MrMicek/AETS/diagramy diplomka svg flashka/photos/test setup.JPG

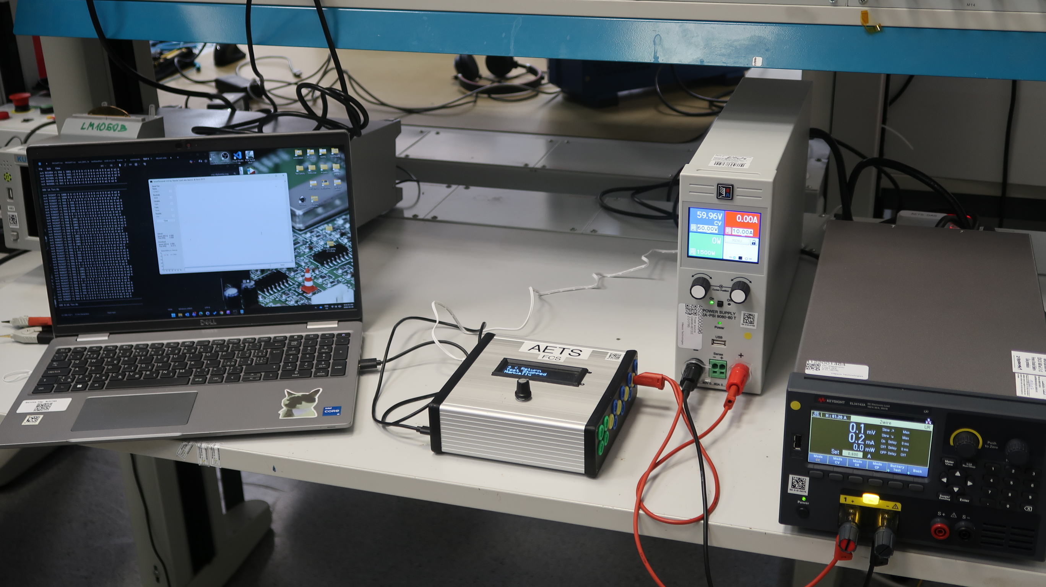
diagramy diplomka svg flashka/photos/test setup.JPG
