MrMicek/AETS/diagramy diplomka svg flashka/photos/final box test.JPG

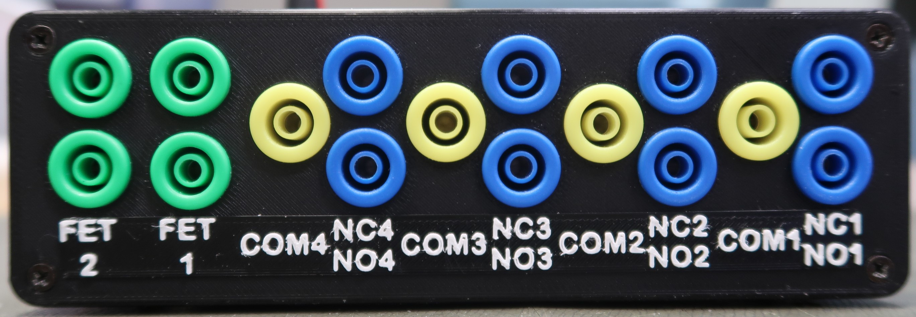
diagramy diplomka svg flashka/photos/final box test.JPG
