MrMicek/AETS/diagramy diplomka svg flashka/AETS_School_presentation.pptx

Převodník komunikace pro EMC komoru

## Automatizovaný systém pro elektrické testování komponent v automobilovém průmyslu

Autor:
Bc. Vojtěch Míček
Vedoucí práce:
doc. Ing. Hercík Radim, Ph.D.

## Body zadání

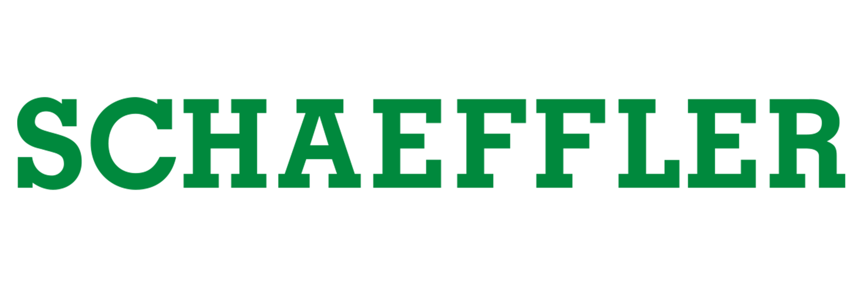
[picture p3: figure]
logo

- Návrh, výroba a otestování automatizovaného systému, který bude sloužit pro provádění elektrických testů automobilových komponent.
- Součástí řešení bude:
  - monitorování průběhu testu
  - Záznam o opotřebení el.mechanických součástek
  - Řízení pomocí PC

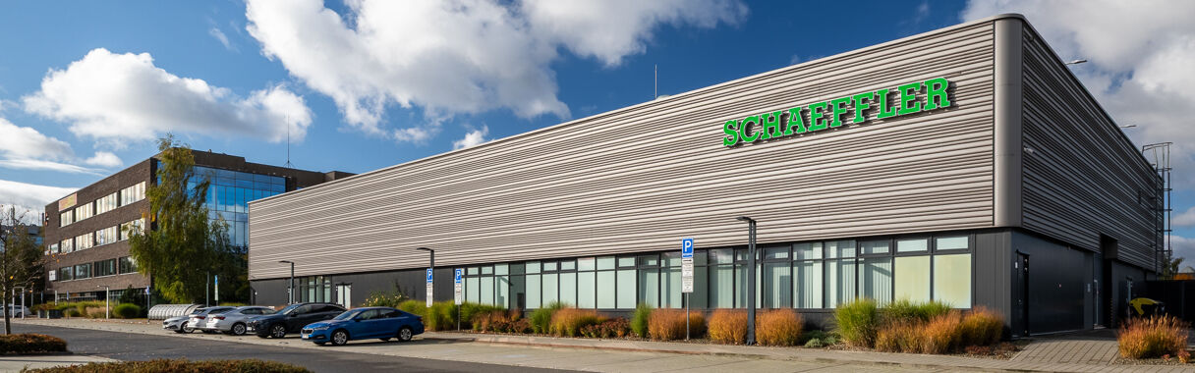
[picture p4: figure]
Schaeffler Motion Technologies CZ s.r.o. – Ostrava Hrabová image

## Účel zařízení

- Účel zařízení je poskytnou univerzální spínací platformu pro oddělení testování elektroniky, která zrychlí a zefektivní testovací procesy.
- Mezi hlavní testovací procesy pro které toto zařízení bylo vyvíjeno jsou ON/OFF testy a testování náběhových proudů.
- Možnost manuálního a vzdáleného řízení zařízení vytváří možnost rychlé přípravy testu a jejich automatizaci s kombinací softwarových aplikací např. LabVIEW.

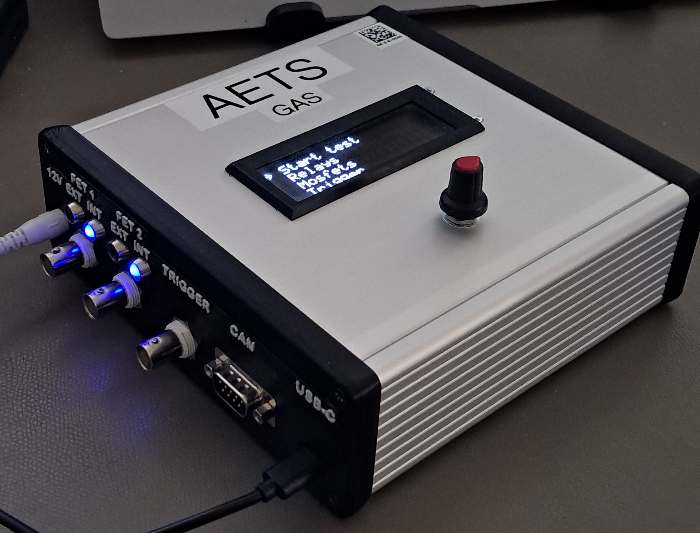
[picture p5: figure]

## Analýza výchozího stavu

- Zařízení má nahradit současné obvody v laboratoři (viz. foto) a poskytnout univerzální platformu, která zkombinuje relé a MOSFETové spínací prvky.

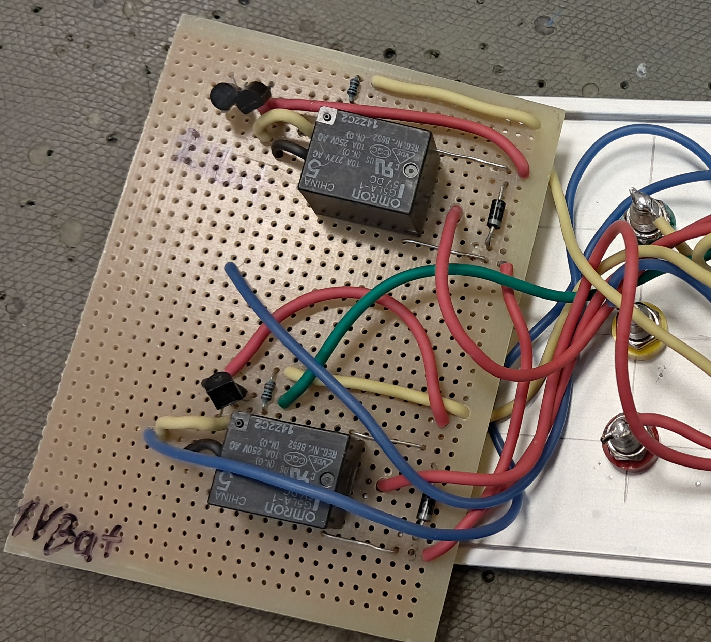
[picture p6: figure]
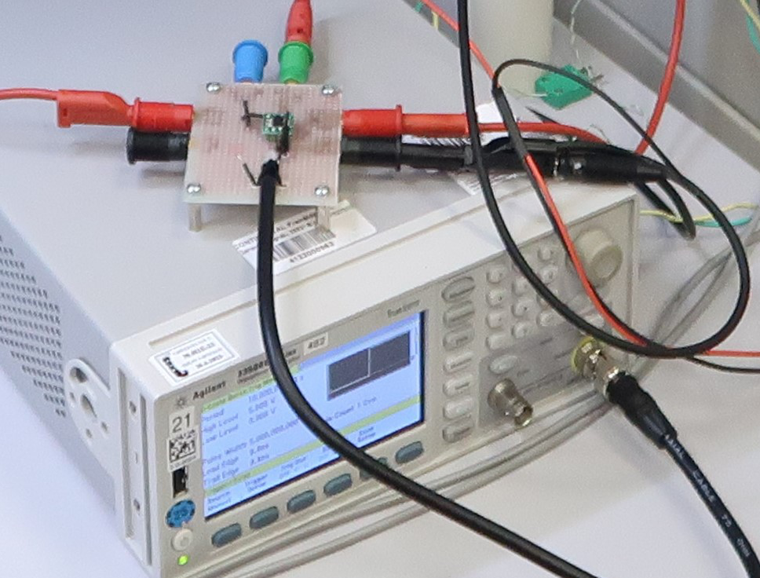
[picture p7: figure]
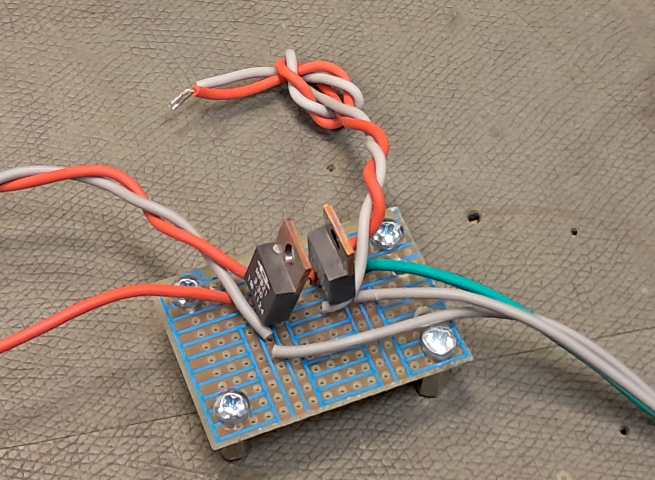
[picture p8: figure]

## Návrh funkce zařízení

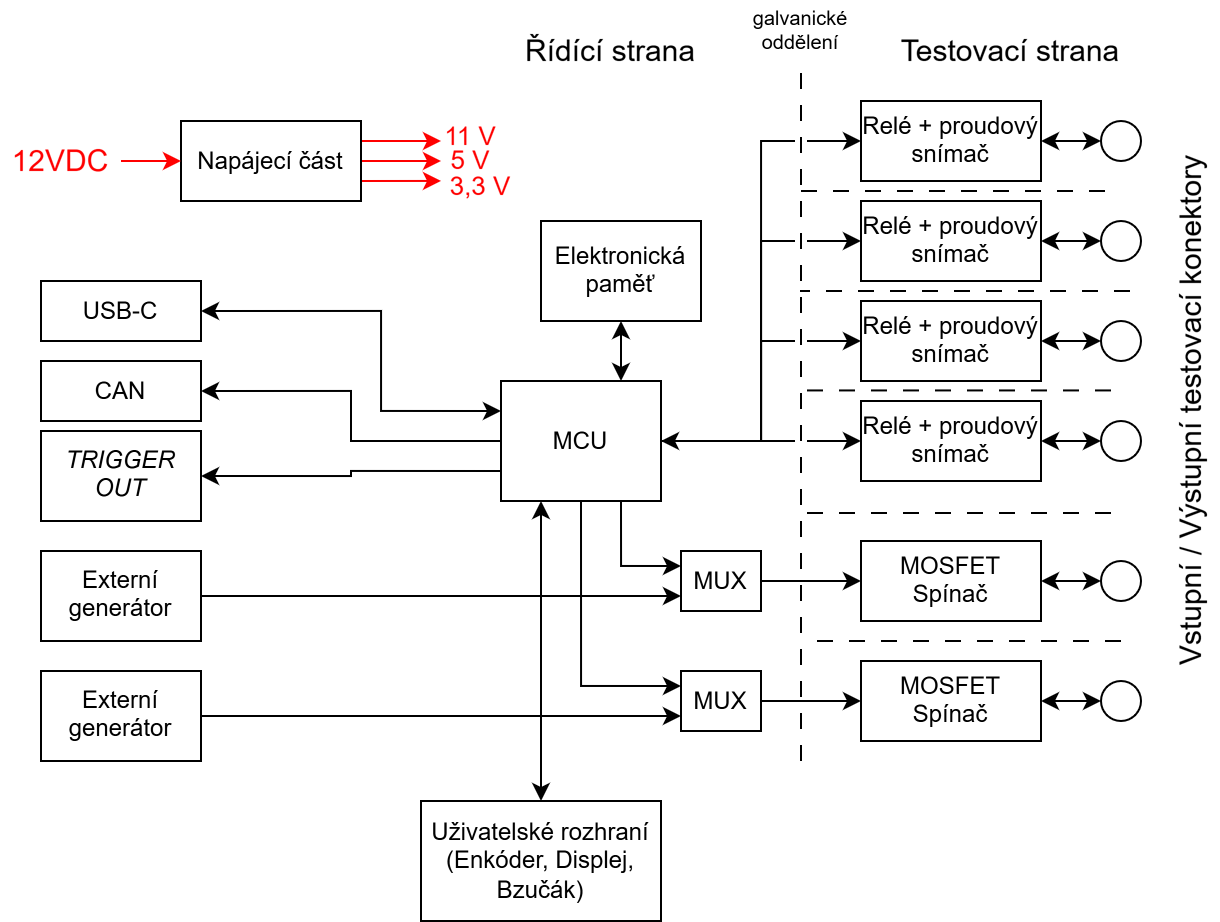
[picture p9: figure]

- Testovací inženýr nastaví pomocí uživatelského rozhraní nebo příkazy parametry řízení testovacích periferií.
- Galvanické oddělení mezi řídící a testovací stranou
- K dispozici přídavné funkce:
  - Výstupní trigger signal pro synchronizaci
  - Řízení MOSFETů pomocí externích generátorů
  - Ukládání dat do elektronické paměti (profily s nastavením, zbývající počet cyklů relé)

## Průběh návrhu zařízení

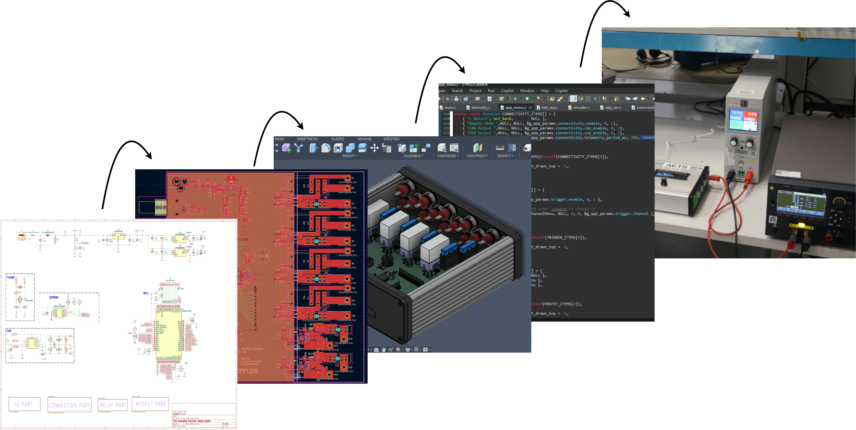
[picture p10: figure]

Testování

Relizace HW

Kód (C)

3D model

Návrh PCB

Schéma

## Schema + deska - realizace

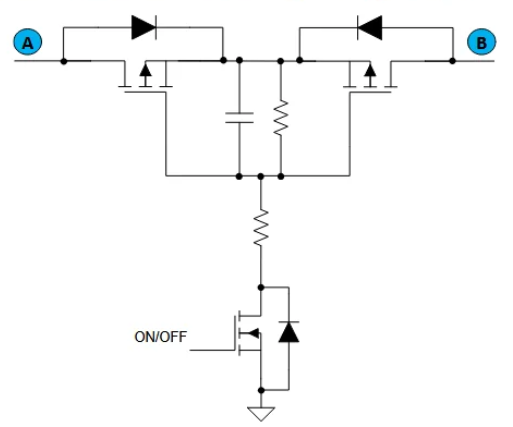
[picture p11: figure]

Popsat periferie? Zmínit vyměnitelnost HW? Jednoduchost používání pro Testaře? Nějaké schéma?

## Body zadání

Záznam o opotřebení el.mechanických součástek

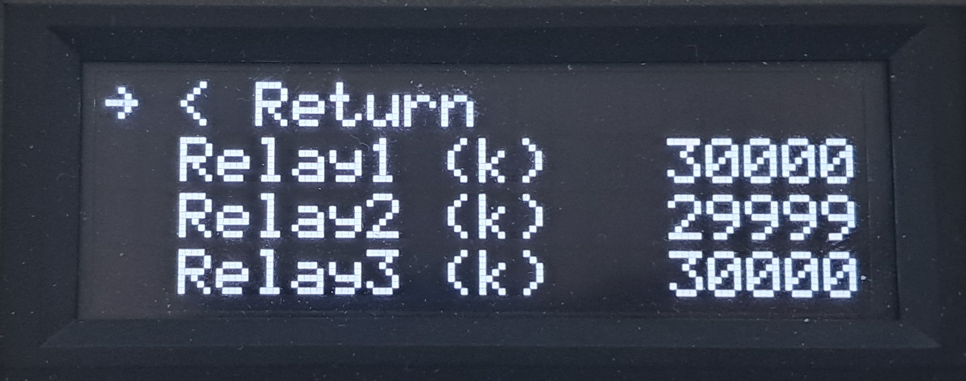
[picture p12: figure]

Interní sledovač proudu

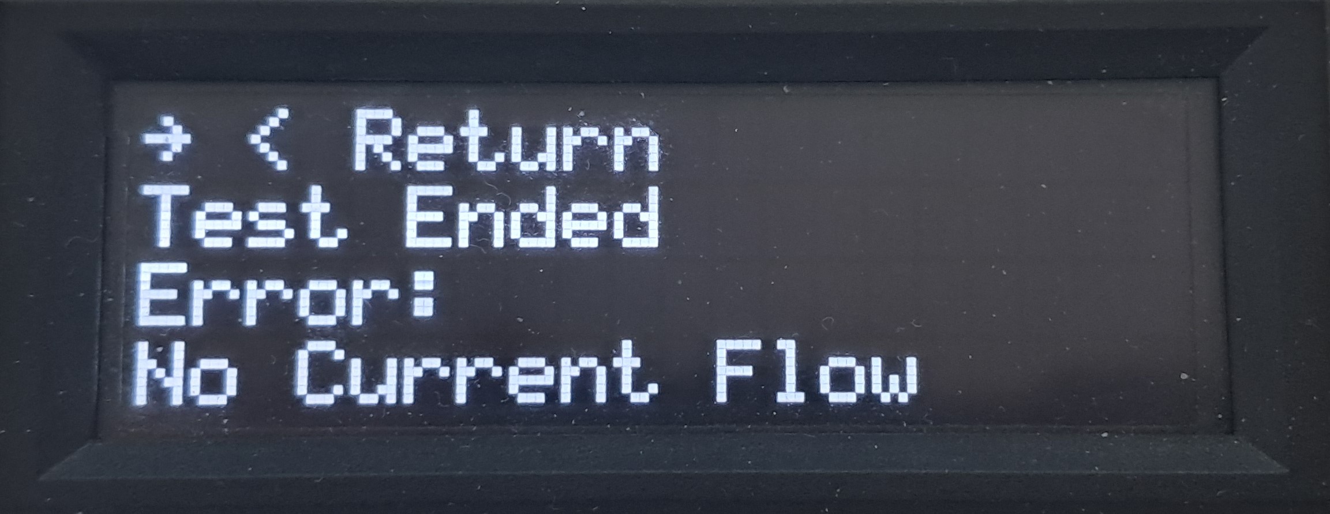
[picture p13: figure]

Řízení pomocí PC

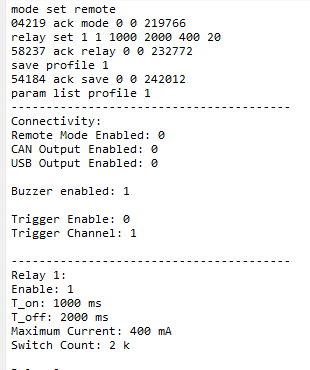
[picture p14: figure]
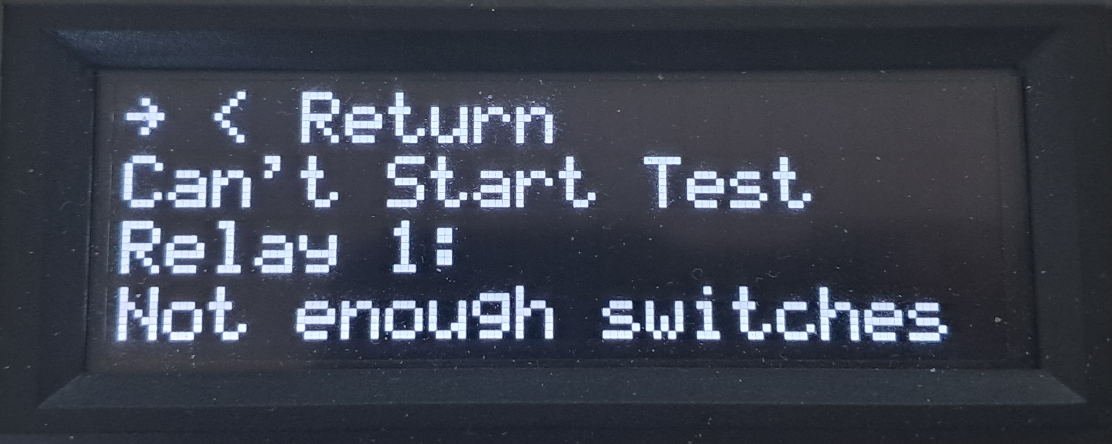
[picture p15: figure]
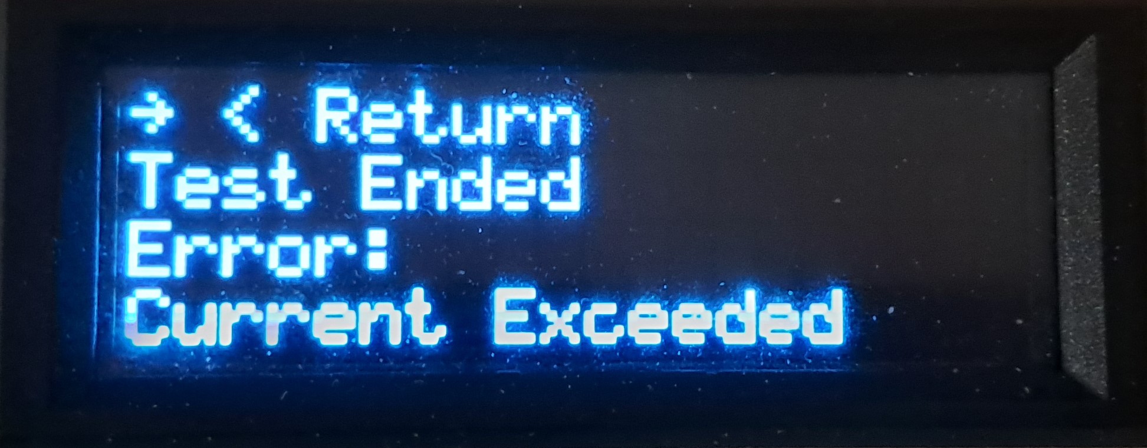
[picture p16: figure]

## Deska plošných spojů

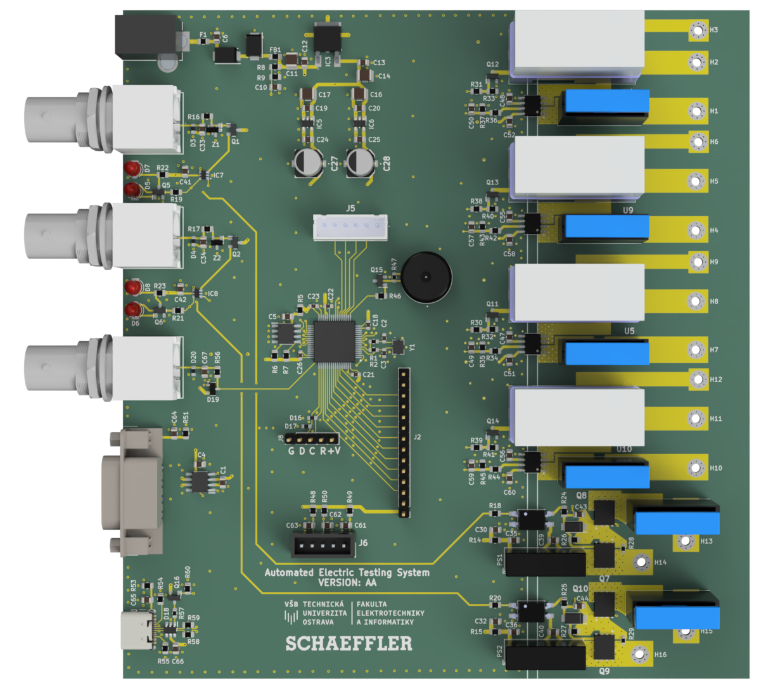
[picture p17: figure]
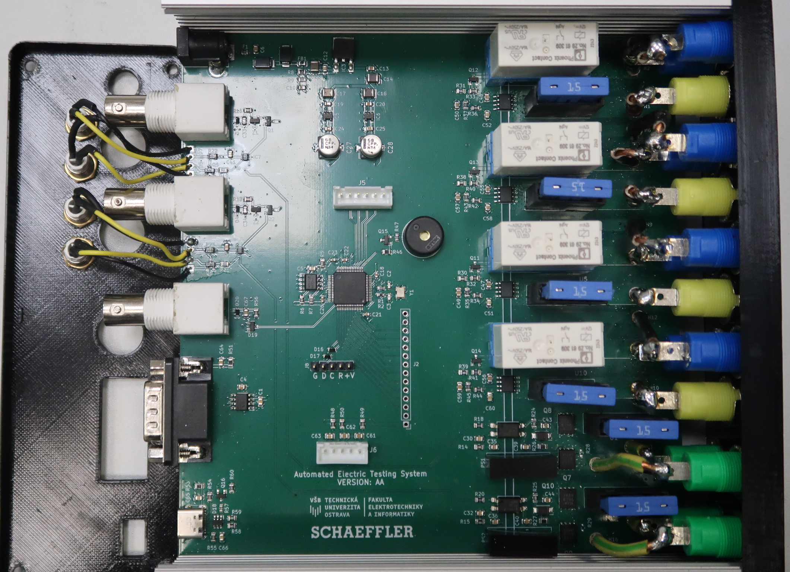
[picture p18: figure]

## Popis použití a parametrů periferií

Nastavení způsobu ovládání
Nastavení parametrů jednotlivých kanálů
Zapnutí testu
Sledování průběhu testování
Vyhodnotit výsledky testu

Relé
- Aktivace kanálu
- doba zapnutí
- doba vypnutí
- počet cyklů
- vnitřní mezní hodnoty proudu

MOSFETy
- Aktivace kanálu
- doba zapnutí
- doba vypnutí
- volba interního nebo externího řízení
- počet cyklů

Systémová konfigurace
- Nastavení výstupního trigger
- Nastavení komunikace
- Ukládání nastavení parametrů v profilech
- Aktivace interního sledování proudu

## Maximální testovací parametry

Relé

4 kanály
Trvalý proud na větev:
Min. proud: 10 mA*
Max. proud: 2.5 A
Max. spínané napětí: 60 VDC

MOSFETy

2 páry obousměrných MOSFETů
Trvalý proud na pár:
Max. proud: 5 A
Max. náběžný proud(<300 µs): 40 A
Max. spínané napětí : 80 VDC

Dynamika spínání

Typická doba odezvy relé: 7 ms
Typická doba vypnutí relé: 3 ms
Doba odskoku relé: ~2 ms
MOSFET čas náběžné hrany:
min: 700 ns max: 1000 µs
MOSFET čas sestupné hrany:
min: 2 µs max: 4 µs

## Testování Firmware

## Testování zařízení – spínání relé

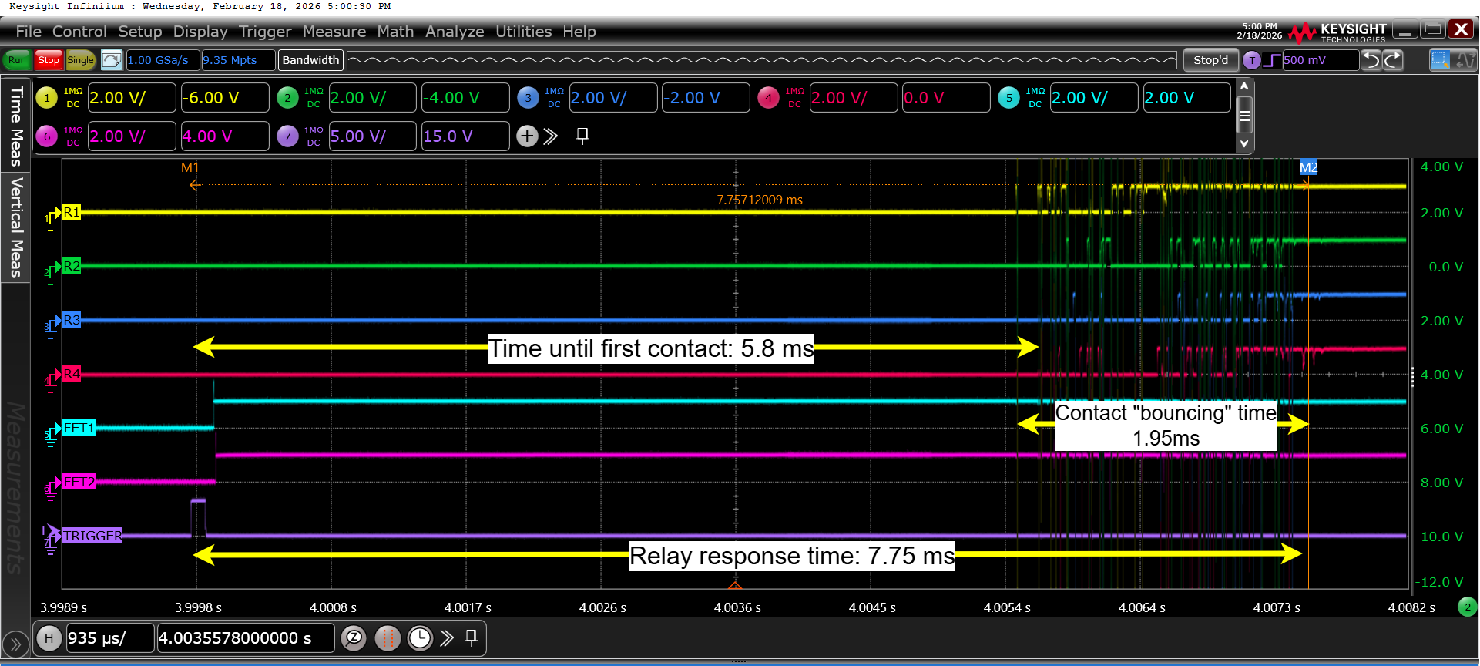
[picture p19: figure]
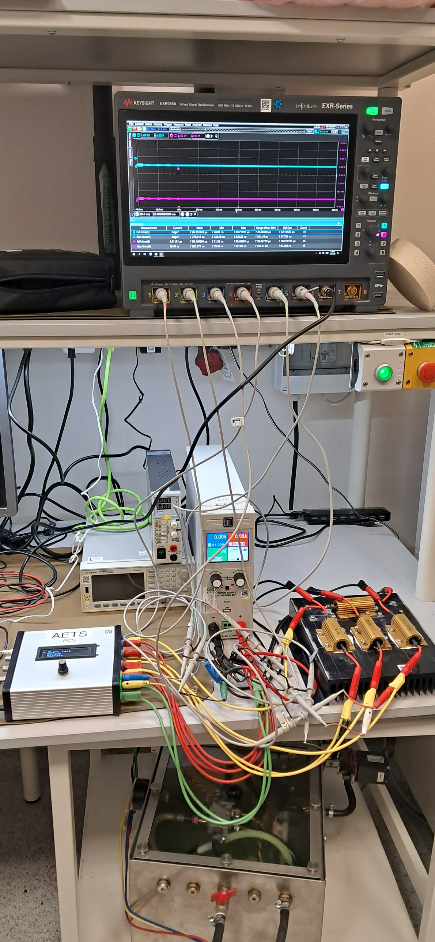
[picture p20: figure]

## Testování zařízení – rychlost MOSFETů

Rise time

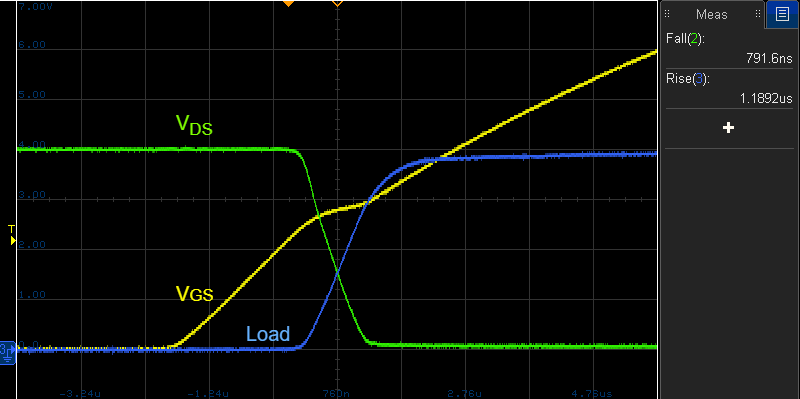
[picture p21: figure]

Fall time

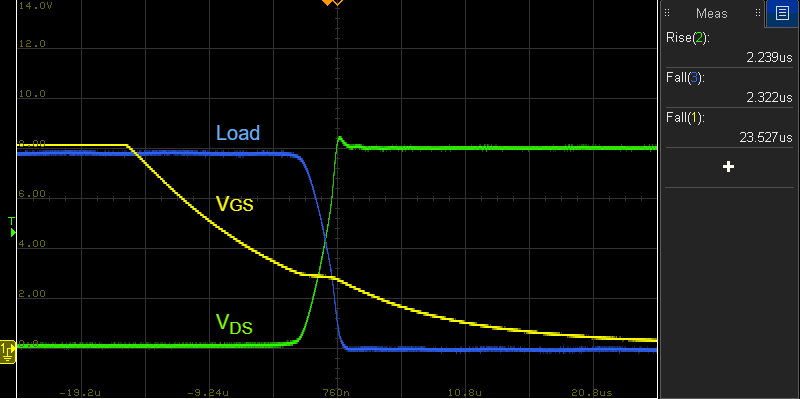
[picture p22: figure]

## Testování zařízení – náběhový proud

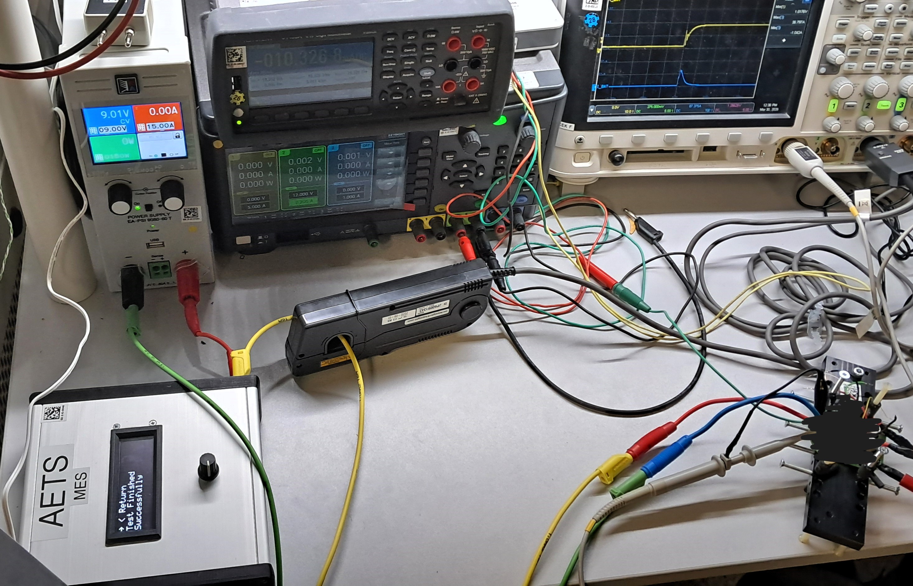
[picture p23: figure]
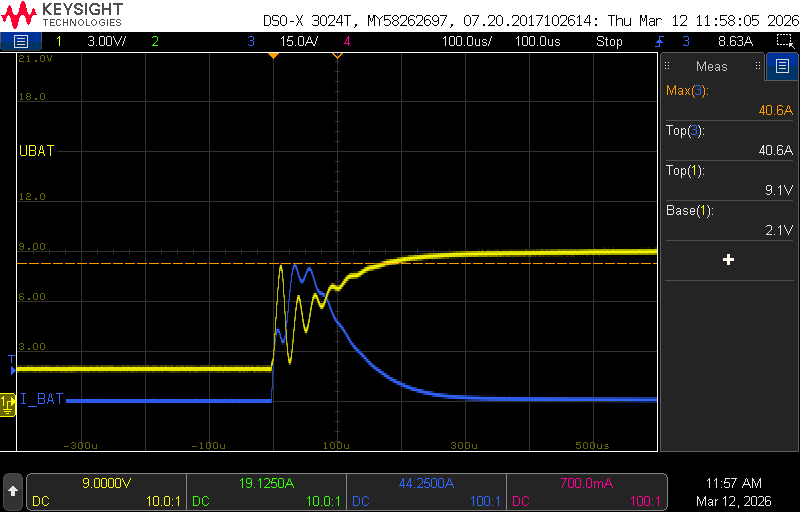
[picture p24: figure]

## shrnutí

## Slide 18

Děkuji za pozornost
