MrMicek/AETS/diagramy diplomka svg flashka/AETS_Presentation.pptx

## Introduction to E-BOX AETS

Vojtěch Míček
16.4.2026

Diploma thesis: E-BOX AETS

## Basic description of the system

- Diploma thesis: E-box aets

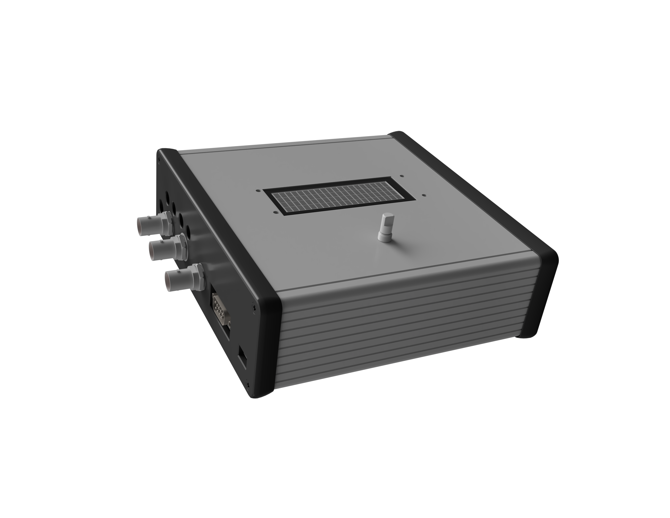
[picture p25: figure]

AETS
Automated Electrical Testing System

Laboratory equipment for electrical testing of automotive components
Combines relay and MOSFET branches, local UI and PC control
Designed for faster, repeatable, safer and easier testing

## Why was the device developed?

- Diploma thesis: E-box aets

Need in practice

Acceleration of repetitive electrical tests
Universal platform across EE Teams
Reproducibility of test sequences.

What it does

Switching of tested branches
Basic internal supervision of test progress
Communication with host PC with option to remotely control the device

Typical usage

ON/OFF tests
Switching sequences
Fast switching for INRUSH current testing
Long-term cyclic tests

## Brief description of how the system works

- Diploma thesis: E-box aets

PC/LabView
Manual setup
MCU logic & sequence control
Relays
MOSFETs
DUT
Measurement
devices

Relays
Low contact resistance (~15mΩ), suitable for normal ON/OFF sequences and long-term cycles

MOSFETs
Bidirectional structure, short pulses, and monitoring of transient signals.

Additional functions
Advanced UI, Trigger, Relay cycle counter & current monitoring, External MOSFET control

## Brief description of how the system works

- Diploma thesis: E-box aets

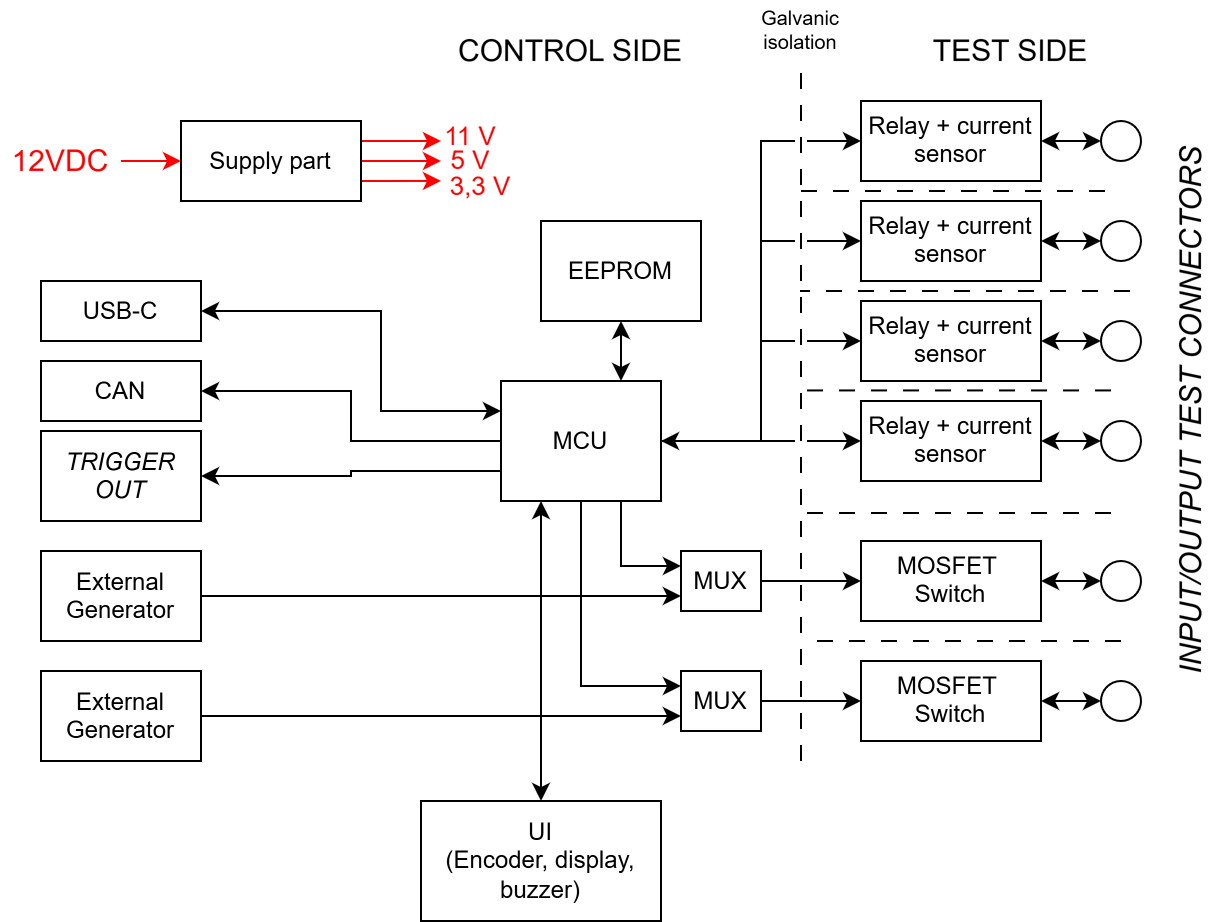
[picture p26: figure]

## Connectors and interfaces

- Diploma thesis: E-box aets

Control Connectors

- 12 V DC power supply jack
- 2x BNC input for external control of MOSFETs
- BNC TRIGGER output for synchronization
- DSUB-9 CAN OUTPUT for extended communication
- USB for connection to a PC and remote control

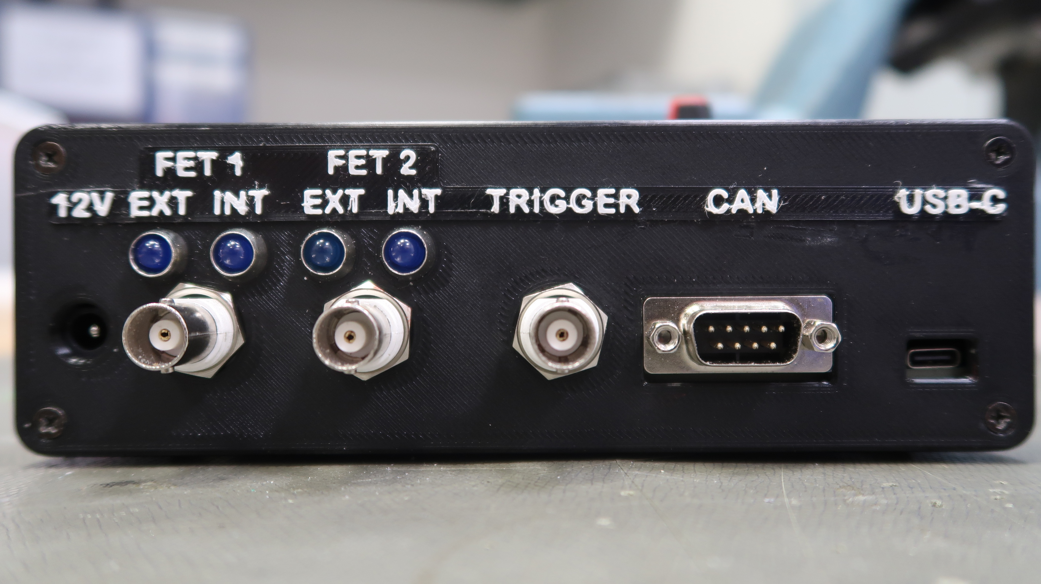
[picture p27: figure]
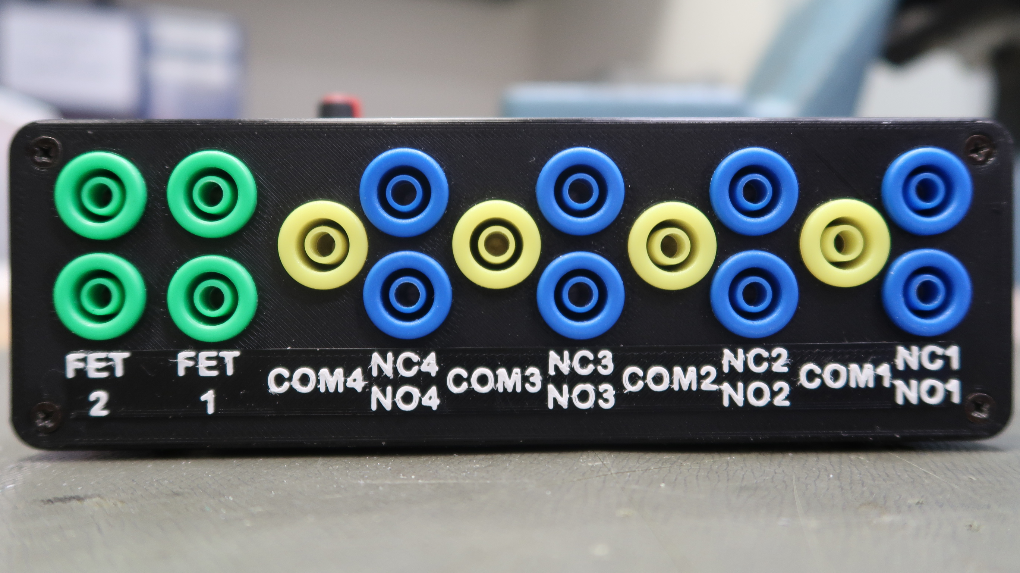
[picture p28: figure]

Test Connectors

  - 4 Relay Branches
  - 2 MOSFET switch pairs

## Complete Assembly

- Diploma thesis: E-box aets


## System configuration

- Diploma thesis: E-box aets

Relays
Channel enable, turn-on time, turn-off time, number of cycles, and internal current control limits.

MOSFETs
Channel enable, turn-on time, turn-off time, internal or external control selection, and number of cycles.

System options
Trigger, communication and data storage in profiles.

Select control mode
Configure channels and timing
Run test
Monitor test progress
Evaluate test results

## System configuration

- Diploma thesis: E-box aets

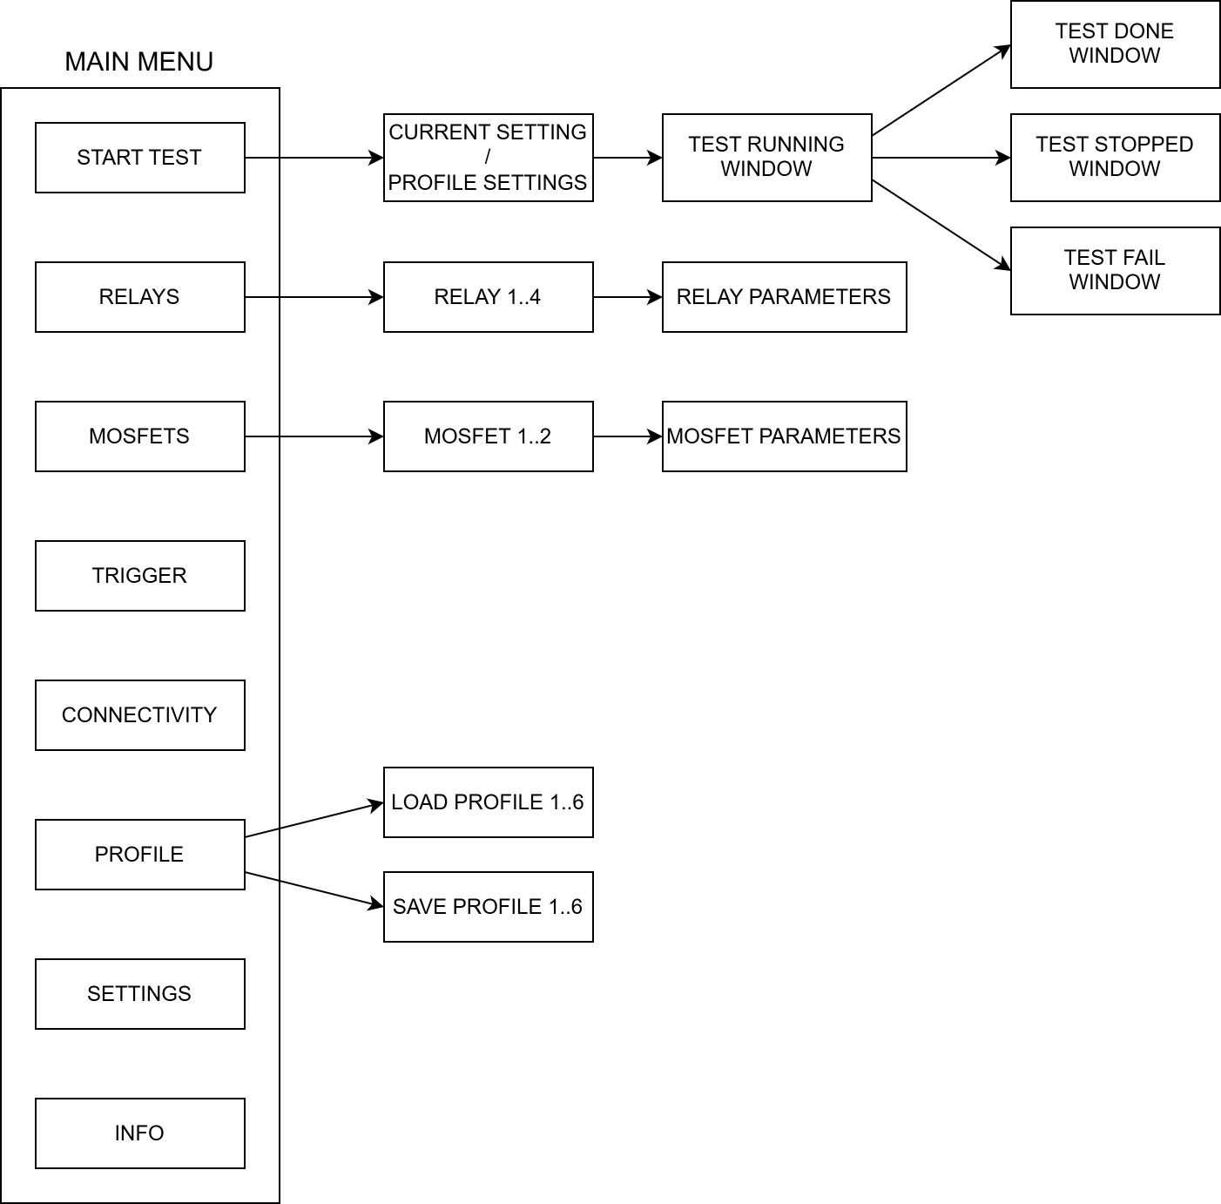
[picture p29: figure]
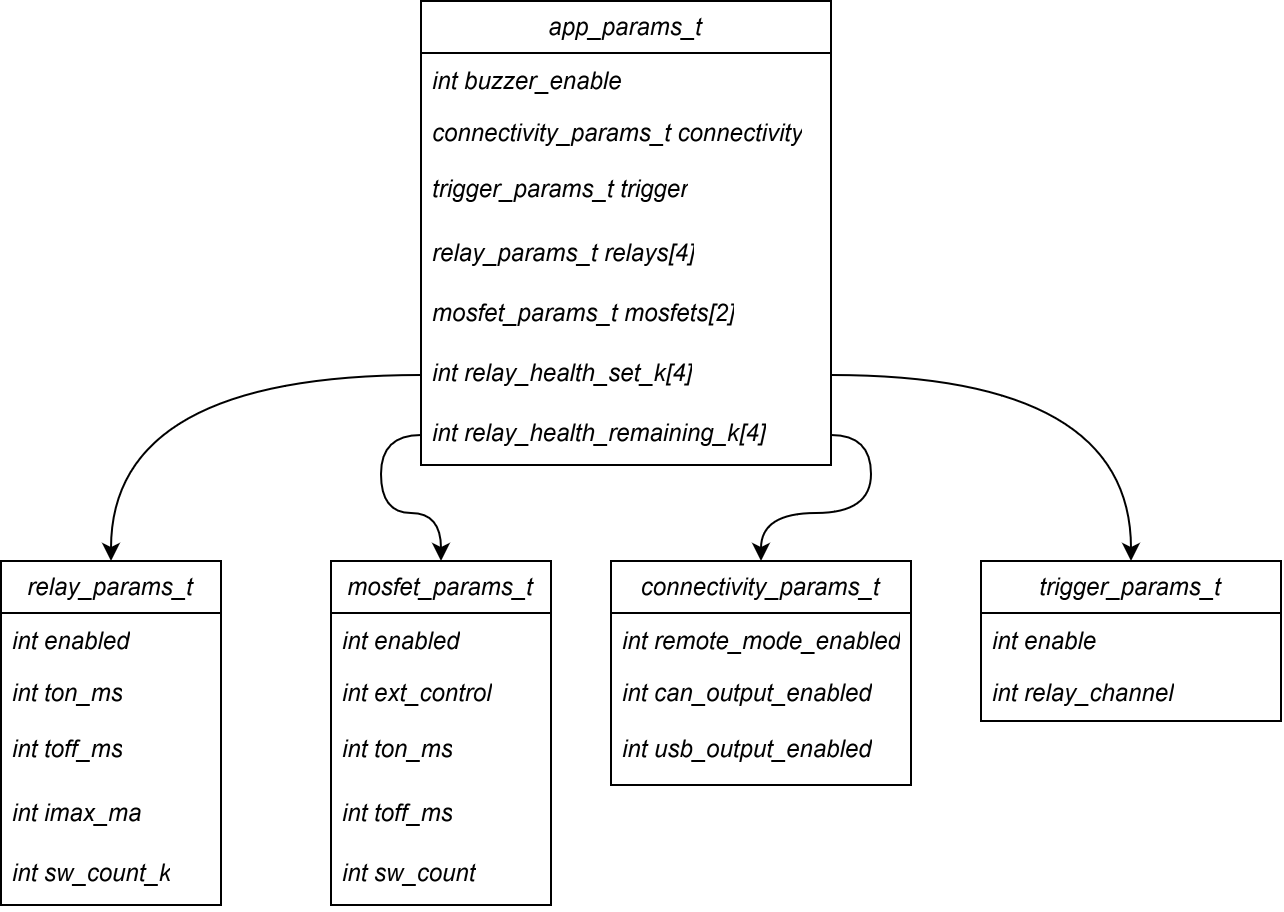
[picture p30: figure]

## Basic navigation and modes

- Diploma thesis: E-box aets

MANUAL
Local operation via display and encoder. Suitable for quick function checks, servicing, and simple sequences.

REMOTE
Control from a PC via USB. Suitable for automation and integration into laboratory workflow.

TEST
Run sequence with supervision. In case of failure, the system will switch to a safe state and report the error.

The display shows the basic status of the device, function selection, and test progress.
The encoder is used to navigate the menu, change parameters, and confirm selections.
The system can be controlled remotely using commands and telemetry/status information can be obtained.
Important operating data is stored in EEPROM and is retained in the event of a brownout.

## Basic navigation and modes

- Diploma thesis: E-box aets

MANUAL

REMOTE

TEST

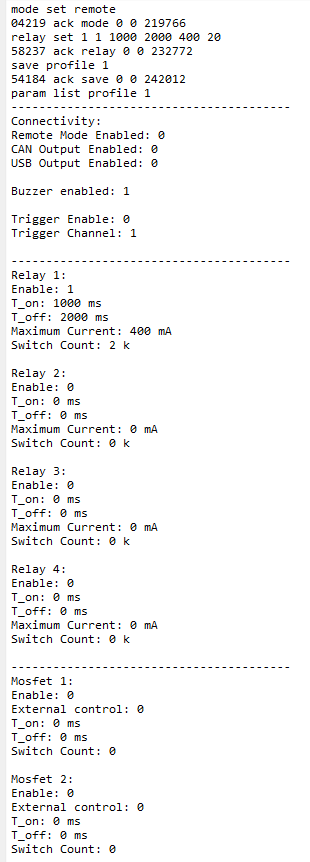
[picture p31: figure]
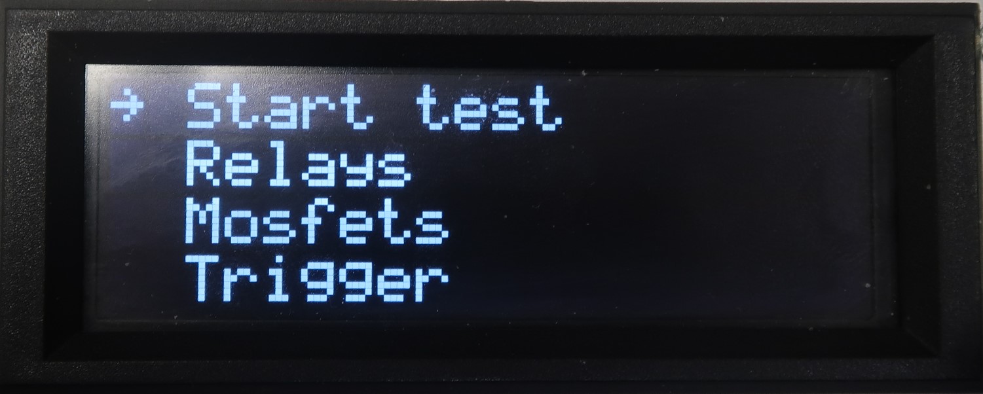
[picture p32: figure]
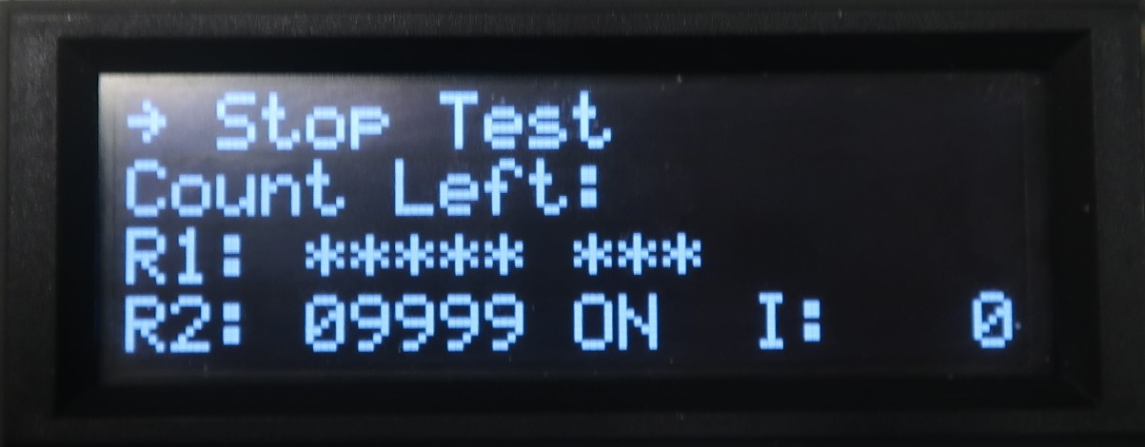
[picture p33: figure]
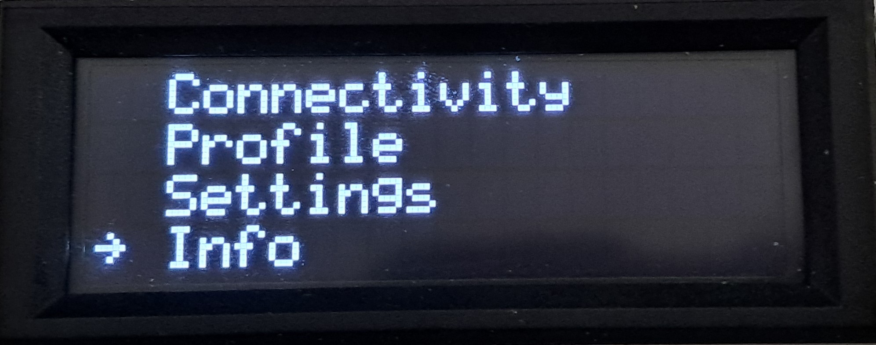
[picture p34: figure]
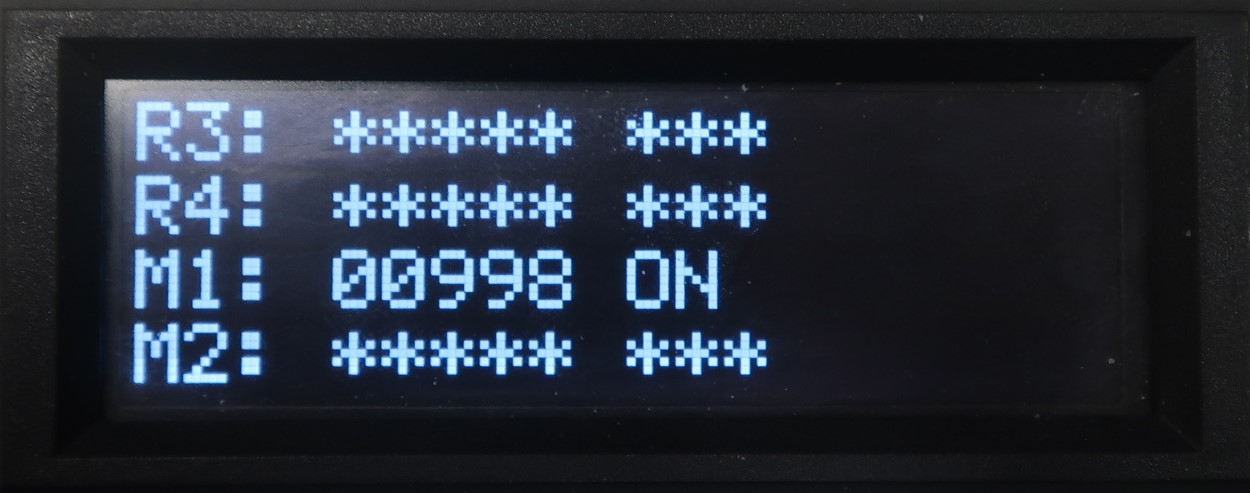
[picture p35: figure]

## Post-test screens

- Diploma thesis: E-box aets

DONE

STOPPED

FAULT

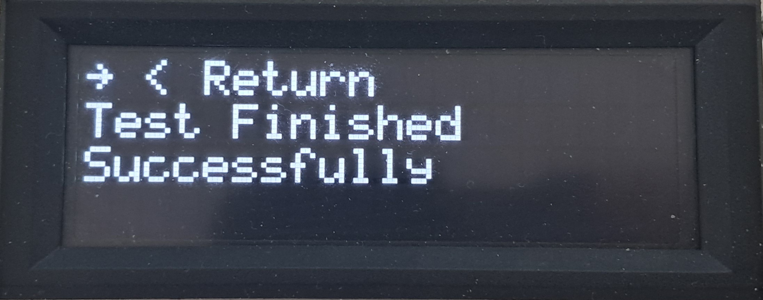
[picture p36: figure]
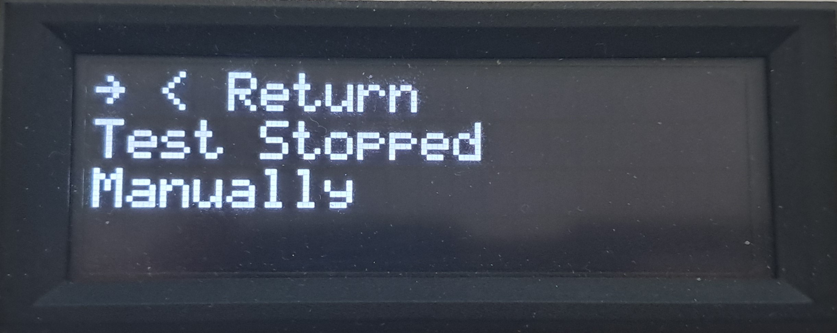
[picture p37: figure]

## Relay cycle counter managment

- Diploma thesis: E-box aets

Switch count value
The value of the number of switches was determined from datasheet and verified in test to be 3 million cycles.

Brownout event
If supply voltage of the device drops below a certain threshold, the device will stop all the current operations and save all important data to EEPROM. This includes relay cycles.


Prevention of excess relay use

If you set switch count higher, than the relay has remaining, this screen will appear to notify you.
You can’t start a test in this condition.

## Reading/editing relay cycles

- Diploma thesis: E-box aets

Remain Count
read only information


Relay menu screen

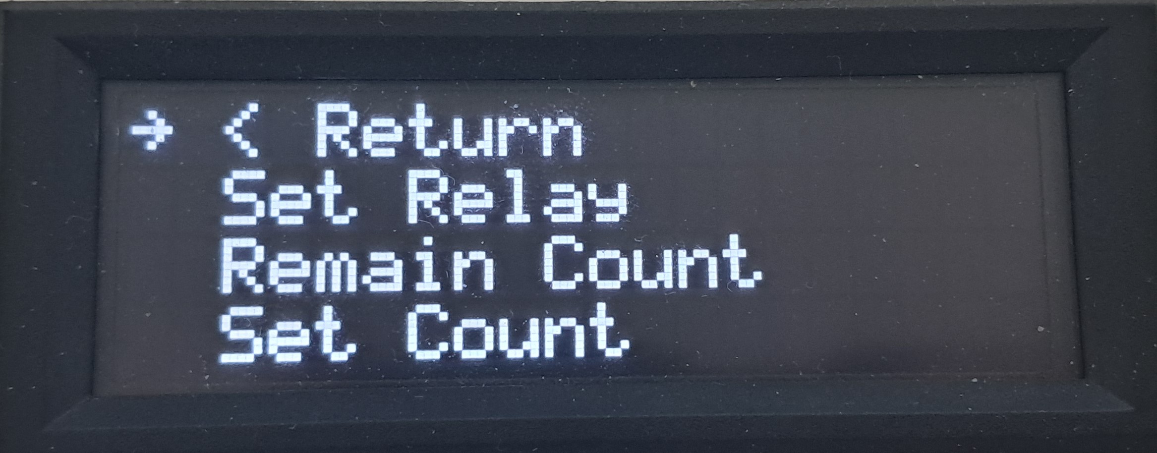
[picture p38: figure]

Set Count
read/write information

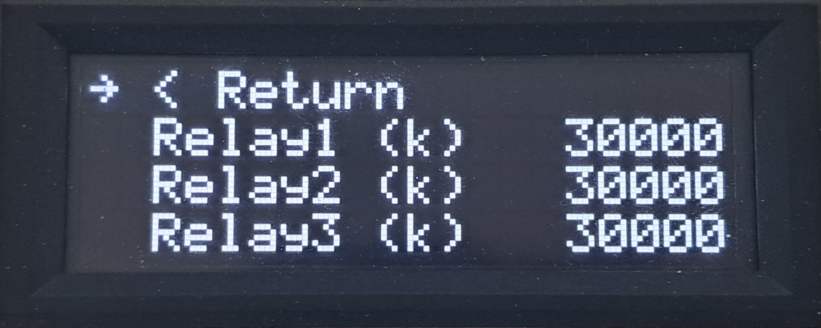
[picture p39: figure]

## Maximum values and performance

- Diploma thesis: E-box aets

RELAYS

4 channels
Continuous current per branch:
Min. current: 10 mA
Max. current: 2.5 A
Max. switching voltage: 60 VDC

MOSFETS

2 pairs of back-to-back MOSFETs
Continuous current per pair:
Max. current: 2.5 A
Max. inrush current (<300 µs): 40 A
Max. switching voltage: 80 VDC

Switching dynamics

Relay typical response time: 7 ms
Relay typical release time: 3 ms
Relay bounce time: ~2 ms
MOSFET rise time:
min: 700 ns max: 1000 µs
MOSFET fall time:
min: 2 µs max: 4 µs

## Relay response time test

- Diploma thesis: E-box aets

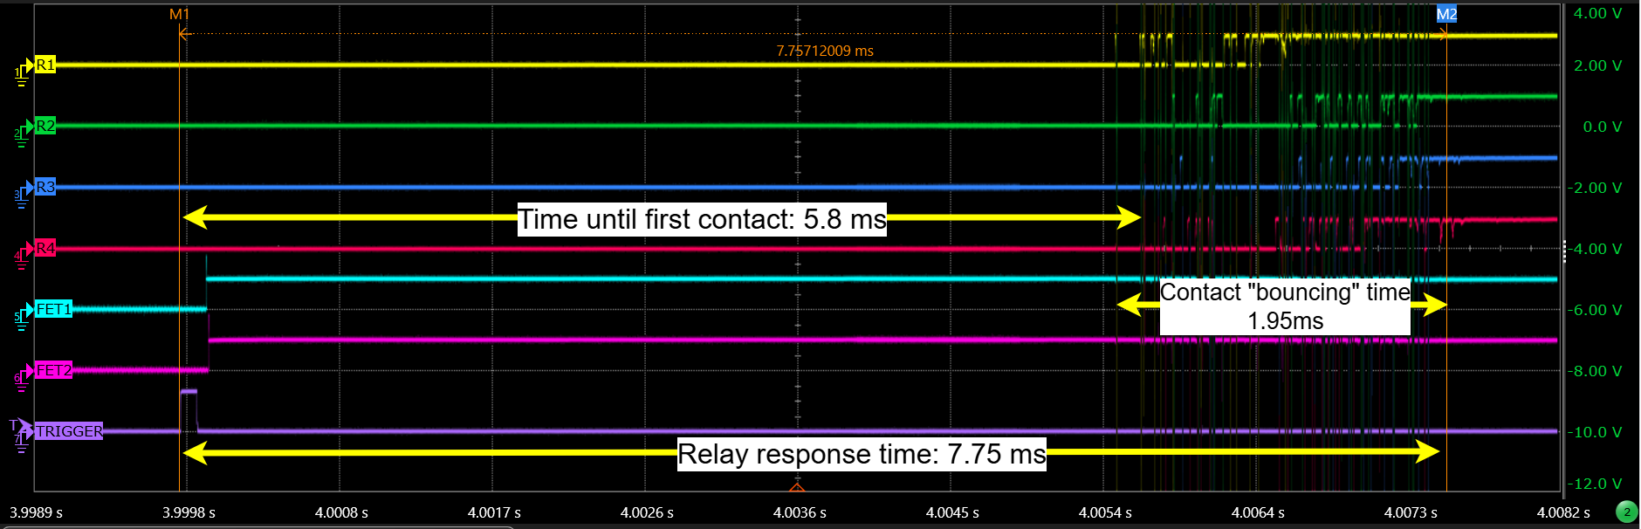
[picture p40: figure]

## MOSFET inrush current test – peak current test

- Diploma thesis: E-box aets


## MOSFET inrush current test – rise & fall time

- Diploma thesis: E-box aets

Rise time


Fall time


## How can the system make work easier for test engineers?

- Diploma thesis: E-box aets

Faster repetition of test sequences without manual switching
Integration of multiple switching options into a single device
Ability to control the test locally or remotely from a PC depending on the type of task
Easier synchronization with an oscilloscope or generator via trigger/BNC inputs
Storage of operating data and basic diagnostics of error states
Suitable basis for further expansion of test scenario automation in the laboratory

Conclusion

AETS is a practical laboratory platform that combines:
robust switching
fast MOSFET actions
local and remote control
simple measurement synchronization
Goal: to simplify and speed up electrical component testing.

## Slide 20

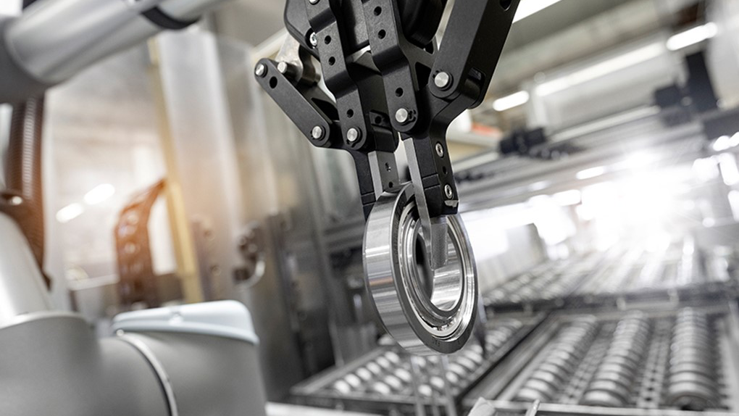
[picture p41: figure]

THANK YOU

## Slide 21
