MrMicek/AETS/diagramy diplomka svg flashka/diagramy diplomka svg/PLOTS/AETS-CZ-NB-3L0Y7S3_3D_BOT.png

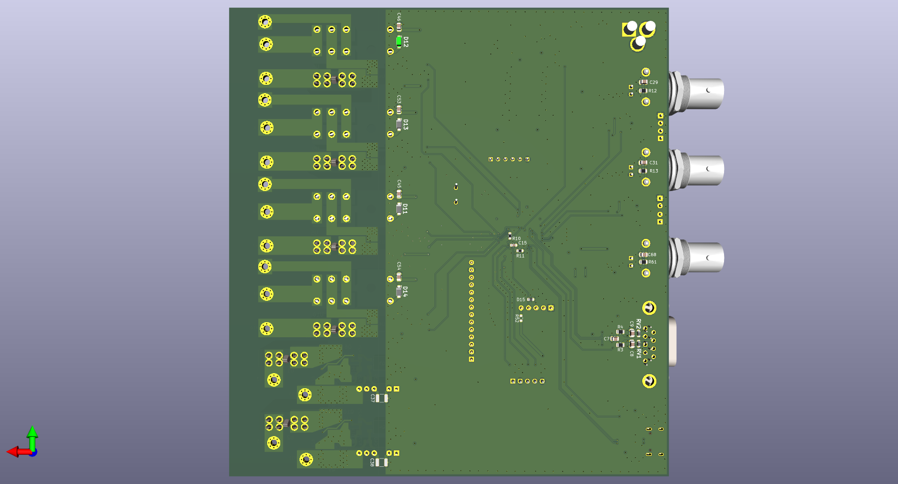
diagramy diplomka svg flashka/diagramy diplomka svg/PLOTS/AETS-CZ-NB-3L0Y7S3_3D_BOT.png
