MrMicek/AETS/diagramy diplomka svg flashka/diagramy diplomka svg/PLOTS/PCB/PCB BOX.png

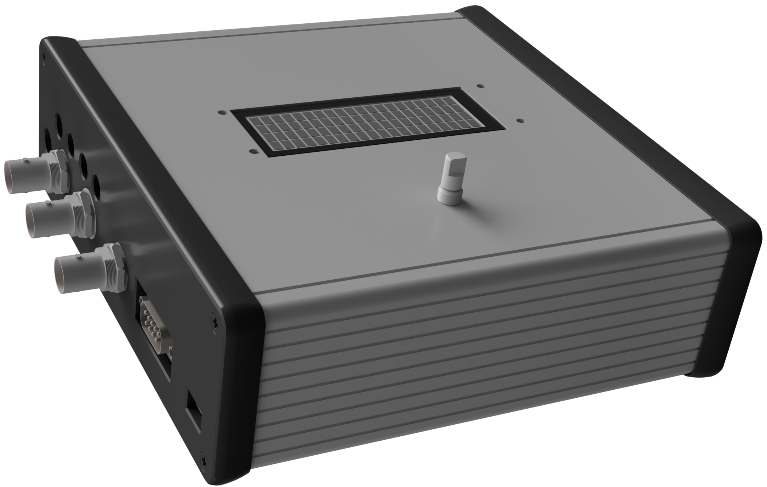
diagramy diplomka svg flashka/diagramy diplomka svg/PLOTS/PCB/PCB BOX.png
