MrMicek/AETS/diagramy diplomka svg flashka/diagramy diplomka svg/PLOTS/PCB/PCB.png

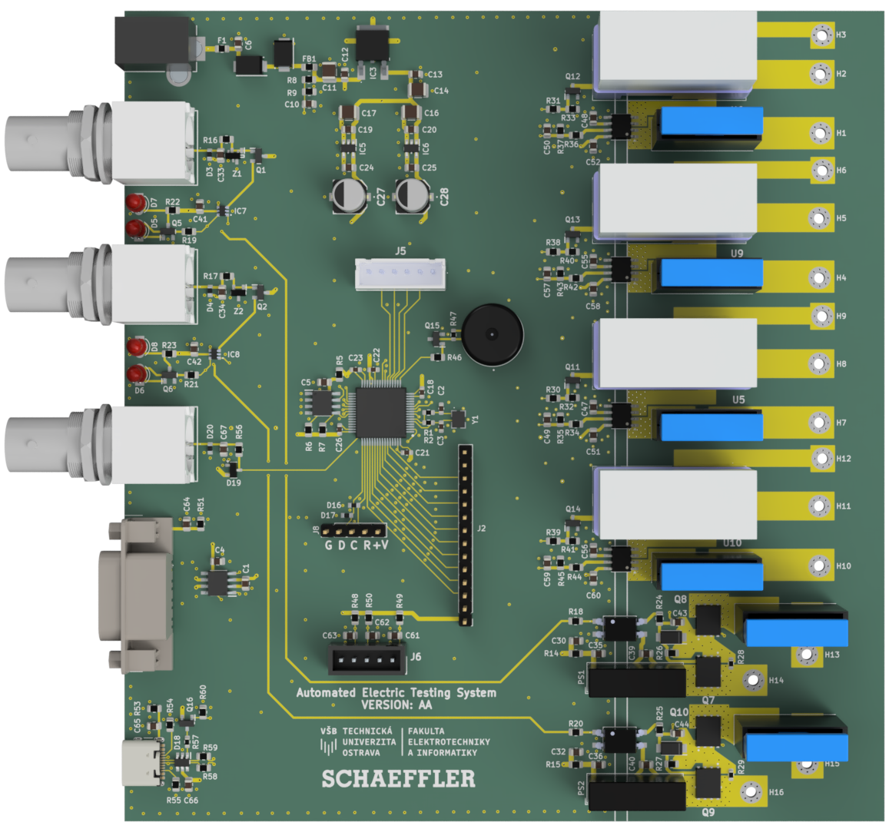
diagramy diplomka svg flashka/diagramy diplomka svg/PLOTS/PCB/PCB.png
