MrMicek/AETS/diagramy diplomka svg flashka/photos/20250919_095414.jpg

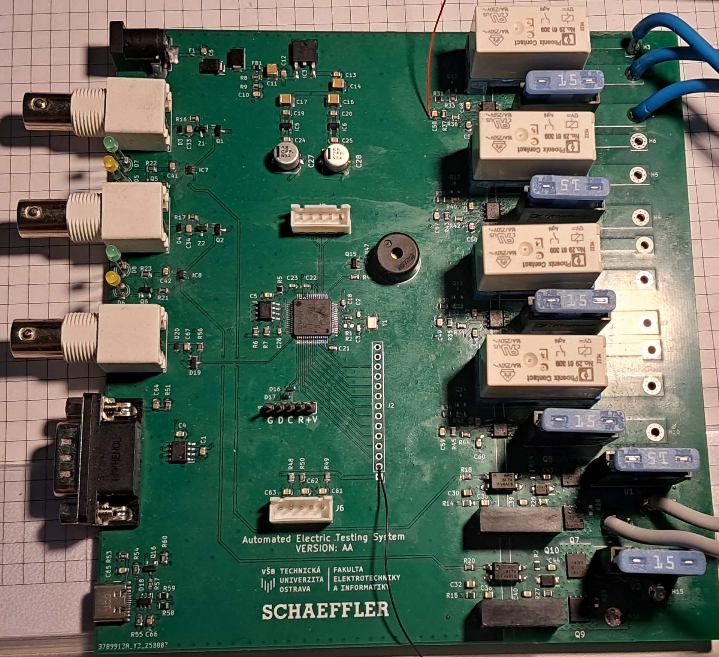
diagramy diplomka svg flashka/photos/20250919_095414.jpg
