MrMicek/AETS/diagramy diplomka svg flashka/photos/20260312_124507.jpg

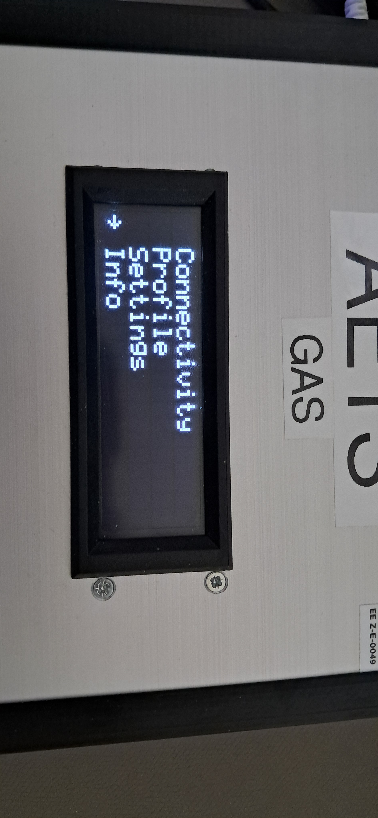
diagramy diplomka svg flashka/photos/20260312_124507.jpg
