MrMicek/AETS/diagramy diplomka svg flashka/photos/20260316_082853.jpg

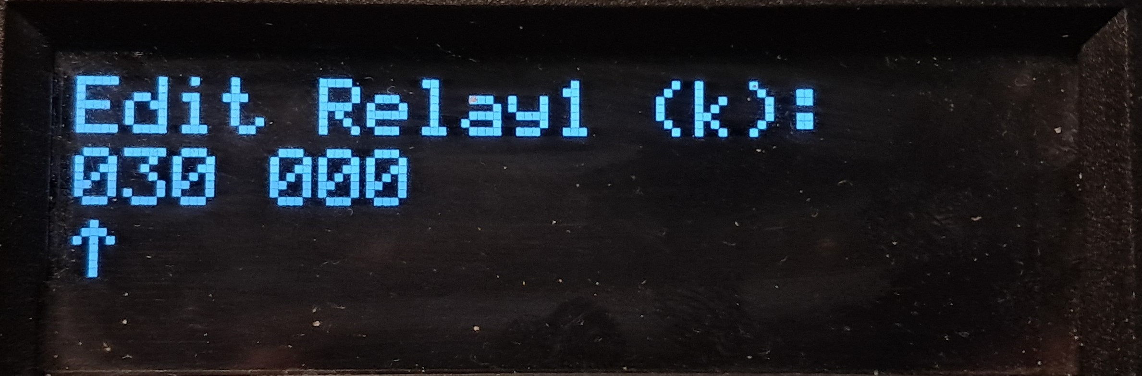
diagramy diplomka svg flashka/photos/20260316_082853.jpg
