MrMicek/AETS/diagramy diplomka svg flashka/photos/20260330_122323.jpg

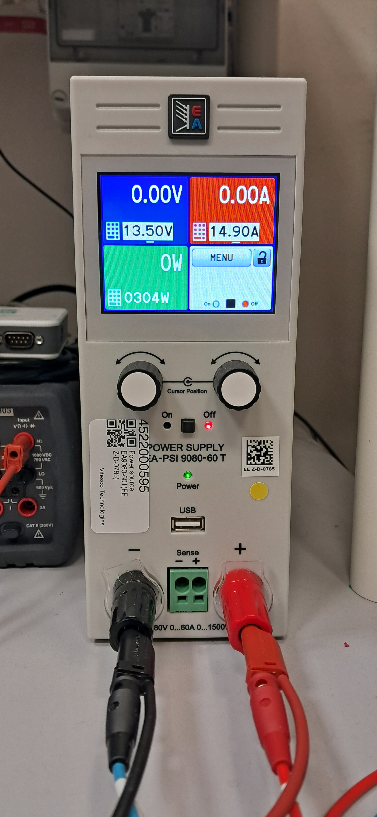
diagramy diplomka svg flashka/photos/20260330_122323.jpg
