MrMicek/AETS/diagramy diplomka svg flashka/photos/20260330_122909.jpg

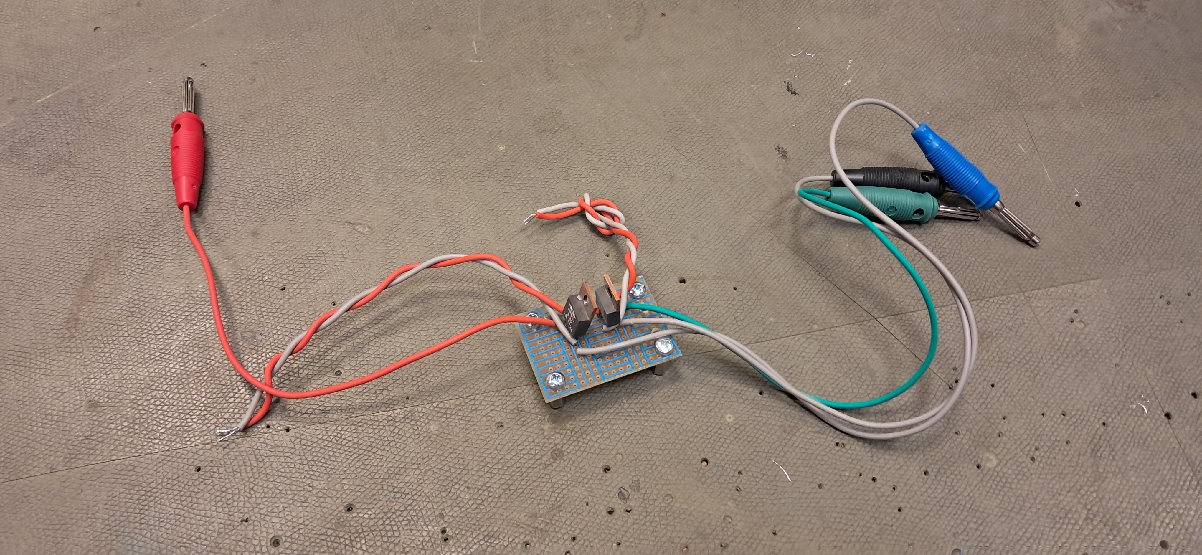
diagramy diplomka svg flashka/photos/20260330_122909.jpg
