MrMicek/AETS/diagramy diplomka svg flashka/photos/disasembly/disasembly1.png

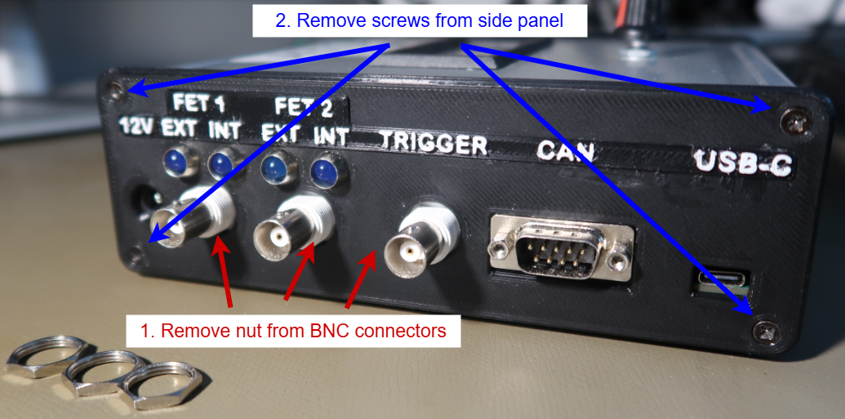
diagramy diplomka svg flashka/photos/disasembly/disasembly1.png
