MrMicek/AETS/diagramy diplomka svg flashka/photos/disasembly/disasembly2.png

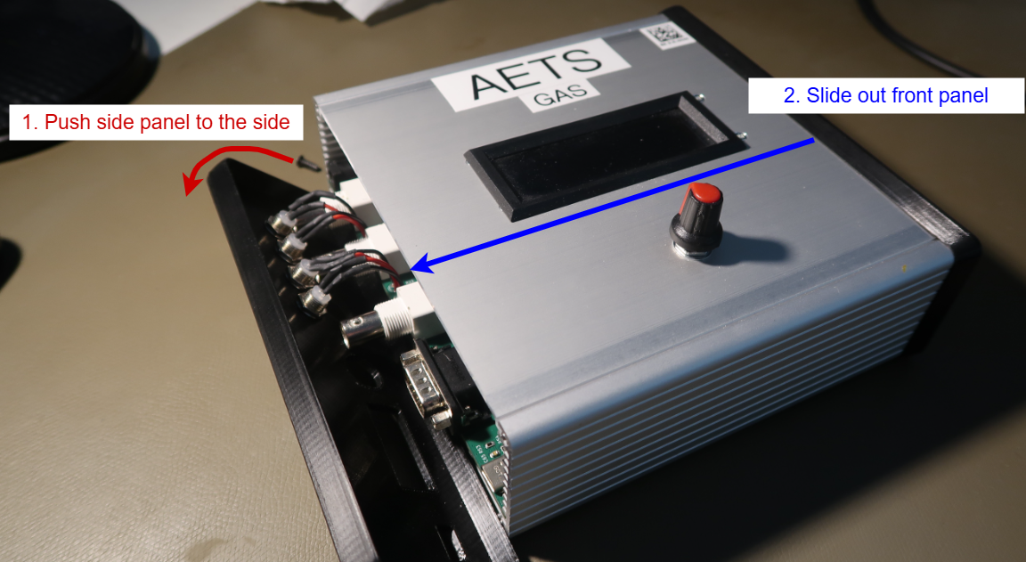
diagramy diplomka svg flashka/photos/disasembly/disasembly2.png
