MrMicek/AETS/diagramy diplomka svg flashka/photos/disasembly/disasembly3.png

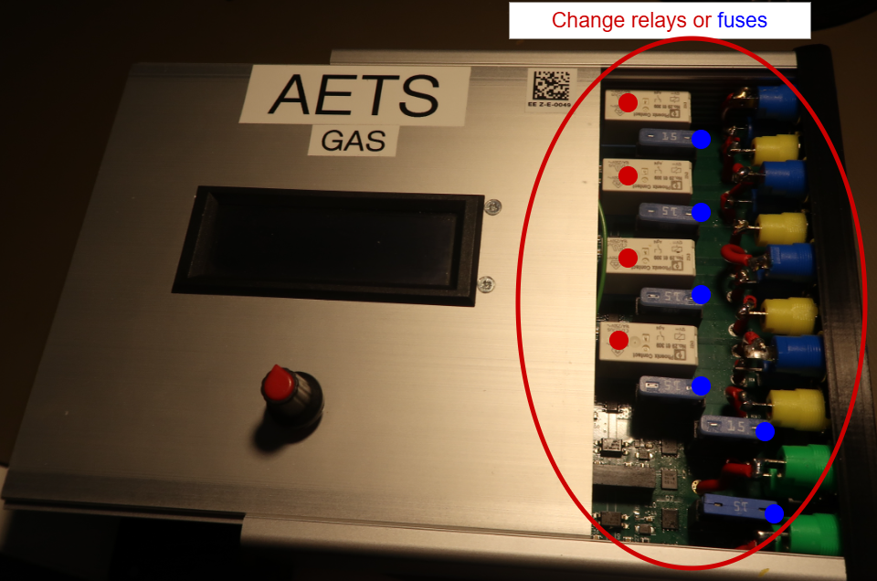
diagramy diplomka svg flashka/photos/disasembly/disasembly3.png
