MrMicek/AETS/diagramy diplomka svg flashka/photos/disasembly/IMG_1864.JPG

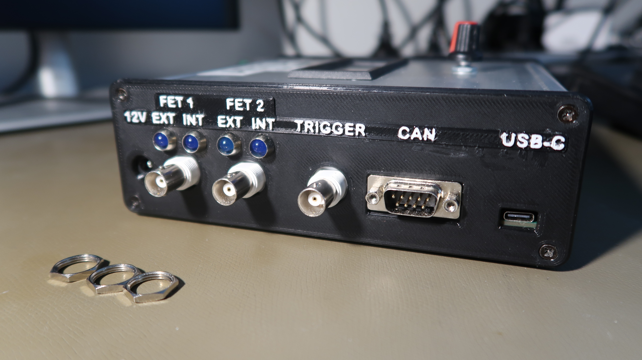
diagramy diplomka svg flashka/photos/disasembly/IMG_1864.JPG
