MrMicek/AETS/diagramy diplomka svg flashka/photos/disasembly/IMG_1865.JPG

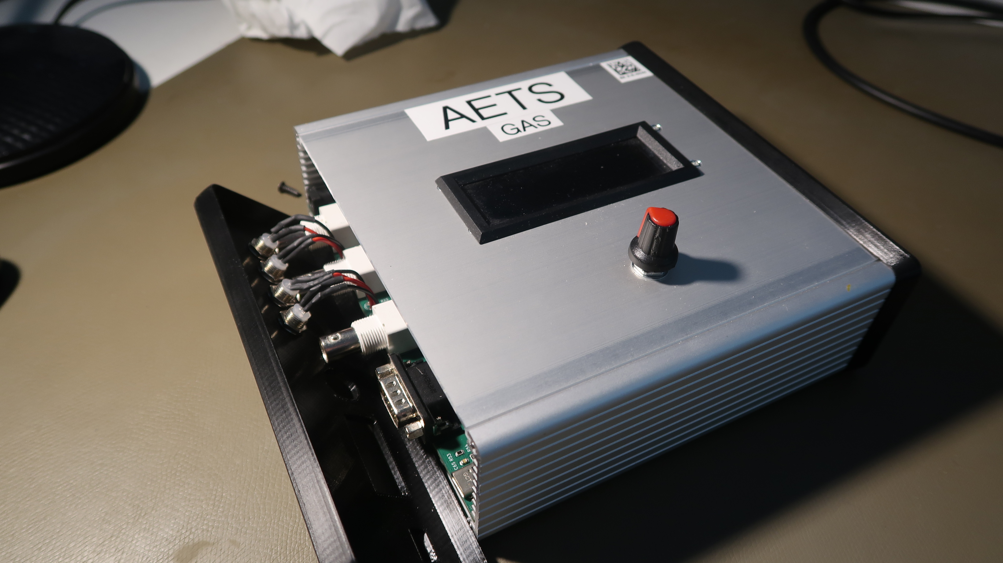
diagramy diplomka svg flashka/photos/disasembly/IMG_1865.JPG
