MrMicek/AETS/diagramy diplomka svg flashka/photos/disasembly/IMG_1867.JPG

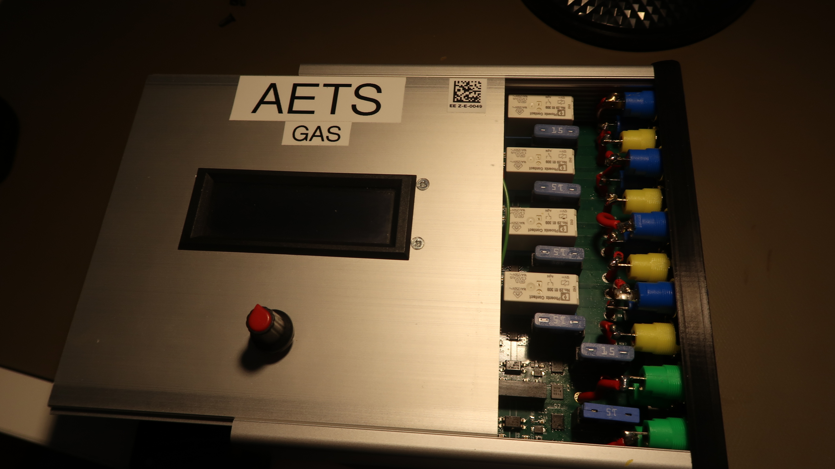
diagramy diplomka svg flashka/photos/disasembly/IMG_1867.JPG
