MrMicek/AETS/diagramy diplomka svg flashka/photos/final box kryt.JPG

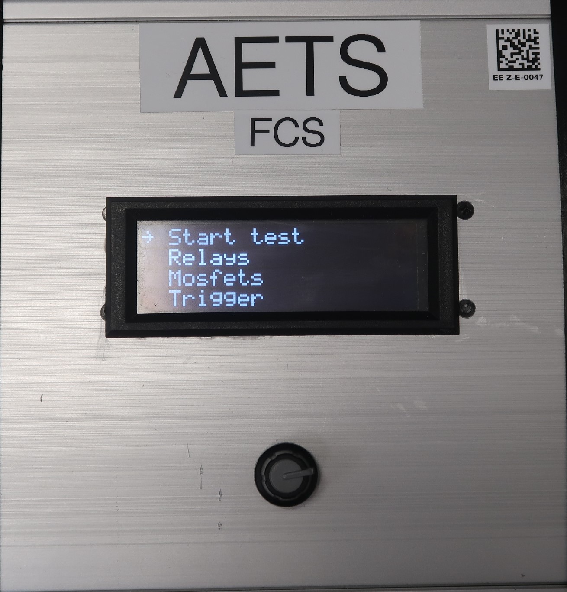
diagramy diplomka svg flashka/photos/final box kryt.JPG
