MrMicek/AETS/diagramy diplomka svg flashka/photos/IMG_1760.JPG

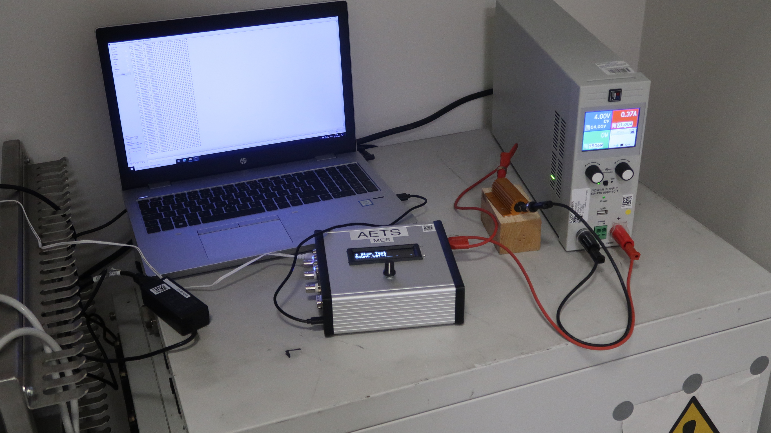
diagramy diplomka svg flashka/photos/IMG_1760.JPG
