MrMicek/AETS/diagramy diplomka svg flashka/photos/IMG_1762.JPG

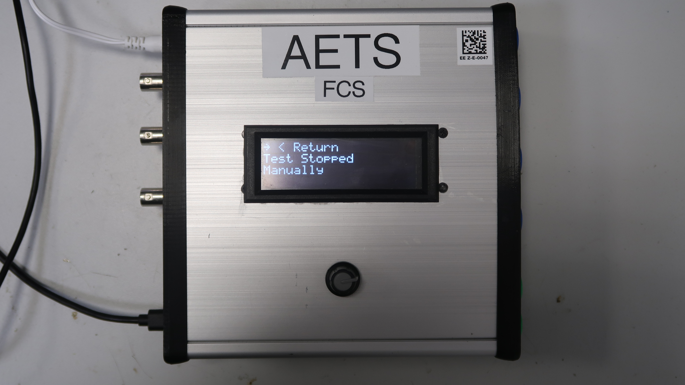
diagramy diplomka svg flashka/photos/IMG_1762.JPG
