MrMicek/AETS/diagramy diplomka svg flashka/photos/IMG_1763.JPG

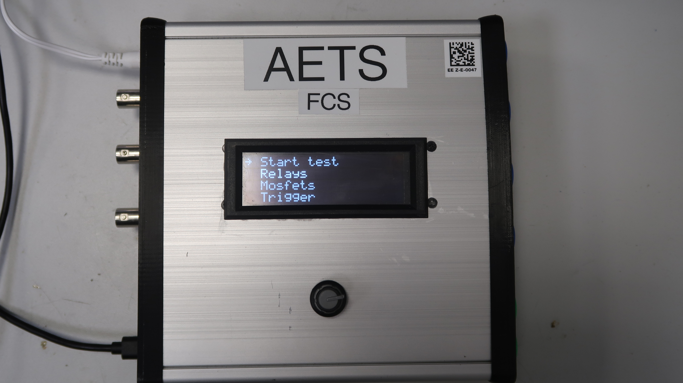
diagramy diplomka svg flashka/photos/IMG_1763.JPG
