MrMicek/AETS/diagramy diplomka svg flashka/photos/IMG_1764.JPG

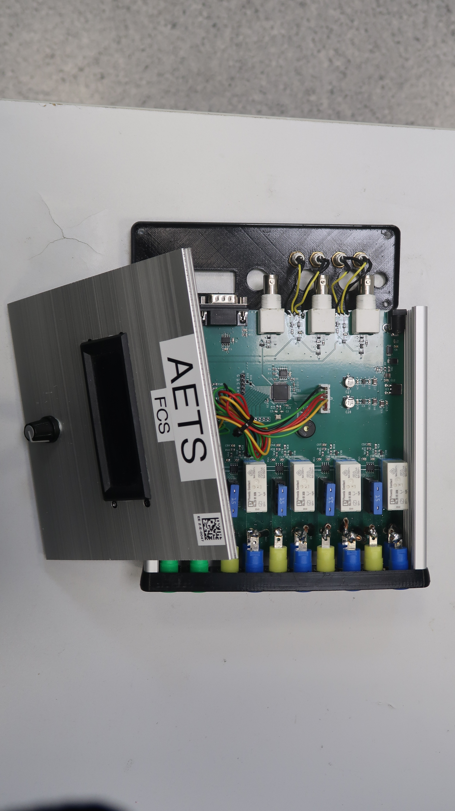
diagramy diplomka svg flashka/photos/IMG_1764.JPG
