MrMicek/AETS/diagramy diplomka svg flashka/photos/IMG_1815.JPG

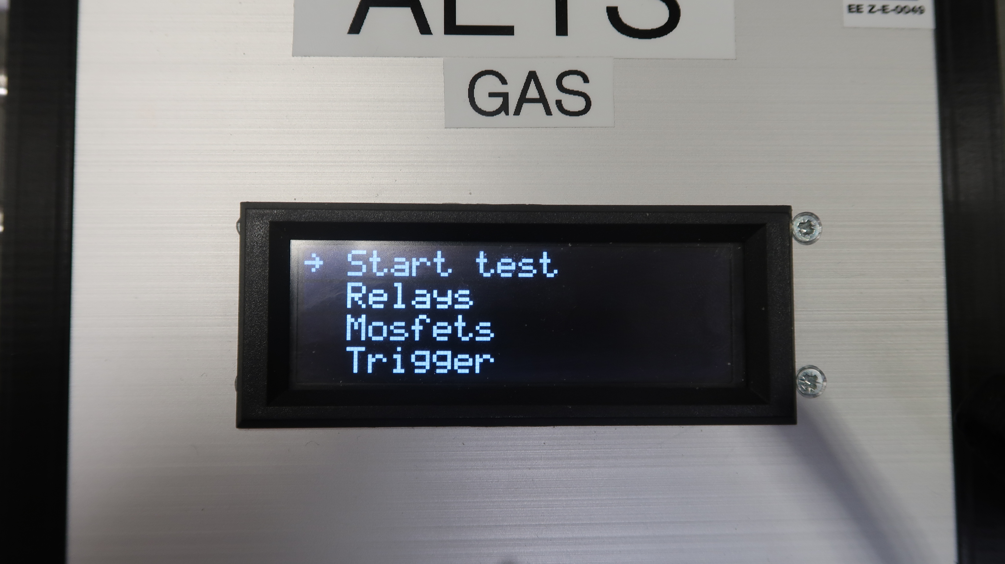
diagramy diplomka svg flashka/photos/IMG_1815.JPG
