MrMicek/AETS/diagramy diplomka svg flashka/photos/IMG_1817.JPG

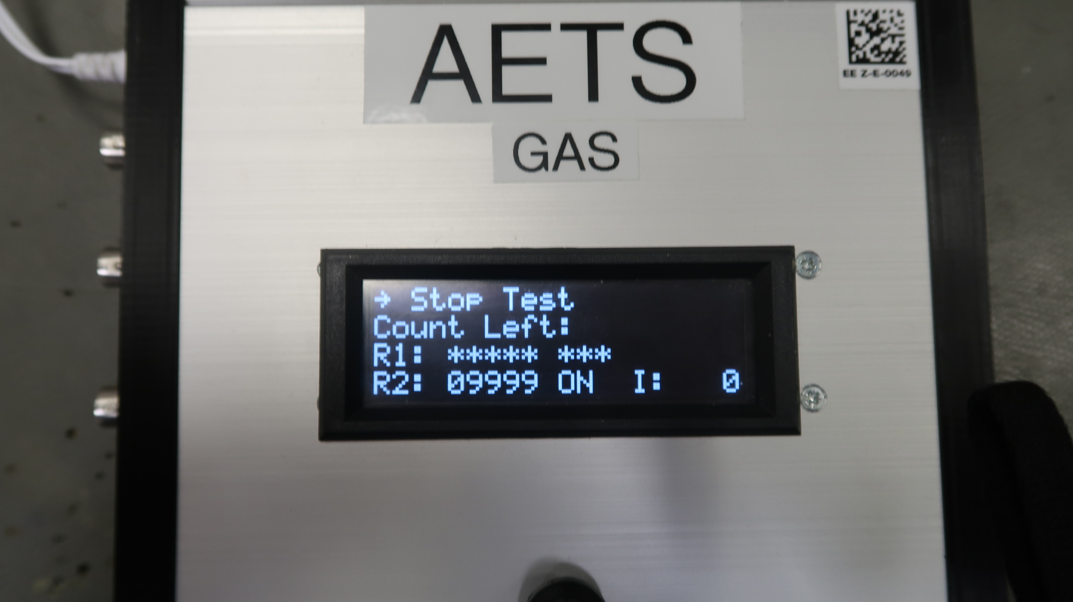
diagramy diplomka svg flashka/photos/IMG_1817.JPG
