MrMicek/AETS/diagramy diplomka svg flashka/photos/IMG_1818.JPG

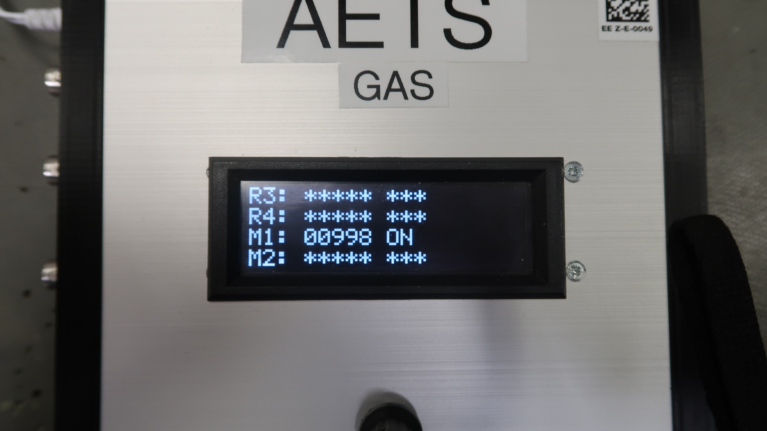
diagramy diplomka svg flashka/photos/IMG_1818.JPG
