MrMicek/AETS/HW/KiCad/AETS/AETS_front.png

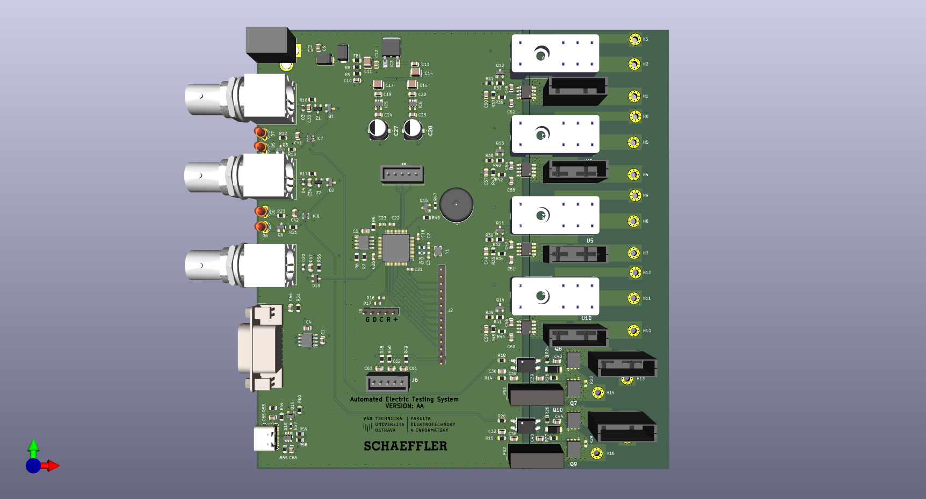
HW/KiCad/AETS/AETS_front.png
