MrMicek/AETS/HW/KiCad/AETS/PLOTS/PCB/krabickka_na_tisk_2026-Feb-23_04-26-16PM-000_CustomizedView14149093594_png_alpha.png

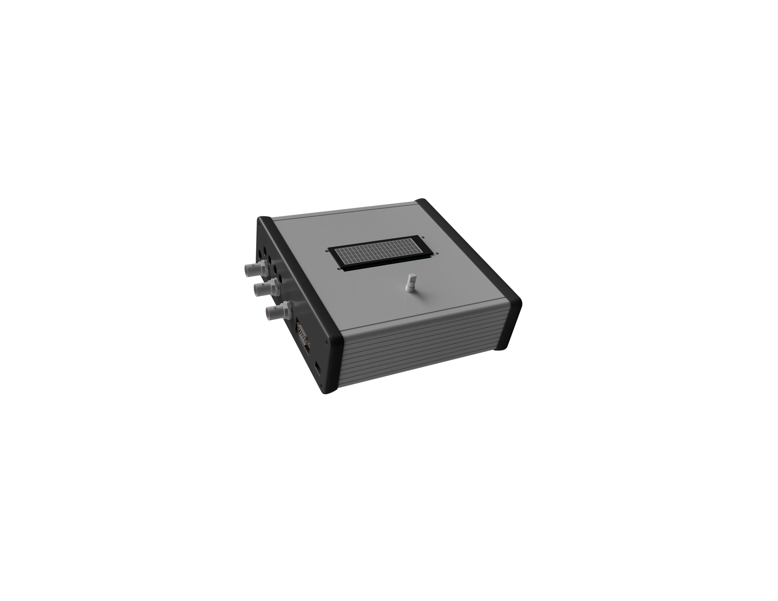
HW/KiCad/AETS/PLOTS/PCB/krabickka_na_tisk_2026-Feb-23_04-26-16PM-000_CustomizedView14149093594_png_alpha.png
