MrMicek/AETS/HW/simulations/falstad/PChannelDriver.png

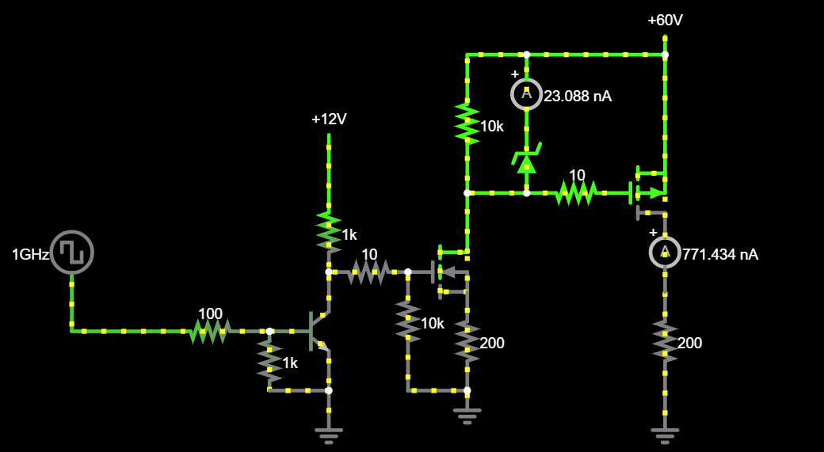
HW/simulations/falstad/PChannelDriver.png
