MrMicek/AETS/resources/calculating capacitance for data saving.xlsx

U(0) | 3.3 |  | capacitance |  | droptime 3.3->1.7V | U(t) | time to store | bits_sent | number of messages
 |  |  | uF |  | ms | V | ms | bits | msg
voltage eeprom min | 1.7 |  | 47 |  | 8 | 1.7 | 7 | 2800 | 44.44444444
voltage min | 0 |  | 11 |  | 7.84 | 1.7 | 6.84 | 2736 | 43.42857143
Rc | 56800 | R | 0 |  | 1.6 | 1.7 | 0.6 | 240 | 3.80952381
bits written with int32 data | 63
i2c speed | 400000 | bits/s
 | 2.5e-06 | s
 | 2.5 | us | needed capacitance | 4.326463633e-08 | F
 |  |  |  | 0.04326463633 | uF
 |  |  |  | 43.26463633 | nF
aprox time for MCU | 1 | ms
number of messages needed | 4
number of bits needed | 252
time to store | 0.00163 | s
