MrMicek/AETS/HW/KiCad/AETS/AETS-CZ-NB-3L0Y7S3_vyplnena.xlsx

Id | Designator | Footprint | Quantity | Quantity for 4 PCBs | Designation | price per pcs | total price | links
29 | C14,C16,C17,C11 | C_1210_3225Metric | 4 | 12 | 4,7uF | 5.13 | 61.56 | https://cz.mouser.com/ProductDetail/KYOCERA-AVX/08055C472JAT2A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
19 | C2,C3 | C_0603_1608Metric | 2 | 6 | 10pF | 5.13 | 30.78 | https://cz.mouser.com/ProductDetail/KEMET/C0603C100J5RACTU?qs=y%252BHbsf6ovcfaLkEt1SR70Q%3D%3D
10 | C23,C18,C21,C22,C26,C15 | C_0603_1608Metric | 6 | 18 | 100nF | 2.23 | 40.14 | https://cz.mouser.com/ProductDetail/KYOCERA-AVX/KGM15BR71H104JT
8 | C27,C28 | EEEHP1H4R7P | 2 | 6 | 68uF | 13.17 | 79.02 | https://cz.mouser.com/ProductDetail/Panasonic/EEE-FP1C680AL?qs=vmHwEFxEFR%252B62ky9jeZXug%3D%3D
5 | C30,C36,C35,C32 | C_0805_2012Metric | 4 | 12 | 470nF | 5.36 | 64.32 | https://cz.mouser.com/ProductDetail/KYOCERA-AVX/08055C474KAZ4A
56 | C38,C37 | C_1210_3225Metric | 2 | 6 | 470pF/2kV | 22.77 | 136.62 | https://cz.mouser.com/ProductDetail/KYOCERA-AVX/KGM32HR73D471KU
25 | C44,C43,C7 | C_0805_2012Metric | 3 | 9 | 4,7nF | 5.13 | 46.17 | https://cz.mouser.com/ProductDetail/KYOCERA-AVX/08055C472JAT2A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
1 | C49,C47,C33,C61,C59,C34,C57,C48,C10,C56,C50,C55,C67,C62 | C_0805_2012Metric | 14 | 42 | 10nF | 3.57 | 149.94 | https://cz.mouser.com/ProductDetail/KYOCERA-AVX/08055C103JAT4A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
3 | C63,C39,C64,C25,C20,C60,C13,C19,C58,C41,C52,C6,C5,C65,C51,C40,C42,C24,C12,C1,C4,C66,C29,C53,C68,C45,C31,C46,C54 | C_0805_2012Metric | 29 | 87 | 100nF | 3.12 | 271.44 | https://cz.mouser.com/ProductDetail/KYOCERA-AVX/KAF21BR71H104JM
59 | C9,C8 | C_0805_2012Metric | 2 | 6 | 47p | 5.36 | 32.16 | https://cz.mouser.com/ProductDetail/KEMET/C0805C470J5RACTU?qs=gt1LBUVyoHlbpLRjfP%252BJ1A%3D%3D
27 | D1 | DIOM5436X244N | 1 | 3 | VS-10BQ015HM3_5BT | 8.93 | 26.79 | https://cz.mouser.com/ProductDetail/Vishay-Semiconductors/VS-10BQ015HM3-5BT?qs=p1ya7m3AA0AlGZ3N6%2FCsfw%3D%3D
55 | D11,D12,D14,D13 | SODFL3616X98N | 4 | 12 | D_Schottky | 8.26 | 99.12 | https://cz.mouser.com/ProductDetail/onsemi/MBR230LSFT1G?qs=Jh7l0IbPjid1ZBeNXVj%2FnA%3D%3D
49 | D18 | SOT95P280X145-6N | 1 | 3 | TPD2S017DBVR | 12.5 | 37.5 | https://cz.mouser.com/ProductDetail/Texas-Instruments/TPD2S017DBVR?qs=OaSNdy%2FNfznGQ7ML7Wt%252BOg%3D%3D
51 | D19 | SOT-23 | 1 | 3 | BAT54S | 2.9 | 8.7 | https://cz.mouser.com/ProductDetail/Diotec-Semiconductor/BAT54S?qs=OlC7AqGiEDl5%2FwzZD7rGmQ%3D%3D
21 | D2 | DIOM5436X244N | 1 | 3 | 1.5B18CA-M3/H | 25.79 | 77.37 | https://cz.mouser.com/ProductDetail/Vishay/1.5B18CA-M3-H?qs=7%2F6SraaimPSHmMmVYKcERQ%3D%3D
14 | D4,D20,D3,D17,D16,D15 | DIONC1608X70N | 6 | 18 | TESDU5V0 RGG | 7.14 | 128.52 | https://cz.mouser.com/ProductDetail/Taiwan-Semiconductor/TESDU5V0-RGG?qs=QEzMiVqgwc1ZDipmgySSHQ%3D%3D
50 | D6,D5 | LED_D3.0mm | 2 | 6 | LED_MCU | 0 | 0 | -
36 | D8,D7 | LED_D3.0mm | 2 | 6 | LED_BNC | 0 | 0 | -
48 | D9,D10 | SODFL5026X125N | 2 | 6 | 10V | 10.27 | 61.62 | https://cz.mouser.com/ProductDetail/Micro-Commercial-Components-MCC/SMAF4740A-TP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
42 | F1 | R_0402_1005Metric | 1 | 3 | MFU0805FF00630P100 | 11.51 | 34.53 | https://cz.mouser.com/ProductDetail/Vishay-Beyschlag/MFU0805FF00630P100?qs=oI046glRurs5iQZrYsClog%3D%3D
37 | FB1 | Fuse_0805_2012Metric | 1 | 3 | BLM21SP601SH1D | 7.14 | 21.42 | https://cz.mouser.com/ProductDetail/Murata-Electronics/BLM21SP601SH1D?qs=17u8i%2FzlE89O6NnGGVLYAA%3D%3D
53 | IC1 | SOIC127P600X175-8N | 1 | 3 | MCP2542WFD-E_SN | 22.99 | 68.97 | https://cz.mouser.com/ProductDetail/Microchip-Technology/MCP2542WFD-E-SN?qs=qdgZG5p0FZ7OaaJ5dRIIPw%3D%3D
40 | IC2 | SOIC127P600X175-8N | 1 | 3 | M24512-DRMN8TP_K | 17.63 | 52.89 | https://cz.mouser.com/ProductDetail/STMicroelectronics/M24512-DRMN8TP-K?qs=bzW4KIwE9U2JH6dTS5bAyA%3D%3D
45 | IC3 | L4931CDT50TR | 1 | 3 | LD29080DT50R | 47.12 | 141.36 | https://cz.mouser.com/ProductDetail/STMicroelectronics/LD29080DT50R?qs=22WmWNTp1rrXQIBxhkME0A%3D%3D
52 | IC4 | QFP50P1200X1200X160-64N | 1 | 3 | STM32G474RET6 | 188.23 | 564.69 | https://cz.mouser.com/ProductDetail/STMicroelectronics/STM32G474RET6?qs=PzGy0jfpSMvUBs7PMTDqlg%3D%3D
9 | IC6,IC5 | SOT95P280X145-5N | 2 | 6 | TPS7B6933DBVR | 17.86 | 107.16 | https://cz.mouser.com/ProductDetail/Texas-Instruments/TPS7B6933DBVR?qs=zEmsApcVOkXMdnHMfXdU7Q%3D%3D
31 | IC8,IC7 | 74LVC1G3157GW125 | 2 | 6 | 74LVC1G3157GW,125 | 2.68 | 16.08 | https://cz.mouser.com/ProductDetail/Nexperia/74LVC1G3157GW125?qs=me8TqzrmIYXTNjH5%2FiBeXQ%3D%3D
15 | J1 | DC10AFC68148 | 1 | 3 | DC-10A FC68148 | 35.13 | 105.39 | https://www.tme.eu/cz/details/fc68148/konektory-dc/cliff/dc-10a-fc68148/?brutto=1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
41 | J2 | PinHeader_1x14_P2.54mm_Vertical | 1 | 3 | Conn_01x14_Pin | 0 | 0 | -
16 | J4,J10,J3 | VBI211 | 3 | 9 | Conn_Coaxial | 225.68 | 2031.12 | https://cz.mouser.com/ProductDetail/Vitelec-Cinch-Connectivity-Solutions/VBI211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
26 | J5 | B6B-XH-AJST | 1 | 3 | B6B-XH-AJST | 4.474 | 13.422 | https://www.tme.eu/cz/details/b6b-xh-a/signalove-konektory-raster-2-50mm/jst/
 | J6 | SHDR5W64P0X250_1X5_1490X575X700P | 1 | 3 | B5B-XH-A__LF__SN_ | 3.426 | 10.278 | https://www.tme.eu/cz/details/b5b-xh-a/signalove-konektory-raster-2-50mm/jst/b5b-xh-a-lf-sn/
35 | J7 | G17C0910132EU | 1 | 3 | DE9_Plug_MountingHoles | 36.21 | 108.63 | https://cz.mouser.com/ProductDetail/Amphenol-Commercial-Products/G17C0910132EU?qs=1VVaZAL47g1wqtt9KNnEiQ%3D%3D
20 | J8 | PinHeader_1x05_P2.54mm_Vertical | 1 | 3 | Conn_01x05_Pin | 0 | 0 | -
43 | J9 | USB_C_Receptacle_GCT_USB4105-xx-A_16P_TopMnt_Horizontal | 1 | 3 | USB_C_Receptacle_USB2.0 | 17.41 | 52.23 | https://cz.mouser.com/ProductDetail/GCT/USB4105-GF-A?qs=KUoIvG%2F9IlY%2FMLlBMpStpA%3D%3D
34 | K2,K4,K3,K1 | 95152SMA | 4 | 12 | 95.15.2SMA | 40.4 | 484.8 | https://www.tme.eu/cz/details/95.15.2sma/elektromagneticka-rele-prislusenstvi/finder/
39 | LS1 | PS1240P02BT | 1 | 3 | PS1240P02BT | 12.05 | 36.15 | https://cz.mouser.com/ProductDetail/TDK/PS1240P02BT?qs=d7g9p1yFhWaZXSY9MjKMkw%3D%3D
23 | PS2,PS1 | Converter_DCDC_XP_POWER-IAxxxxS_THT | 2 | 6 | IA1205S | 144.09 | 864.54 | https://cz.mouser.com/ProductDetail/XP-Power/IA1205S?qs=w%2Fv1CP2dgqo47WPNN%2FUazA%3D%3D
17 | Q1,Q2,Q15,Q5,Q6 | SOT95P240X120-3N | 5 | 15 | MMBT3904 | 2.23 | 33.45 | https://cz.mouser.com/ProductDetail/Diotec-Semiconductor/MMBT3904?qs=OlC7AqGiEDkK1MwiyUU6mg%3D%3D
12 | Q12,Q14,Q11,Q13 | SOT96P240X110-3N | 4 | 12 | DMN61D8LQ-7 | 8.04 | 96.48 | https://cz.mouser.com/ProductDetail/Diodes-Incorporated/DMN61D8LQ-7?qs=DBvH5xl4Uyka0o7WXOAQ%2FA%3D%3D
32 | Q16 | SOT96P240X110-3N | 1 | 3 | DMP3098LQ-7 | 11.38 | 34.14 | https://cz.mouser.com/ProductDetail/Diodes-Incorporated/DMP3098LQ-7?qs=HXFqYaX1Q2ynasjBVyITSA%3D%3D
13 | Q4,Q3 | APC817A1SL | 2 | 6 | APC-817A1-SL | 8.26 | 49.56 | https://cz.mouser.com/ProductDetail/American-Bright-LED/APC-817A1-SL?qs=Y0Uzf4wQF3mmDsgauL3zUw%3D%3D
46 | Q8,Q10,Q9,Q7 | SI7141DPT1GE3 | 4 | 12 | SI7489DP-T1-GE3 | 67.46 | 809.52 | https://cz.mouser.com/ProductDetail/Vishay-Semiconductors/SI7489DP-T1-GE3?qs=IRuQNBqMOclOgVkisGeeHg%3D%3D
57 | R10,R11 | R_0603_1608Metric | 2 | 6 | 10k | 2.23 | 13.38 | https://cz.mouser.com/ProductDetail/SEI-Stackpole/RNCP0603FTD10K0
22 | R19,R56,R23,R22,R21,R18,R20 | R_0805_2012Metric | 7 | 21 | 100R | 2.23 | 46.83 | https://cz.mouser.com/ProductDetail/YAGEO/RT0805FRE13100RL?qs=sGAEpiMZZMtlubZbdhIBIMaxnMKvEBNdDiJqTcimWwo%3D
11 | R2 | R_0603_1608Metric | 1 | 3 | 1M | 2.23 | 6.69 | https://cz.mouser.com/ProductDetail/Vishay-Dale/RCC06031M00FKEA?qs=GedFDFLaBXHlMNeJInwoZg%3D%3D
2 | R24,R39,R14,R38,R5,R59,R58,R25,R30,R31,R15 | R_0805_2012Metric | 11 | 33 | 10R | 2.23 | 73.59 | https://cz.mouser.com/ProductDetail/YAGEO/AC0805FR-1310RL
4 | R26,R16,R27,R17,R46 | R_0805_2012Metric | 5 | 15 | 500R | 2.23 | 33.45 | https://cz.mouser.com/ProductDetail/Vishay/CRCW0805499RFKEA
24 | R29,R1,R28,R52 | R_0603_1608Metric | 4 | 12 | 0R | 2.13 | 25.56 | https://cz.mouser.com/ProductDetail/YAGEO/AC0603FR-070RL?qs=UoPT7wUmgYIHE8YhvUntLg%3D%3D
58 | R3,R4 | R_0805_2012Metric | 2 | 6 | 60,4R | 2.23 | 13.38 | https://cz.mouser.com/ProductDetail/Bourns/CR0805-FX-60R4ELF
7 | R40,R35,R42,R49,R41,R32,R45,R48,R37,R60,R34,R44,R36,R33,R9,R50,R43 | R_0805_2012Metric | 17 | 51 | 10k | 1.54 | 78.54 | https://www.tme.eu/cz/details/rt0805brd0710k/rezistory-smd/yageo/rt0805brd0710kl/
6 | R47,R57 | R_0603_1608Metric | 2 | 6 | 1k5 | 2.23 | 13.38 | https://cz.mouser.com/ProductDetail/SEI-Stackpole/RNCP0603FTD1K50
30 | R51,R8,R53,R12,R61,R13 | R_0805_2012Metric | 6 | 18 | 100k | 2.23 | 40.14 | https://cz.mouser.com/ProductDetail/Vishay/CRCW0805100KFKEA?qs=sGAEpiMZZMtlubZbdhIBIKpw3Cj3Rl3MgRjH3xt31Ys%3D
44 | R54,R55 | R_0805_2012Metric | 2 | 6 | 5k1 | 2.23 | 13.38 | https://cz.mouser.com/ProductDetail/Vishay/CRCW08055K10FKEAC?qs=sGAEpiMZZMtlubZbdhIBIIZe04wfiaJW8ZW3sZJ2u8w%3D
33 | R6,R7 | R_0805_2012Metric | 2 | 6 | 2k2 | 2.233 | 13.398 | https://cz.mouser.com/ProductDetail/TE-Connectivity-Holsworthy/CRG0805F2K2?qs=DfH2yQaBz6tTfarX6CbcPg%3D%3D
54 | RV1,RV2 | VARC1608X90N | 2 | 6 | AVR-M1608C270KTACB | 9.15 | 54.9 | https://cz.mouser.com/ProductDetail/TDK/AVR-M1608C270KTACB?qs=f0gCvUGw%252BIz%252B9wxpKEKvbg%3D%3D
38 | U1,U5,U6,U10,U2,U9 | 17861650002 | 6 | 18 | 178.6165.0002 | 104.9 | 1888.2 | https://cz.mouser.com/ProductDetail/Littelfuse/178.6165.0002?qs=gu7KAQ731UT%2FkKyRBF134A%3D%3D
18 | U4,U3,U8,U7 | SOIC-8_3.9x4.9mm_P1.27mm | 4 | 12 | ACS724xLCTR-2P5AB | 73.66 | 883.92 | https://cz.mouser.com/ProductDetail/Allegro-MicroSystems/ACS724LLCTR-2P5AB-T?qs=11PymoJGorKO3bW4uIzV2A%3D%3D
28 | Y1 | ECS4001833JGNTR3 | 1 | 3 | Crystal_GND24 | 8.93 | 26.79 | https://cz.mouser.com/ProductDetail/ECS/ECS-400-18-33-JGN-TR3?qs=e8oIoAS2J1SLxEG9aPzeug%3D%3D
47 | Z2,Z1 | SOT95P230X110-3N | 2 | 6 | AZ23C5V1-7-F | 8.11 | 48.66 | https://cz.mouser.com/ProductDetail/Diodes-Incorporated/AZ23C5V1-7-F?qs=sNt1cpZzkrpr1%2FMQUM16xA%3D%3D
 |  | 12V DC zdroj | 1 | 3 | CLW-1812-W2E-ER-WH | 203.41 | 610.23 | https://www.tme.eu/cz/details/clw-1812-w2e-er-wh/zasuvkove-napajeci-zdroje/cellevia-power/
 |  | konektor displaye | 1 | 3 | XHP-6 | 1.42 | 4.26 | https://www.tme.eu/cz/details/xhp-6/signalove-konektory-raster-2-50mm/jst/
 |  | konektor enkoderu | 1 | 3 | XHP-5 | 1.49 | 4.47 | https://www.tme.eu/cz/details/xhp-5/signalove-konektory-raster-2-50mm/jst/
 |  | krimpúovaci kontakty pro XHP konektory | 20 | 60 | SXH-001T-P0.6JST | 1.01 | 60.6 | https://www.tme.eu/cz/details/sxh-001t-p0.6/signalove-konektory-raster-2-50mm/jst/
 |  | rele | 4 | 12 | 2961309 | 166.16 | 1993.92 | https://cz.mouser.com/ProductDetail/Phoenix-Contact/2961309?qs=xrHRiZ6CCZBt32l4wiEMxw%3D%3D
 |  | spona pro rele matici | 4 | 12 | 95.51 | 7.28 | 87.36 | https://www.tme.eu/cz/details/095.51/elektromagneticka-rele-prislusenstvi/finder/
 |  | display | 1 | 3 | NHD-0420CW-AW3 | 839.12 | 2517.36 | https://www.tme.eu/cz/details/nhd-0420cw-aw3/alfanumericke-oled-displeje/newhaven-display-international/
 |  | enkóder | 1 | 3 | PEC11H-4215F-S0024 | 58.78 | 176.34 | https://cz.mouser.com/ProductDetail/Bourns/PEC11H-4215F-S0024?qs=7MVldsJ5UazXQyTbCLch8g%3D%3D
 |  | pojistky | 6 | 18 | APR58-UL-15A | 46.17 | 831.06 | https://www.digikey.com/en/products/detail/optifuse/APR58-UL-15A/11576552
 |  | krabicka | 1 | 2 | 1455T1602 | 680.81 | 1361.62 | https://www.tme.eu/cz/details/hm-1455t1602/krabicky-z-panelem/hammond/1455t1602/
 |  | banana socket blue | 8 | 24 | MP770569 | 22.64 | 543.36 | https://cz.farnell.com/multicomp-pro/mp770569/conn-banana-jack-32a-blu/dp/3581091
 |  | banana socket yellow | 4 | 12 | MP770567 | 21.61 | 259.32 | https://cz.farnell.com/multicomp-pro/mp770567/conn-banana-jack-32a-yel/dp/3581089
 |  | banana socket green | 4 | 12 | MP770568 | 22.64 | 271.68 | https://cz.farnell.com/multicomp-pro/mp770568/conn-banana-jack-32a-grn/dp/3581090
 |  |  |  |  |  | celkova cena za 4 desky | 19084.348
 | 68 |  |  |  |  | celkova cena za 1 desku | 6361.449333
