MrMicek/AETS/HW/KiCad/AETS/AETS-CZ-NB-3L0Y7S3.step

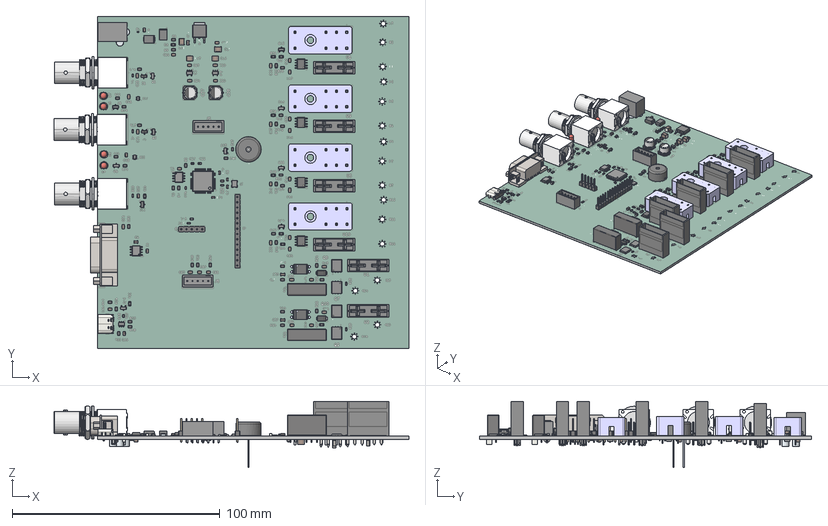
[picture p105: CAD file, 2025-12-02]
HW/KiCad/AETS/AETS-CZ-NB-3L0Y7S3.step
171.0 x 160.0 x 32.0 mm
C_0805_2012Metric x 52
R_0805_2012Metric x 53
R_0603_1608Metric x 9
WSIZE CODE D-001 x 2
WSIZE CODE D-002 x 2
WSIZE CODE D-003 x 4
BODY-SOT x 3
LEAD-SOT x 16
LEAD-DUMMY x 2
C_0603_1608Metric x 8
PinsArrayL x 10
FilletPinR x 10
DIP4 Gullwing x 2
term1 x 5
term2 x 5
Leads
VBI211 x 3
SOIC-8_3.9x4.9mm_P1.27mm x 4
PinHeader_1x05_P2.54mm_Vertical
FilletPin1 x 2
FilletPin2 x 2
Converter_DCDC_XP_POWER-IAxxxxS_THT x 2
LeadsArray x 2
Pins
C_1210_3225Metric x 6
74LVC1G3157GW,125 x 2
95.15.2SMA x 4
G17C0910132EU
LED_D3.0mm x 4
PS1240P02BT
PinsArrayLR x 3
PinHeader_1x14_P2.54mm_Vertical
R_0402_1005Metric
USB_C_Receptacle_GCT_USB4105-xx-A_16P_TopMnt_Horizontal
CPD
EP
LEAD
SI7489DP-T1-GE3 x 4
SOT23 lower body x 2
SOT23 Lead x 6
SOT23 Upper body x 2
Pin1 x 2
Pin2 x 2
SOT-23
PinsArrayTB
PinKIdent x 4
PinK x 4
PinA x 4
AETS-CZ-NB-3L0Y7S3_silkscreen
AETS-CZ-NB-3L0Y7S3_soldermask
AETS-CZ-NB-3L0Y7S3_PCB
