MrMicek/AETS/manuals/Menu hiearchy.xlsx

Sheet: Templates
INIT | A | u | t | o | m | a | t | e | d
 | E | l | e | c | t | r | i | c | a | l
 | T | e | s | t | i | n | g
 | S | y | s | t | e | m |  |  |  |  |  |  |  |  |  | v | 0 | . | 1
MENU TOP | > |  | S | t | a | r | t |  | T | e | s | t
 |  |  | R | e | l | a | y | s
 |  |  | M | o | s | f | e | t | s
 |  |  | T | r | i | g | g | e | r
MENU BOT | > |  | C | o | n | n | e | c | t | i | v | i | t | y
 |  |  | P | r | o | f | i | l | e | s
 |  |  | S | e | t | t | i | n | g | s
 |  |  | I | n | f | o
START TEST TOP | > |  | < |  | R | E | T | U | R | N |  |  |  |  |  |  |  |  |  | MOSFET | > | < |  | R | E | T | U | R | N
 |  |  | C | u | r | r | e | n | t |  | S | e | t | t | i | n | g | s |  |  |  | M | o | s | f | e | t |  | 1
 |  |  | P | r | o | f | i | l | e |  | 1 |  |  |  |  |  |  |  |  |  |  | M | o | s | f | e | t |  | 2
 |  |  | P | r | o | f | i | l | e |  | 2
START TEST BOT | > |  | P | r | o | f | i | l | e |  | 3 |  |  |  |  |  |  |  |  | MOSFET 1…. TOP | > | < |  | R | E | T | U | R | N
 |  |  | P | r | o | f | i | l | e |  | 4 |  |  |  |  |  |  |  |  |  |  | E | n | a | b | l | e |  |  |  |  |  |  |  | O | F | F
 |  |  | P | r | o | f | i | l | e |  | 5 |  |  |  |  |  |  |  |  |  |  | E | x | t | . | C | o | n | t | r | o | l |  |  | O | F | F
 |  |  | P | r | o | f | i | l | e |  | 6 |  |  |  |  |  |  |  |  |  |  | T | o | n |  | ( | m | s | ) |  |  |  |  |  | 5 | 0
 |  |  |  |  |  |  |  |  |  |  |  |  |  |  |  |  |  |  |  | MOSFET 1…. BOT | > | T | o | f | f | ( | m | s | ) |  |  |  |  |  | 4 | 0
 |  |  |  |  |  |  |  |  |  |  |  |  |  |  |  |  |  |  |  |  |  | S | W | . | C | n | t |  |  |  |  |  |  | 1 | 0 | 0 | 0
RELAYS | > |  | < |  | R | E | T | U | R | N
 |  |  | S | e | t |  | R | e | l | a | y |  |  |  |  |  |  |  |  | TRIGGER | > | < |  | R | E | T | U | R | N
 |  |  | R | e | m | a | i | n |  | C | o | u | n | t |  |  |  |  |  |  |  | E | n | a | b | l | e |  |  |  |  |  |  |  | O | F | F
 |  |  |  |  |  |  |  |  |  |  |  |  |  |  |  |  |  |  |  |  |  | R | e | l | a | y |  | C | h | . |  |  |  |  |  |  | 2
Set Relay TOP | > |  | < |  | R | E | T | U | R | N
 |  |  | R | e | l | a | y |  | 1
 |  |  | R | e | l | a | y |  | 2 |  |  |  |  |  |  |  |  |  |  | CONNECTIVITY | > | < |  | R | E | T | U | R | N
 |  |  | R | e | l | a | y |  | 3 |  |  |  |  |  |  |  |  |  |  |  |  | R | e | m | o | t | e |  | M | o | d | e |  |  | O | F | F
 |  |  |  |  |  |  |  |  |  |  |  |  |  |  |  |  |  |  |  |  |  | C | A | N |  | O | u | t | p | u | t |  |  |  | O | F | F
Set Relay BOT | > |  | R | e | l | a | y |  | 4 |  |  |  |  |  |  |  |  |  |  |  |  | U | S | B |  | O | u | t | p | u | t |  |  |  | O | F | F
Relay 1 …etc. TOP | > |  | < |  | R | E | T | U | R | N |  |  |  |  |  |  |  |  |  | PROFILE TOP | > | < |  | R | E | T | U | R | N
 |  |  | E | n | a | b | l | e |  |  |  |  |  |  |  | O | F | F |  |  |  | P | r | o | f | i | l | e |  | 1
 |  |  | T | o | n |  | ( | m | s | ) |  |  |  |  |  | 5 | 0 |  |  |  |  | P | r | o | f | i | l | e |  | 2
 |  |  | T | o | f | f | ( | m | s | ) |  |  |  |  |  | 4 | 0 |  |  |  |  | P | r | o | f | i | l | e |  | 3
Relay 1 …etc. BOT | > |  | < |  | R | E | T | U | R | N |  |  |  |  |  |  |  |  |  | PROFILE BOT | > | P | r | o | f | i | l | e |  | 4
 |  |  | I | _ | M | a | x |  | ( | m | A | ) |  |  | 4 | 0 | 0 | 0 |  |  |  | P | r | o | f | i | l | e |  | 5
 |  |  | S | W | . | C | n | t |  | ( | k | ) |  |  |  | 1 | 0 | 0 |  |  |  | P | r | o | f | i | l | e |  | 6
Remain Count TOP | > |  | < |  | R | E | T | U | R | N
 |  |  | R | e | l | a | y | 1 |  | ( | k | ) |  | 1 | 0 | 0 | 0 | 0 |  | PROFILE 1…. | > | < |  | R | E | T | U | R | N
 |  |  | R | e | l | a | y | 2 |  | ( | k | ) |  | 2 | 5 | 4 | 4 | 3 |  |  |  | S | a | v | e |  | T | o |  | P | r | o | f | i | l | e
 |  |  | R | e | l | a | y | 3 |  | ( | k | ) |  | 5 | 0 | 0 | 0 | 0 |  |  |  | L | o | a | d |  | f | r | o | m |  | P | r | o | f | i | l | e
Remain Count BOT | > |  | R | e | l | a | y | 4 |  | ( | k | ) |  | 1 | 0 | 0 | 0 | 0
 |  |  |  |  |  |  |  |  |  |  |  |  |  |  |  |  |  |  |  | SETTINGS | > | < |  | R | E | T | U | R | N
 |  |  |  |  |  |  |  |  |  |  |  |  |  |  |  |  |  |  |  |  |  | B | u | z | z | e | r |  |  |  |  |  |  |  | O | F | F
 |  |  |  |  |  |  |  |  |  |  |  |  |  |  |  |  |  |  |  | INFO TOP | > | < |  | R | E | T | U | R | N
TEST TOP | > |  | S | t | o | p |  | T | e | s | t |  |  |  |  |  |  |  |  |  |  | A | u | t | o | m | a | t | e | d |  | E | l | e | c | t | r | i | c
 |  |  | C | o | u | n | t |  | L | e | f | t | : |  |  |  |  |  |  |  |  | T | e | s | t | i | n | g |  |  |  | S | y | s | t | e | m
 |  |  | R | 1 | : |  | 1 | 0 | 0 | 0 | 0 |  |  |  |  | O | N |  |  |  |  | V | e | r | s | i | o | n | : |  |  | 0 | . | 1
 |  |  | R | 2 | : |  |  | 5 | 0 | 0 | 0 |  |  |  |  | O | F | F
TEST BOT | > |  | R | 3 | : |  | * | * | * | * | * |  |  |  |  | * | * | * |  | INFO BOT | > | A | u | t | h | o | r | : | V | . | M | i | c | e | k
 |  |  | R | 4 | : |  | 7 | 0 | 0 | 0 | 0 |  |  |  |  | O | N |  |  |  |  | S | C | H | A | E | F | F | L | E | R |  | C | Z |  | s | r | o
 |  |  | M | 1 | : |  | * | * | * | * | * |  |  |  |  | * | * | *
 |  |  | M | 2 | : |  |  | 6 | 0 | 0 | 0 |  |  |  |  | O | F | F
STOP TEST | > |  | < |  | R | E | T | U | R | N |  | T | O |  | M | E | N | U
 |  |  | T | E | S | T |  | S | T | O | P | P | E | D
TEST OK | > |  | < |  | R | E | T | U | R | N |  | T | O |  | M | E | N | U
 |  |  | T | E | S | T |  | F | I | N | N | I | S | H | E | D
 |  |  | S | U | C | C | E | S | S | F | U | L | Y
ERROR MAX CURRENT TEST | > |  | < |  | R | E | T | U | R | N |  | T | O |  | M | E | N | U
 |  |  | T | E | S | T |  | E | N | D | E | D
 |  |  | E | R | R | O | R | :
 |  |  | C | U | R | R | E | N | T |  | E | X | C | E | D | E | D
ERROR 0 CURRENT TEST | > |  | < |  | R | E | T | U | R | N |  | T | O |  | M | E | N | U
 |  |  | T | E | S | T |  | E | N | D | E | D
 |  |  | E | R | R | O | R | :
 |  |  | N | O |  | C | U | R | R | E | N | T |  | F | L | O | W
RELAY COUNT LOW | > |  | < |  | R | E | T | U | R | N
 | C | A | N | T |  | S | T | A | R | T |  | T | E | S | T
 | R | E | L | A | Y |  | x | :
 | N | O | T |  | E | N | O | U | G | H |  | S | W | I | T | C | H | E | S

Sheet: Hiearchy
 |  |  |  |  |  |  |  |  |  |  |  |  |  |  |  |  |  |  |  |  |  |  |  |  |  |  |  |  |  |  |  |  |  |  | START TEST TOP | > | <
 |  |  |  |  |  |  |  |  |  |  |  |  |  |  |  |  |  |  |  |  |  |  |  |  |  |  |  |  |  |  |  |  |  |  |  |  | C
 |  |  |  |  |  |  |  |  |  |  |  |  |  |  |  |  |  |  |  |  |  |  |  |  |  |  |  |  |  |  |  |  |  |  |  |  | P
 |  |  |  |  |  |  |  |  |  |  |  |  |  |  |  |  |  |  |  |  |  |  |  |  |  |  |  |  |  |  |  |  |  |  |  |  | P
 |  |  |  |  |  |  |  |  |  |  |  |  |  |  |  |  |  |  |  |  |  |  |  |  |  |  |  |  |  |  |  |  |  |  | START TEST BOT | > | P
 |  |  |  |  |  |  |  |  |  |  |  |  |  |  |  |  |  |  |  |  |  |  |  |  |  |  |  |  |  |  |  |  |  |  |  |  | P
 |  |  |  |  |  |  |  |  |  |  |  |  |  |  |  |  |  |  |  |  |  |  |  |  |  |  |  |  |  |  |  |  |  |  |  |  | P
 |  |  |  |  |  |  |  |  |  |  |  |  |  |  |  |  |  |  |  |  |  |  |  |  |  |  |  |  |  |  |  |  |  |  |  |  | P
 |  |  |  |  |  |  |  |  |  |  |  |  |  |  |  |  |  |  |  |  |  |  |  |  |  |  |  |  |  |  |  |  |  |  | RELAYS | > | <
INIT | A | u | t | o | m | a | t | e | d |  |  |  |  |  |  |  |  |  |  |  |  |  |  |  |  |  |  |  |  |  |  |  |  |  |  |  | S
 | E | l | e | c | t | r | i | c | a | l |  |  |  |  |  |  |  |  |  |  |  |  |  |  |  |  |  |  |  |  |  |  |  |  |  |  | R
 | T | e | s | t | i | n | g |  |  |  |  |  |  |  |  |  |  |  |  |  |  |  |  |  |  |  |  |  |  |  |  |  |  |  |  |  | S
 | S | y | s | t | e | m |  |  |  |  |  |  |  |  |  | v | 1 | . | 0
Calibration 1 |  |  | Z | E | R | O |  | C | U | R | R | E | N | T |  | C | A | L | . |  | MENU TOP | > | S | t | a | r | t |  | T | e | s | t
 |  |  | P | L | E | A | S | E |  | D | I | S | C | O | N | N | E | C | T |  |  |  | R | e | l | a | y | s
 | A | L | L |  | C | A | B | L | E | S |  | A | N | D |  | L | O | A | D | S |  |  | M | o | s | f | e | t | s
 |  | P | R | E | S | S |  | T | O |  | C | A | L | I | B | R | A | T | E |  |  |  | T | r | i | g | g | e | r
 |  |  |  |  |  |  |  |  |  |  |  |  |  |  |  |  |  |  |  |  |  |  |  |  |  |  |  |  |  |  |  |  |  |  | MOSFET | > | <
Calibration 2 |  |  |  |  |  |  |  |  |  |  |  |  |  |  |  |  |  |  |  |  | MENU BOT | > | C | o | n | n | e | c | t | i | v | i | t | y |  |  | M
 |  |  |  | C | A | L | I | B | R | A | T | I | N | G | . | . | . |  |  |  |  |  | P | r | o | f | i | l | e | s |  |  |  |  |  |  | M
 |  |  |  |  |  |  |  |  |  |  |  |  |  |  |  |  |  |  |  |  |  |  | S | e | t | t | i | n | g | s
 |  |  |  |  |  |  |  |  |  |  |  |  |  |  |  |  |  |  |  |  |  |  | I | n | f | o
 |  |  |  |  |  |  |  |  |  |  |  |  |  |  |  |  |  |  |  |  |  |  |  |  |  |  |  |  |  |  |  |  |  |  | TRIGGER | > | <
 |  |  |  |  |  |  |  |  |  |  |  |  |  |  |  |  |  |  |  |  |  |  |  |  |  |  |  |  |  |  |  |  |  |  |  |  | E
 |  |  |  |  |  |  |  |  |  |  |  |  |  |  |  |  |  |  |  |  |  |  |  |  |  |  |  |  |  |  |  |  |  |  |  |  | R
 |  |  |  |  |  |  |  |  |  |  |  |  |  |  |  |  |  |  |  |  |  |  |  |  |  |  |  |  |  |  |  |  |  |  | CONNECTIVITY TOP | > | <
 |  |  |  |  |  |  |  |  |  |  |  |  |  |  |  |  |  |  |  |  |  |  |  |  |  |  |  |  |  |  |  |  |  |  |  |  | R
 |  |  |  |  |  |  |  |  |  |  |  |  |  |  |  |  |  |  |  |  |  |  |  |  |  |  |  |  |  |  |  |  |  |  |  |  | C
 |  |  |  |  |  |  |  |  |  |  |  |  |  |  |  |  |  |  |  |  |  |  |  |  |  |  |  |  |  |  |  |  |  |  |  |  | U
 |  |  |  |  |  |  |  |  |  |  |  |  |  |  |  |  |  |  |  |  |  |  |  |  |  |  |  |  |  |  |  |  |  |  | CONNECTIVITY BOT | > | R
 |  |  |  |  |  |  |  |  |  |  |  |  |  |  |  |  |  |  |  |  |  |  |  |  |  |  |  |  |  |  |  |  |  |  |  |  | C
 |  |  |  |  |  |  |  |  |  |  |  |  |  |  |  |  |  |  |  |  |  |  |  |  |  |  |  |  |  |  |  |  |  |  |  |  | U
 |  |  |  |  |  |  |  |  |  |  |  |  |  |  |  |  |  |  |  |  |  |  |  |  |  |  |  |  |  |  |  |  |  |  |  |  | P
 |  |  |  |  |  |  |  |  |  |  |  |  |  |  |  |  |  |  |  |  |  |  |  |  |  |  |  |  |  |  |  |  |  |  | PROFILE TOP | > | <
 |  |  |  |  |  |  |  |  |  |  |  |  |  |  |  |  |  |  |  |  |  |  |  |  |  |  |  |  |  |  |  |  |  |  |  |  | P
 |  |  |  |  |  |  |  |  |  |  |  |  |  |  |  |  |  |  |  |  |  |  |  |  |  |  |  |  |  |  |  |  |  |  |  |  | P
 |  |  |  |  |  |  |  |  |  |  |  |  |  |  |  |  |  |  |  |  |  |  |  |  |  |  |  |  |  |  |  |  |  |  |  |  | P
 |  |  |  |  |  |  |  |  |  |  |  |  |  |  |  |  |  |  |  |  |  |  |  |  |  |  |  |  |  |  |  |  |  |  | PROFILE BOT | > | P
 |  |  |  |  |  |  |  |  |  |  |  |  |  |  |  |  |  |  |  |  |  |  |  |  |  |  |  |  |  |  |  |  |  |  |  |  | P
 |  |  |  |  |  |  |  |  |  |  |  |  |  |  |  |  |  |  |  |  |  |  |  |  |  |  |  |  |  |  |  |  |  |  |  |  | P
 |  |  |  |  |  |  |  |  |  |  |  |  |  |  |  |  |  |  |  |  |  |  |  |  |  |  |  |  |  |  |  |  |  |  | SETTINGS | > | <
 |  |  |  |  |  |  |  |  |  |  |  |  |  |  |  |  |  |  |  |  |  |  |  |  |  |  |  |  |  |  |  |  |  |  |  |  | B
 |  |  |  |  |  |  |  |  |  |  |  |  |  |  |  |  |  |  |  |  |  |  |  |  |  |  |  |  |  |  |  |  |  |  |  |  | C
 |  |  |  |  |  |  |  |  |  |  |  |  |  |  |  |  |  |  |  |  |  |  |  |  |  |  |  |  |  |  |  |  |  |  |  |  | R
 |  |  |  |  |  |  |  |  |  |  |  |  |  |  |  |  |  |  |  |  |  |  |  |  |  |  |  |  |  |  |  |  |  |  | INFO TOP | > | <
 |  |  |  |  |  |  |  |  |  |  |  |  |  |  |  |  |  |  |  |  |  |  |  |  |  |  |  |  |  |  |  |  |  |  |  |  | A
 |  |  |  |  |  |  |  |  |  |  |  |  |  |  |  |  |  |  |  |  |  |  |  |  |  |  |  |  |  |  |  |  |  |  |  |  | T
 |  |  |  |  |  |  |  |  |  |  |  |  |  |  |  |  |  |  |  |  |  |  |  |  |  |  |  |  |  |  |  |  |  |  |  |  | V
 |  |  |  |  |  |  |  |  |  |  |  |  |  |  |  |  |  |  |  |  |  |  |  |  |  |  |  |  |  |  |  |  |  |  | INFO BOT | > | A
 |  |  |  |  |  |  |  |  |  |  |  |  |  |  |  |  |  |  |  |  |  |  |  |  |  |  |  |  |  |  |  |  |  |  |  |  | S
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
