MrMicek/AETS/diagramy diplomka svg flashka/TESTS/mosfet 8A.pdf

PicoLog | mosfet 8A | Mar 5, 2026 2:08 PM

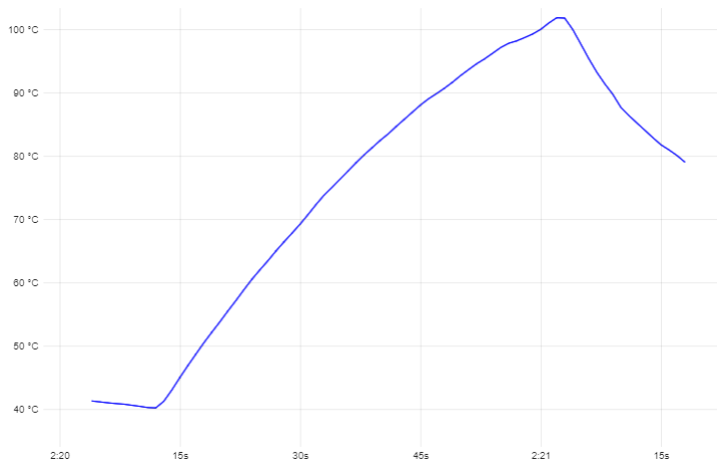
[picture p113: figure]
