MrMicek/AETS/diagramy diplomka svg flashka/TESTS/MOSFET+DIODE (64V8A).pdf

PicoLog | MOSFET+DIODE (64V8A) | Mar 5, 2026 3:34 PM

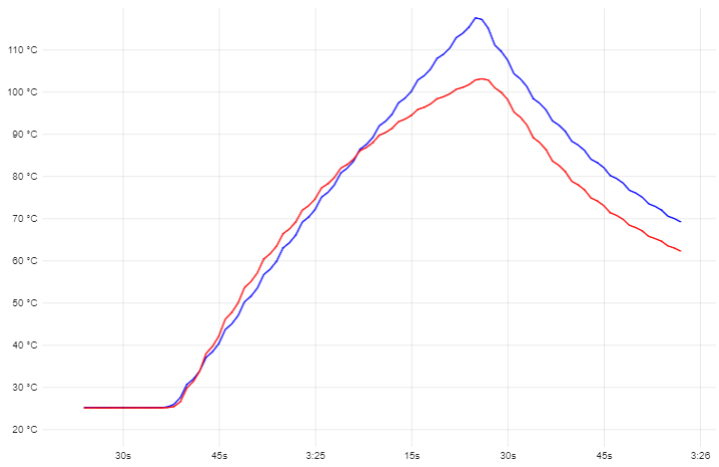
[picture p114: figure]

Channel configuration
- | DIODE | AO135/512 | 1 | Type K | 1s - Average
- | MOSFET | AO135/512 | 2 | Type K | 1s - Average
