MrMicek/AETS/resources/In_rush_current_test_report.xlsx

Sheet: TITTLE
Name of the project
EWP3-PCO
Name of the test
In_rush_current_test_report
Number/name of tested sample
v1 270uf, v2 330uF, v3 330uf 64kB
Test engineer/engineers
Tomáš Glomb
Test start date
2023-06-23
Test end date
2023-06-23
Success Test conditions(limits, …)
I_inrush_max shall be < 150 A
Status of test PASS/FAIL
FAIL
I_inrush_max is out of limit when Ubat = U_op_max and U_nom whit switching device

Sheet: Measured data
 | I_Inrush_max (A)
 | v1_270 uF |  | v2_330 uF |  | v3_330 uF_64kB
Vbat | wihtout switcher | with switcher | wihtout switcher | with switcher | wihtout switcher | with switcher
U_op_min | 89 | 88 | 79 | 84 | 76 | 88
U_nom | 148 | 163 | 148 | 156 | 147 | 160
U_op_max | 141 | 205 | 136 | 209 | 131 | 202

Sheet: Osciloscope_screen
V1_270uF
without switch | with switch
U_nom | U_nom
U_op_min | U_op_min
O_op_max | O_op_max
V2_330uF
U_nom | U_nom
U_op_min | U_op_min
U_op_max | U_op_max
V3_330uF_64kB
U_nom | U_nom
U_op_min | U_op_min
U_op_max | U_op_max

Sheet: USED MEASURING EQUIPMENT
 |  | PN
EA-PSI9080-60 T | Power supply | EE-Z-D0443
Keysight DSOX3024 | Osciloscope | EE-Z-D-0372
Keysight N2781B | 150A Current probe | EE-Z-D0307
NI-XNET USB-8506 | LIN interface | EE-Z-H-0089
TTI QL355TP | Power supply (for LIN interface) | Z-D-0110
WKS ufi75 | Signal Switch
Test setup (with switcher) |  |  | Block diagram
Test setup (without switcher)
