MrMicek/AETS/diagramy diplomka svg flashka/TESTS/commands + AI test.txt

https://gemini.google.com/share/d0dcac625b83
