MrMicek/AETS/diagramy diplomka svg flashka/TESTS/TEST RELAY.txt

12V, 5A, Ton:4s
----------------
out 247325 r1 1000 0 0 r2 0 0 0 r3 0 0 0 r4 0 0 0 m1 0 m2 0
out 248325 r1 1000 0 0 r2 0 0 0 r3 0 0 0 r4 0 0 0 m1 0 m2 0
out 249325 r1 999 1 0 r2 0 0 0 r3 0 0 0 r4 0 0 0 m1 0 m2 0
out 250325 r1 999 1 3083 r2 0 0 0 r3 0 0 0 r4 0 0 0 m1 0 m2 0
out 251325 r1 999 1 3083 r2 0 0 0 r3 0 0 0 r4 0 0 0 m1 0 m2 0
out 252325 r1 999 1 3083 r2 0 0 0 r3 0 0 0 r4 0 0 0 m1 0 m2 0
out 253325 r1 999 0 3083 r2 0 0 0 r3 0 0 0 r4 0 0 0 m1 0 m2 0
out 254325 r1 999 0 0 r2 0 0 0 r3 0 0 0 r4 0 0 0 m1 0 m2 0
out 255325 r1 998 1 0 r2 0 0 0 r3 0 0 0 r4 0 0 0 m1 0 m2 0
out 256325 r1 998 1 3083 r2 0 0 0 r3 0 0 0 r4 0 0 0 m1 0 m2 0
out 257325 r1 998 1 3083 r2 0 0 0 r3 0 0 0 r4 0 0 0 m1 0 m2 0
out 258325 r1 998 1 3083 r2 0 0 0 r3 0 0 0 r4 0 0 0 m1 0 m2 0
out 259325 r1 998 0 3083 r2 0 0 0 r3 0 0 0 r4 0 0 0 m1 0 m2 0
out 260325 r1 998 0 0 r2 0 0 0 r3 0 0 0 r4 0 0 0 m1 0 m2 0
out 261325 r1 997 1 0 r2 0 0 0 r3 0 0 0 r4 0 0 0 m1 0 m2 0
out 262325 r1 997 1 3083 r2 0 0 0 r3 0 0 0 r4 0 0 0 m1 0 m2 0
out 263325 r1 997 1 3083 r2 0 0 0 r3 0 0 0 r4 0 0 0 m1 0 m2 0
out 264325 r1 997 1 3083 r2 0 0 0 r3 0 0 0 r4 0 0 0 m1 0 m2 0
out 265325 r1 997 0 3083 r2 0 0 0 r3 0 0 0 r4 0 0 0 m1 0 m2 0
out 266325 r1 997 0 0 r2 0 0 0 r3 0 0 0 r4 0 0 0 m1 0 m2 0
out 267325 r1 996 1 0 r2 0 0 0 r3 0 0 0 r4 0 0 0 m1 0 m2 0
out 268325 r1 996 1 3083 r2 0 0 0 r3 0 0 0 r4 0 0 0 m1 0 m2 0
out 269325 r1 996 1 3083 r2 0 0 0 r3 0 0 0 r4 0 0 0 m1 0 m2 0
out 270325 r1 996 1 3083 r2 0 0 0 r3 0 0 0 r4 0 0 0 m1 0 m2 0
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
out 1248030 r1 994 1 602 r2 0 0 0 r3 0 0 0 r4 0 0 0 m1 0 m2 0
out 1249030 r1 994 1 602 r2 0 0 0 r3 0 0 0 r4 0 0 0 m1 0 m2 0
out 1250030 r1 994 0 602 r2 0 0 0 r3 0 0 0 r4 0 0 0 m1 0 m2 0
out 1251030 r1 994 0 0 r2 0 0 0 r3 0 0 0 r4 0 0 0 m1 0 m2 0
