MrMicek/AETS/diagramy diplomka svg flashka/TESTS/FallTimeSwitchDelayMosfet.png

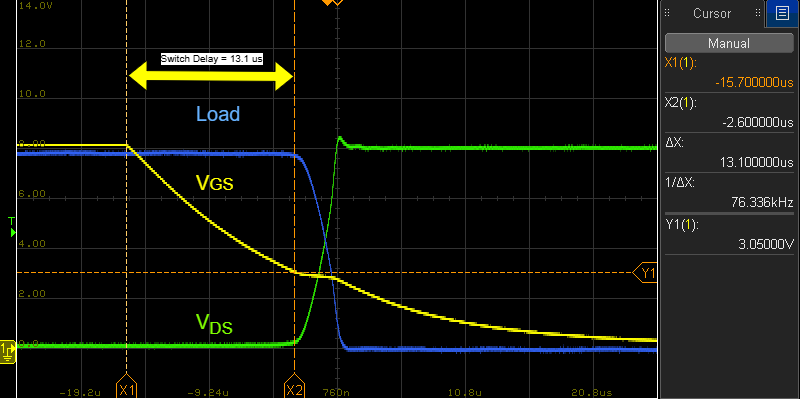
diagramy diplomka svg flashka/TESTS/FallTimeSwitchDelayMosfet.png
