MrMicek/AETS/diagramy diplomka svg flashka/TESTS/Inrush mosfet dut2.bmp

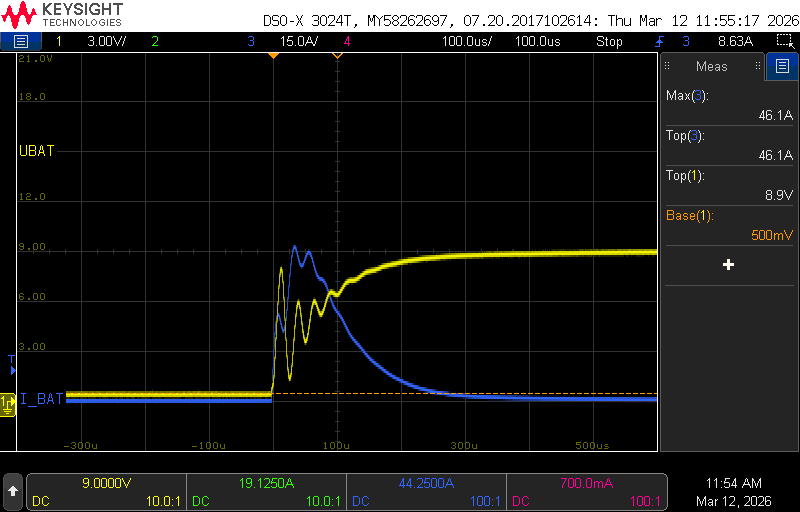
diagramy diplomka svg flashka/TESTS/Inrush mosfet dut2.bmp
