MrMicek/AETS/diagramy diplomka svg flashka/TESTS/relay response time after trigger.png

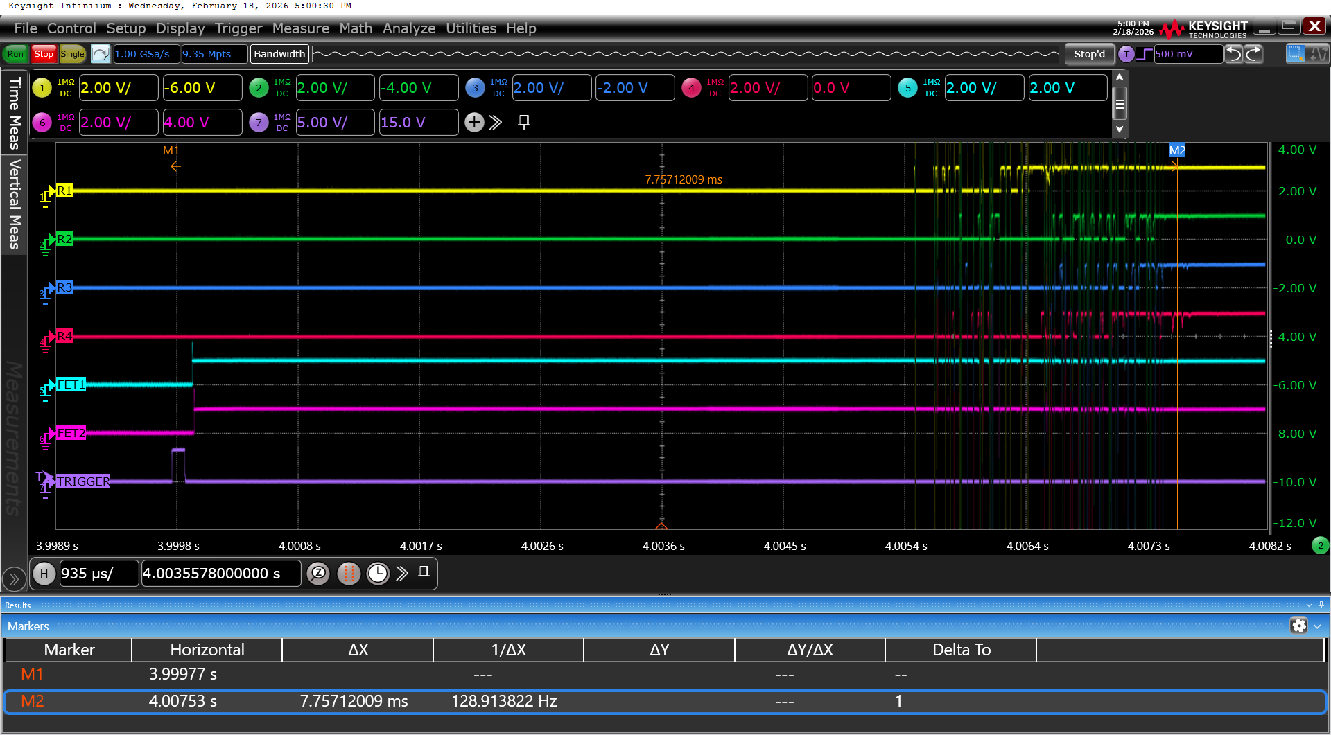
diagramy diplomka svg flashka/TESTS/relay response time after trigger.png
