MrMicek/AETS/diagramy diplomka svg flashka/TESTS/relay response time captioned.png

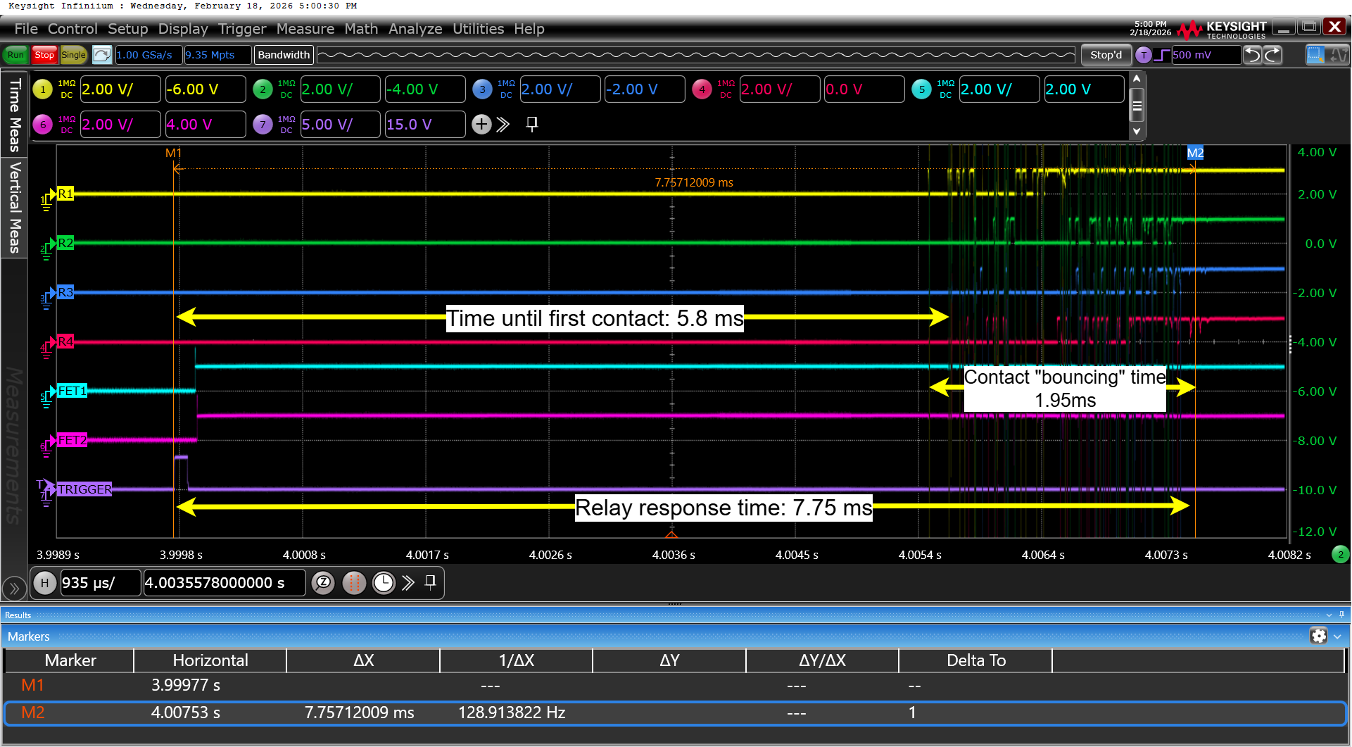
diagramy diplomka svg flashka/TESTS/relay response time captioned.png
