MrMicek/AETS/diagramy diplomka svg flashka/TESTS/Relay Test Vojta.png

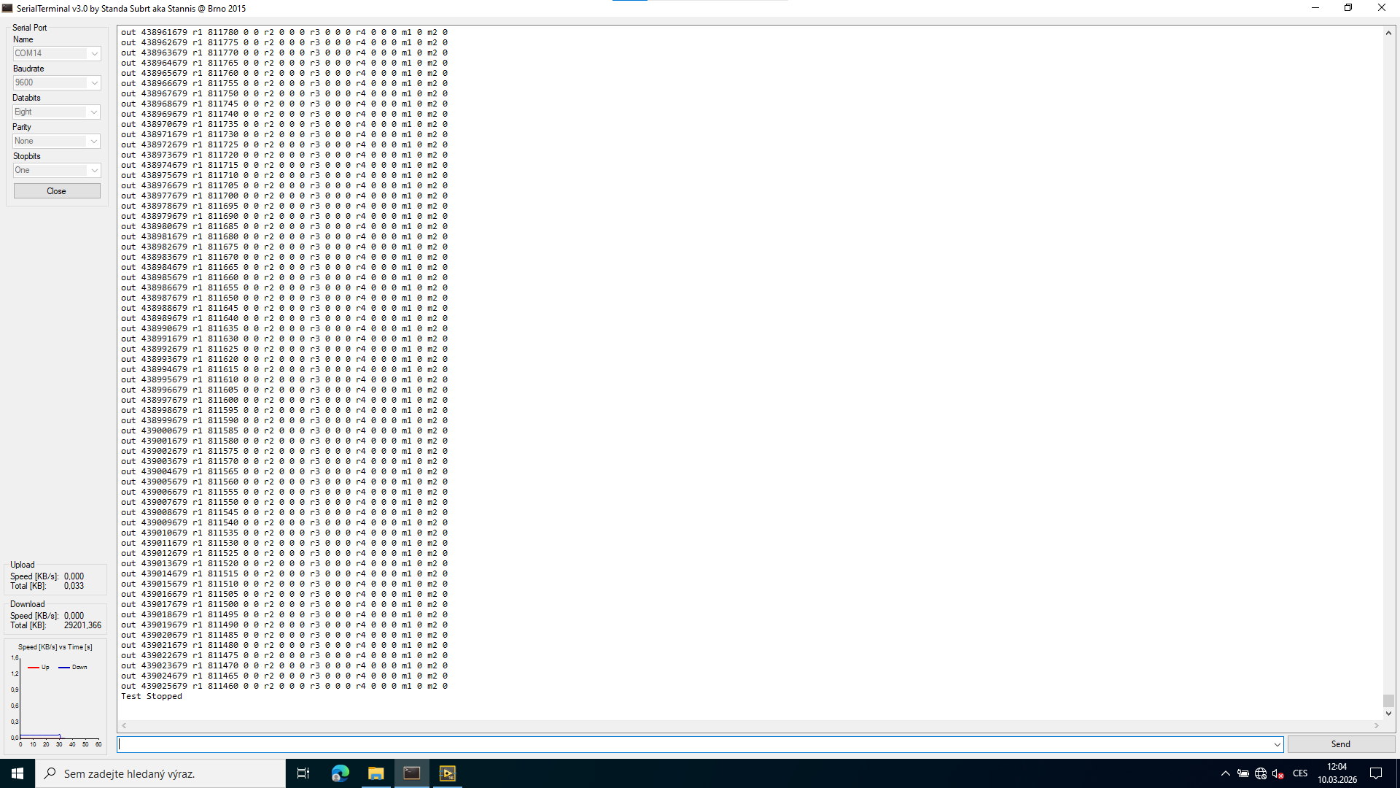
diagramy diplomka svg flashka/TESTS/Relay Test Vojta.png
