MrMicek/AETS/diagramy diplomka svg flashka/TESTS/rise,fall time more count.png

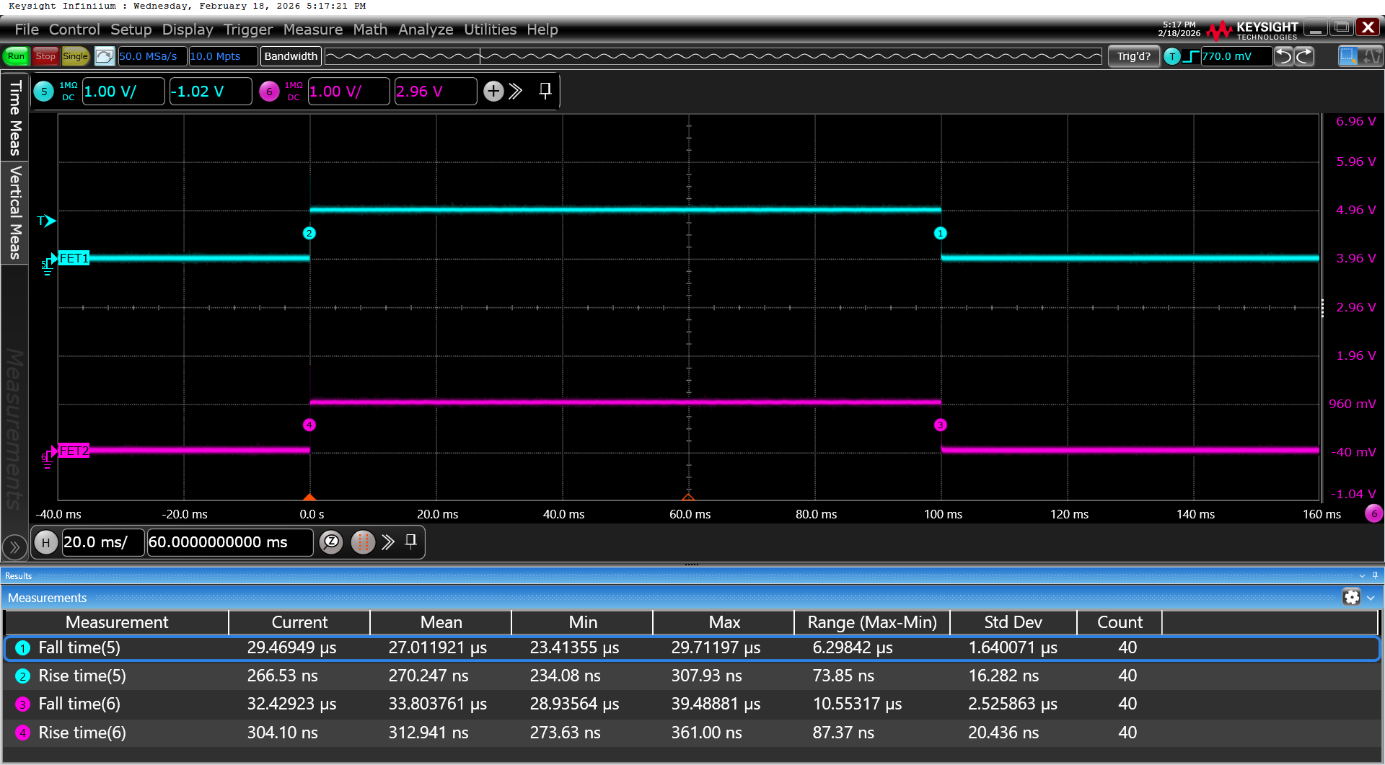
diagramy diplomka svg flashka/TESTS/rise,fall time more count.png
