MrMicek/AETS/diagramy diplomka svg flashka/TESTS/rise,fall time.png

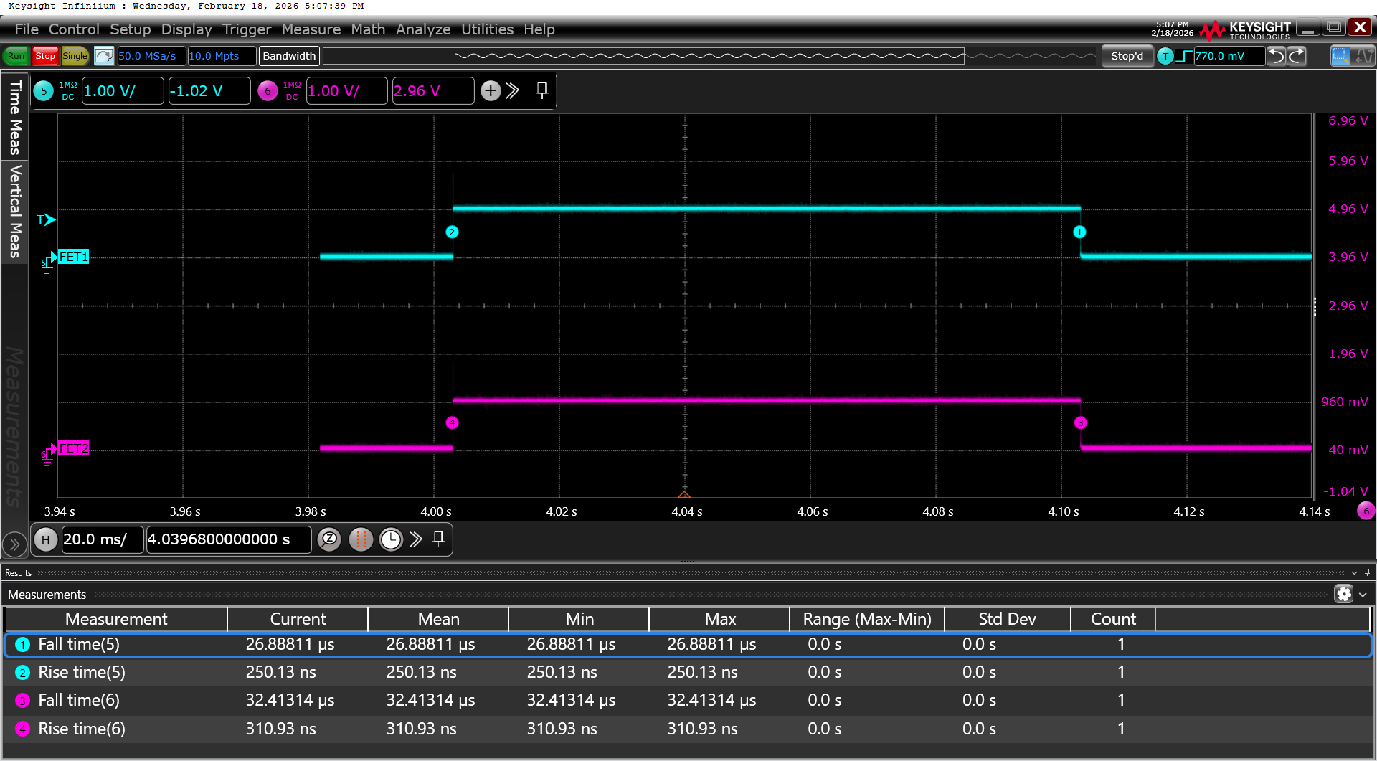
diagramy diplomka svg flashka/TESTS/rise,fall time.png
