MrMicek/AETS/SW/AETS/test_changes.txt

Changes implemented:
- Added test parameter snapshot support in test_seq so relay/mosfet ton/toff and switch counts are applied during the test run; remaining counts decrement on each ON transition.
- Fixed the test sequencer so each relay/mosfet repeats ON/OFF cycles until its remaining switch count reaches zero before moving to the next channel.
- Trigger output now pulses on every positive edge of the configured relay channel.
- Rebuilt the test UI flow: a Start Test submenu provides Current Settings and Profile 1-6 selection, and the running screen now shows live counts and ON/OFF state with top/bottom pages.
- Added end-of-test screens for manual stop, success, max-current error, and zero-current error.
- Added relay health persistence: set/remaining counts load from EEPROM at boot and remaining counts are updated after a test completes for enabled relays.
- Added brownout pending-save handling so relay health and KV stores attempt to persist on low-voltage events.
- Added current monitoring during tests: per-relay current is sampled after each relay ON transition (with a settle delay) and a 10-sample fault streak triggers the corresponding error screen.
- Added EEPROM-backed profiles (1-6) for saving/loading relay/mosfet/trigger/connectivity/buzzer settings (excluding relay health).
- Ensured test-profile settings drive outputs by gating relay/mosfet/trigger control with the active test parameters during TEST mode.
- Added relay current (mA) display to the test running screen for enabled relays.
- Added periodic telemetry output for CAN and USB when their respective connectivity flags are enabled.
- Reordered the main loop to prioritize brownout handling and output sequencing, while keeping UI/comms lowest priority and telemetry only during active tests.
- Split relay and MOSFET sequencing into independent phases so they operate in parallel during tests, and adjusted current sampling to respect short relay TON settings.
- Extended relay and MOSFET sequencing to run independently per-channel so all enabled relays/mosfets toggle concurrently.

How to test:
1) On the device, open Testing -> Start Test and select "Current Settings". Verify the test starts and the running screen updates remaining counts for enabled relays/mosfets.
2) Rotate the encoder to switch between TEST TOP and TEST BOT pages while the test is running.
3) Press the encoder during the test to stop. Confirm the STOP TEST screen appears, then press again to return to the menu.
4) Configure Trigger -> Enable = 1 and select a Relay Channel. With an oscilloscope on TRIGGER_OUT, verify a pulse occurs on every relay ON edge (positive transition).
5) Set relay/mosfet Ton/Toff and switch count values, start the test, and verify the waveform timing matches the configured parameters.
6) Open Relays -> Set Count and set Relay1 (k) to a value. Confirm Relays -> Remain Count shows the same value.
7) Run a test with Relay1 enabled, then stop it early. Confirm the remaining count decreases after the test ends (saved to EEPROM).
8) Power cycle the device and verify the Relay Remain Count retains its last saved value.
9) Save a profile (Profile -> Profile 1 -> Save to profile), change relay/mosfet parameters, then Load from profile and confirm settings restore.
10) Start a test using Testing -> Start Test -> Profile 1 and confirm the relays/mosfets switch based on the saved profile settings.
11) During a running test, confirm the relay lines show the current values next to the ON/OFF status on the TEST screens.
12) Run a test with a relay enabled and set I-max. Force current above I-max for 10 consecutive ON samples; confirm the MAX CURRENT error screen appears.
13) Run a test with a relay enabled and force 0 current for 10 consecutive ON samples; confirm the NO CURRENT FLOW error screen appears.
14) Enable Connectivity -> CAN Output and confirm CAN frames are published once per second (IDs 49 and 50) with relay counts, states, currents, and MOSFET/MUX states (only during active tests).
15) Enable Connectivity -> USB Output and confirm a line like `out <timestamp> r1 <remain> <state> <current> ... m1 <state> m2 <state>` appears once per second on USB (only during active tests).
16) Trigger a brownout event and confirm relay health/KV pending saves are prioritized before other loop work (observe persistence after power cycle).
17) Run a test with all relays and both MOSFETs enabled and confirm each channel toggles independently according to its parameters.
