MrMicek/AETS/diagramy diplomka svg flashka/TESTS/mosfet riskfall time/scope_0.png

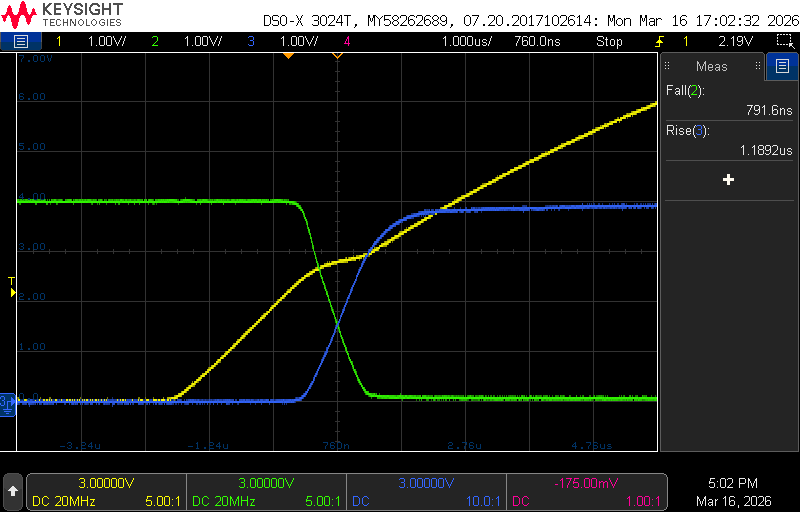
diagramy diplomka svg flashka/TESTS/mosfet riskfall time/scope_0.png
