MrMicek/AETS/diagramy diplomka svg flashka/TESTS/mosfet riskfall time/scope_1.png

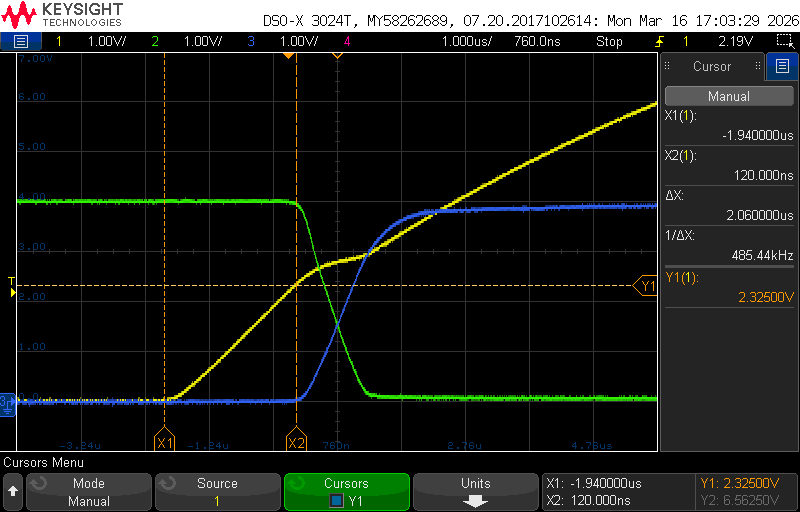
diagramy diplomka svg flashka/TESTS/mosfet riskfall time/scope_1.png
