MrMicek/AETS/diagramy diplomka svg flashka/TESTS/mosfet riskfall time/scope_2.png

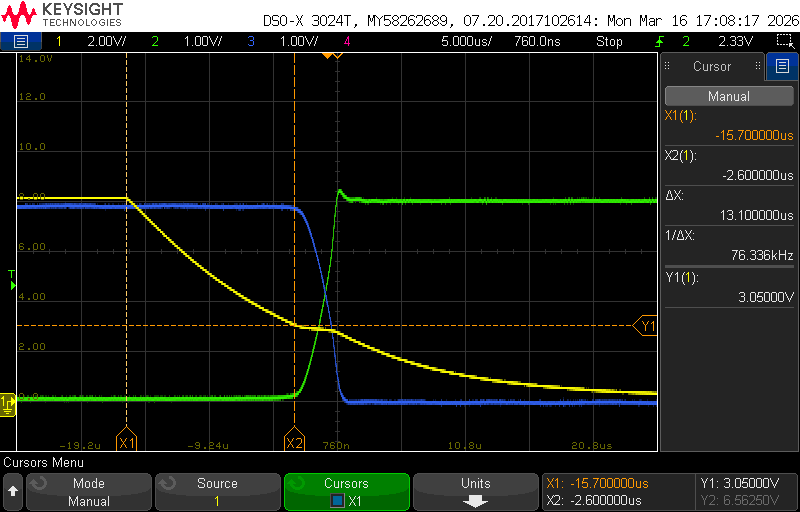
diagramy diplomka svg flashka/TESTS/mosfet riskfall time/scope_2.png
