MrMicek/AETS/diagramy diplomka svg flashka/TESTS/mosfet riskfall time/scope_3.png

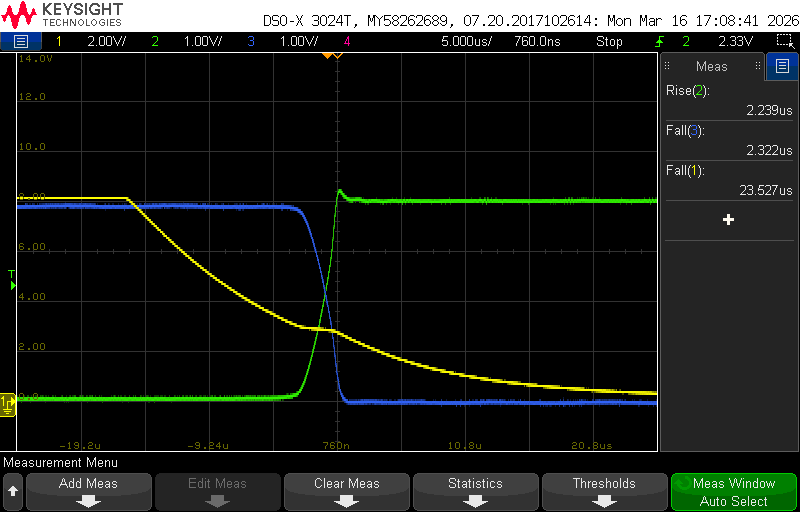
diagramy diplomka svg flashka/TESTS/mosfet riskfall time/scope_3.png
