MrMicek/AETS/diagramy diplomka svg flashka/TESTS/mosfet riskfall time/scope_4.png

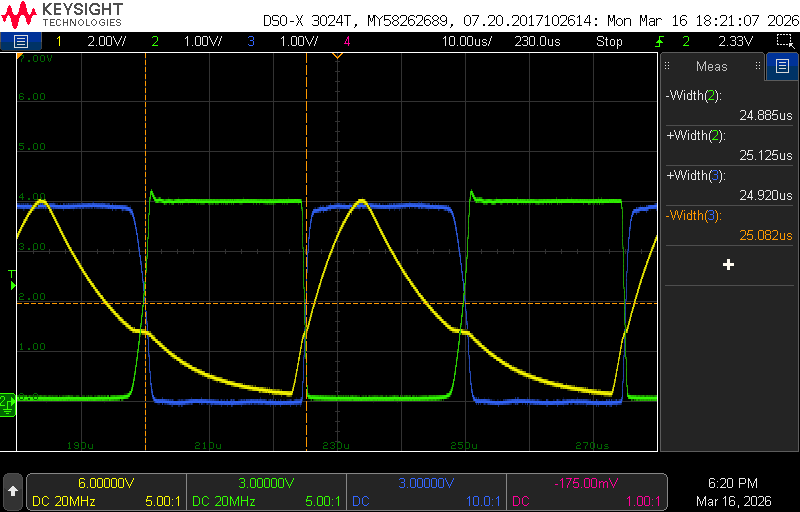
diagramy diplomka svg flashka/TESTS/mosfet riskfall time/scope_4.png
