MrMicek/AETS/diagramy diplomka svg flashka/TESTS/mosfet riskfall time/scope_5.png

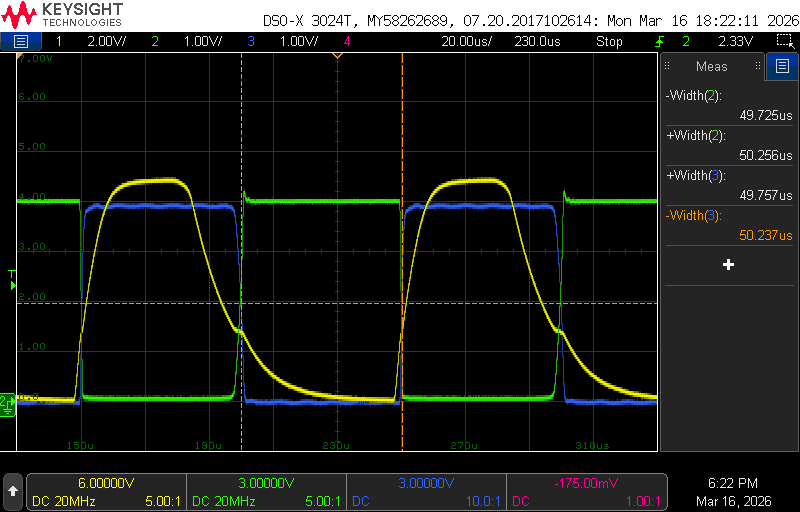
diagramy diplomka svg flashka/TESTS/mosfet riskfall time/scope_5.png
