MrMicek/AETS/diagramy diplomka svg flashka/diagramy diplomka svg/PLOTS/AETS-CZ-NB-3L0Y7S3.pdf

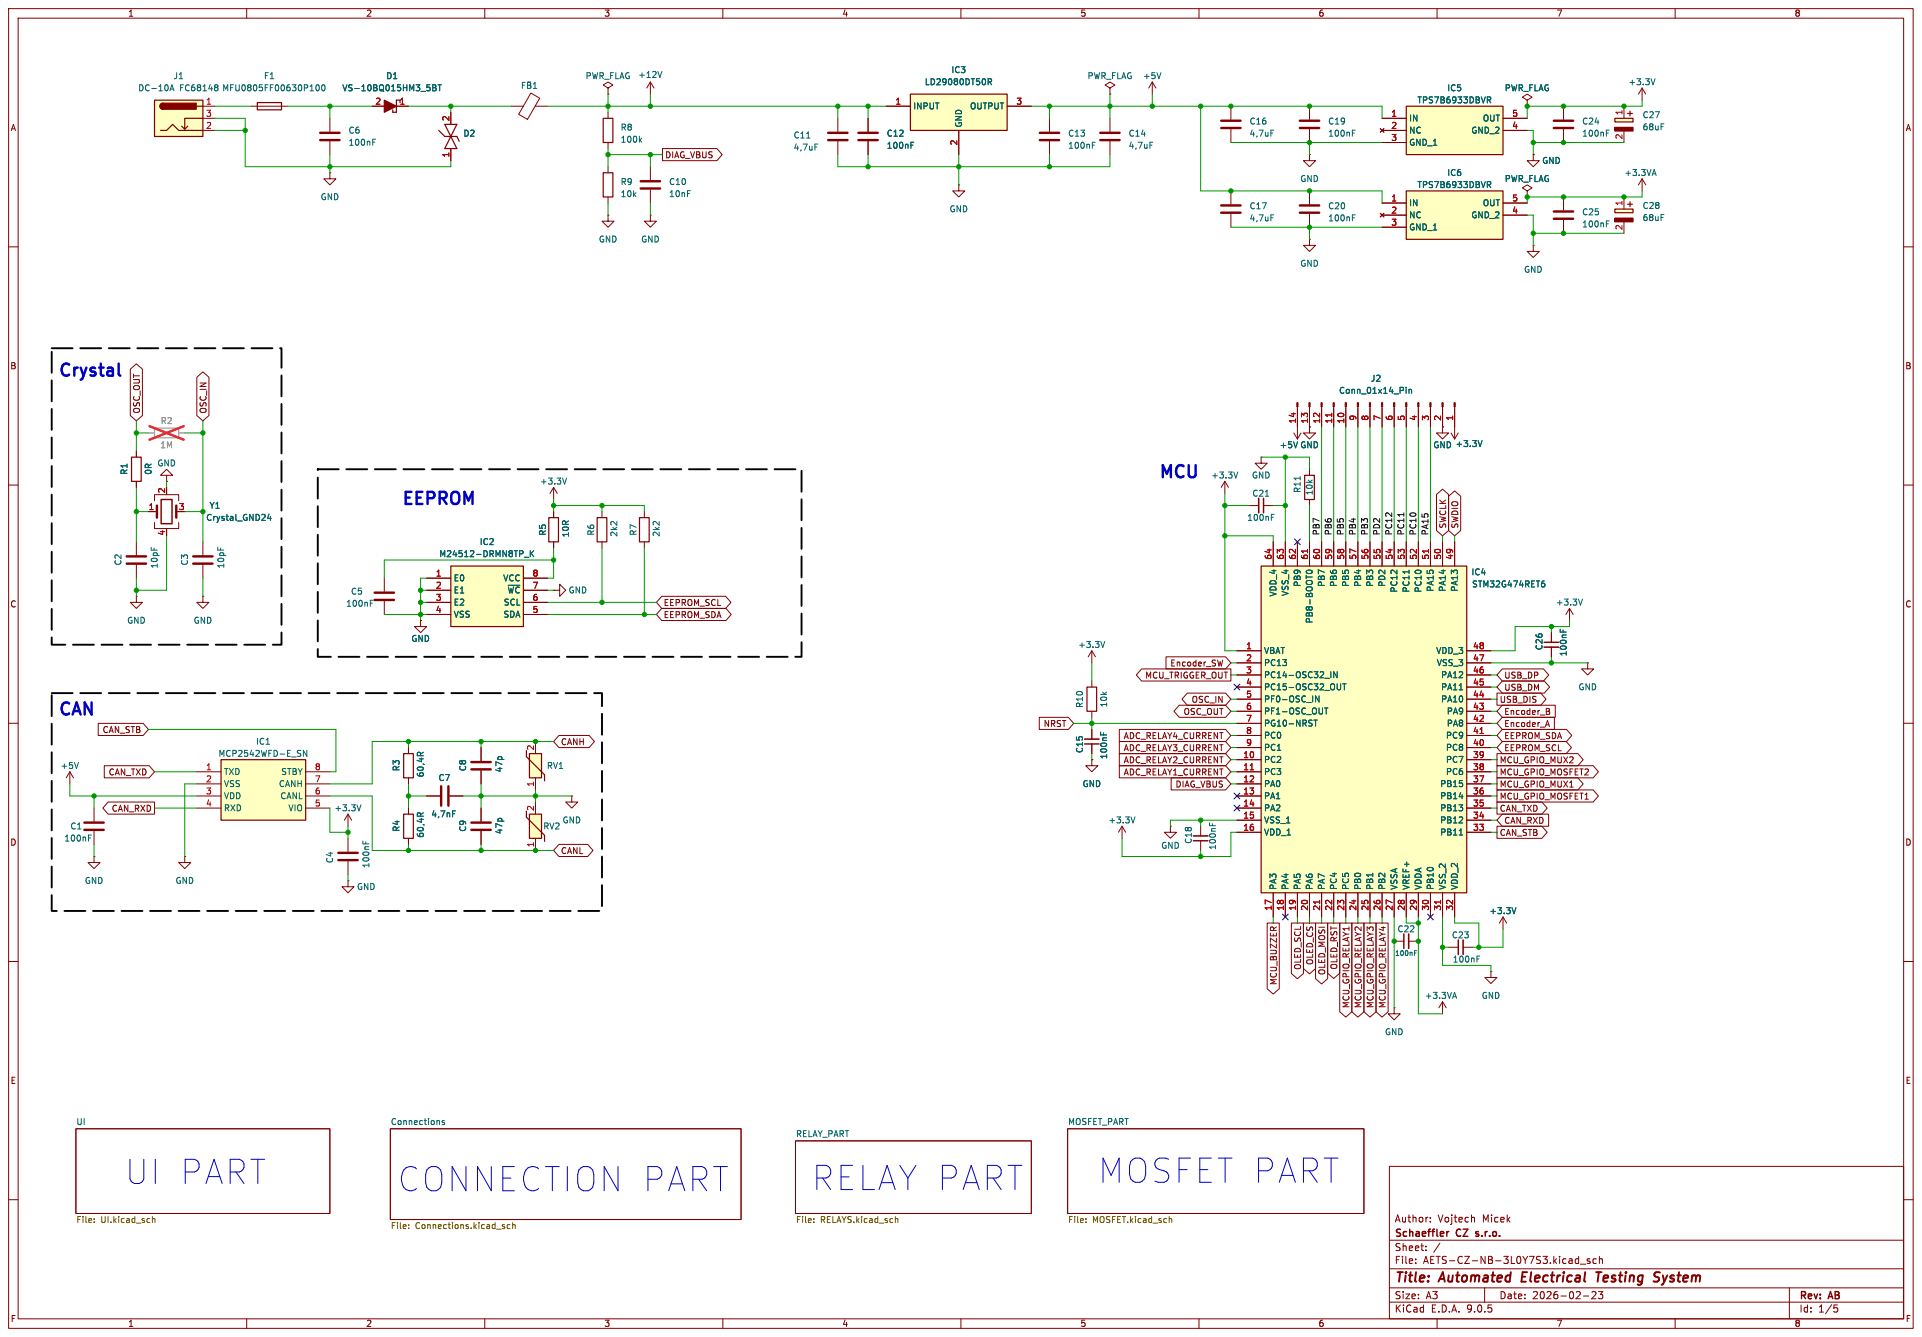
[picture p128: page 1]

Id: 1/5 Title: Automated Electrical Testing System

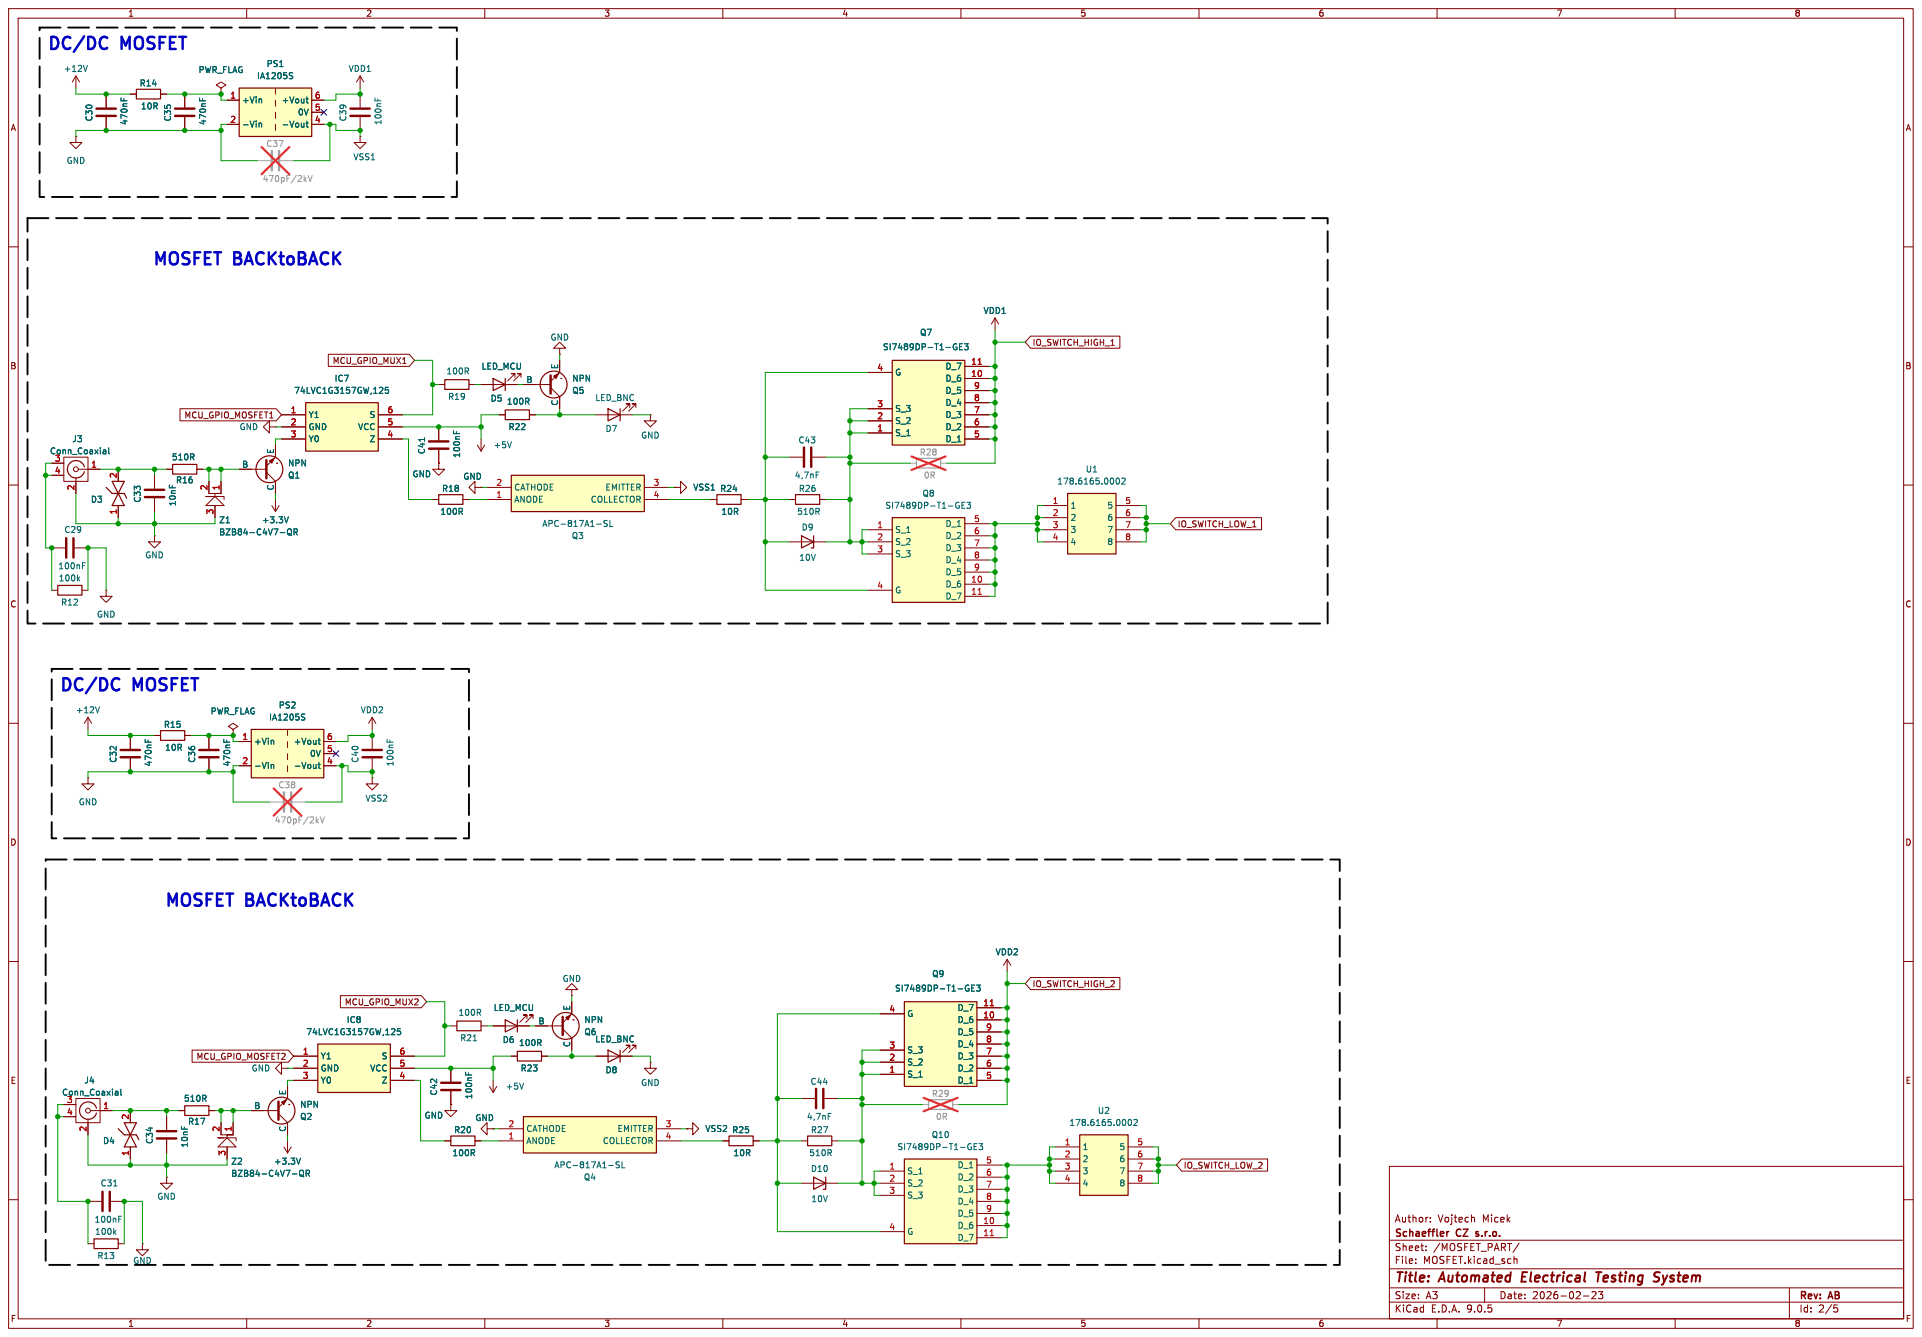
[picture p129: page 2]

Id: 2/5 Title: Automated Electrical Testing System

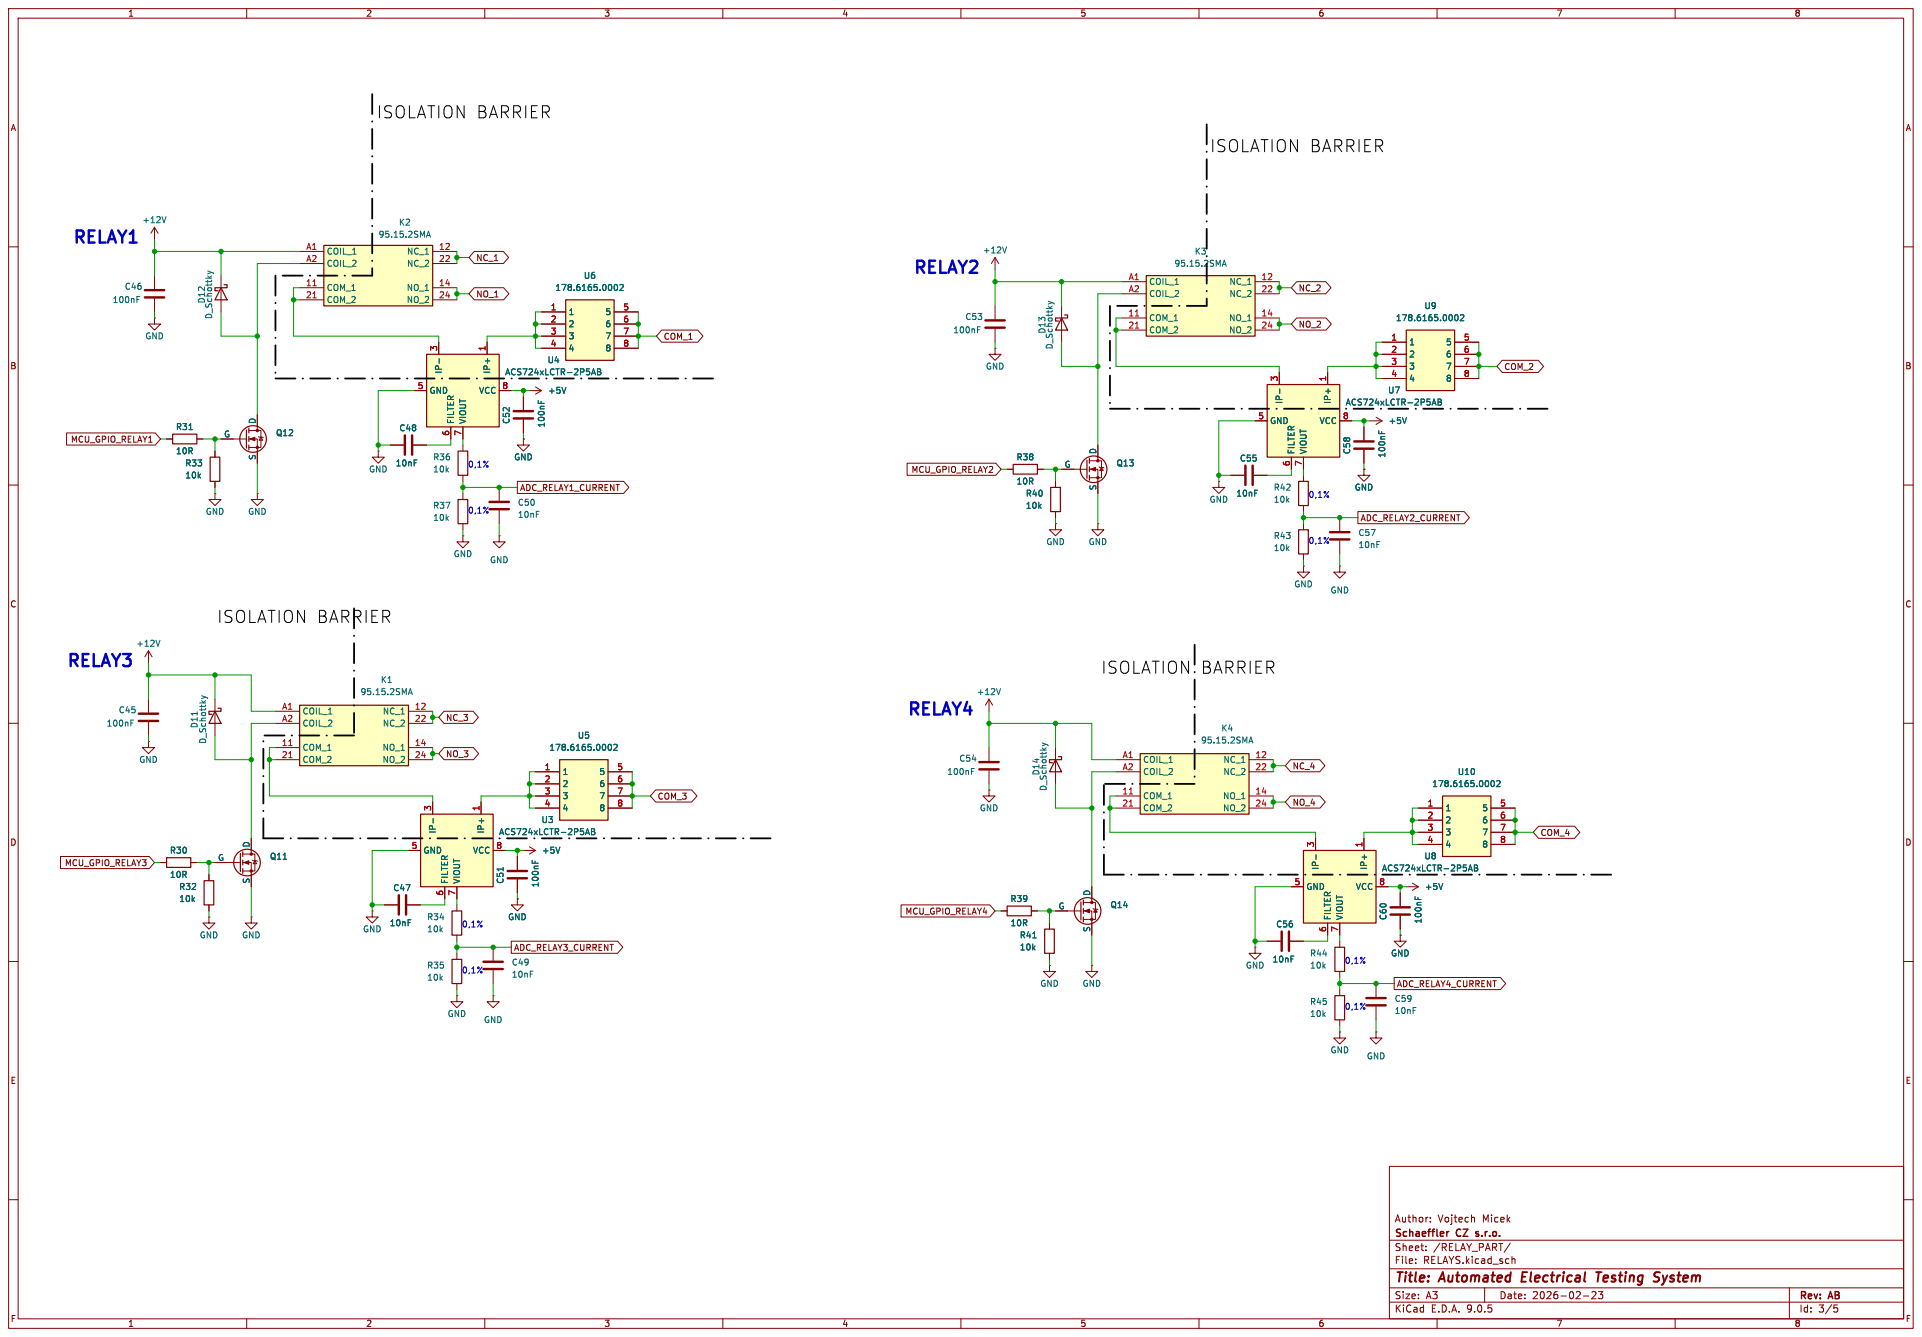
[picture p130: page 3]

1 IP- 3 VCC 8 GND 5 VIOUT

Id: 3/5 Title: Automated Electrical Testing System

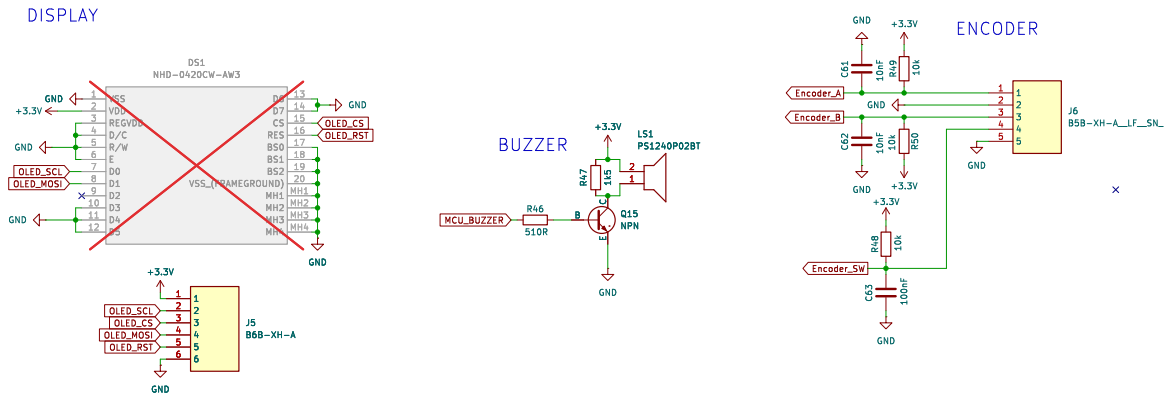
[picture p131: page 4]

Id: 4/5 Title: Automated Electrical Testing System

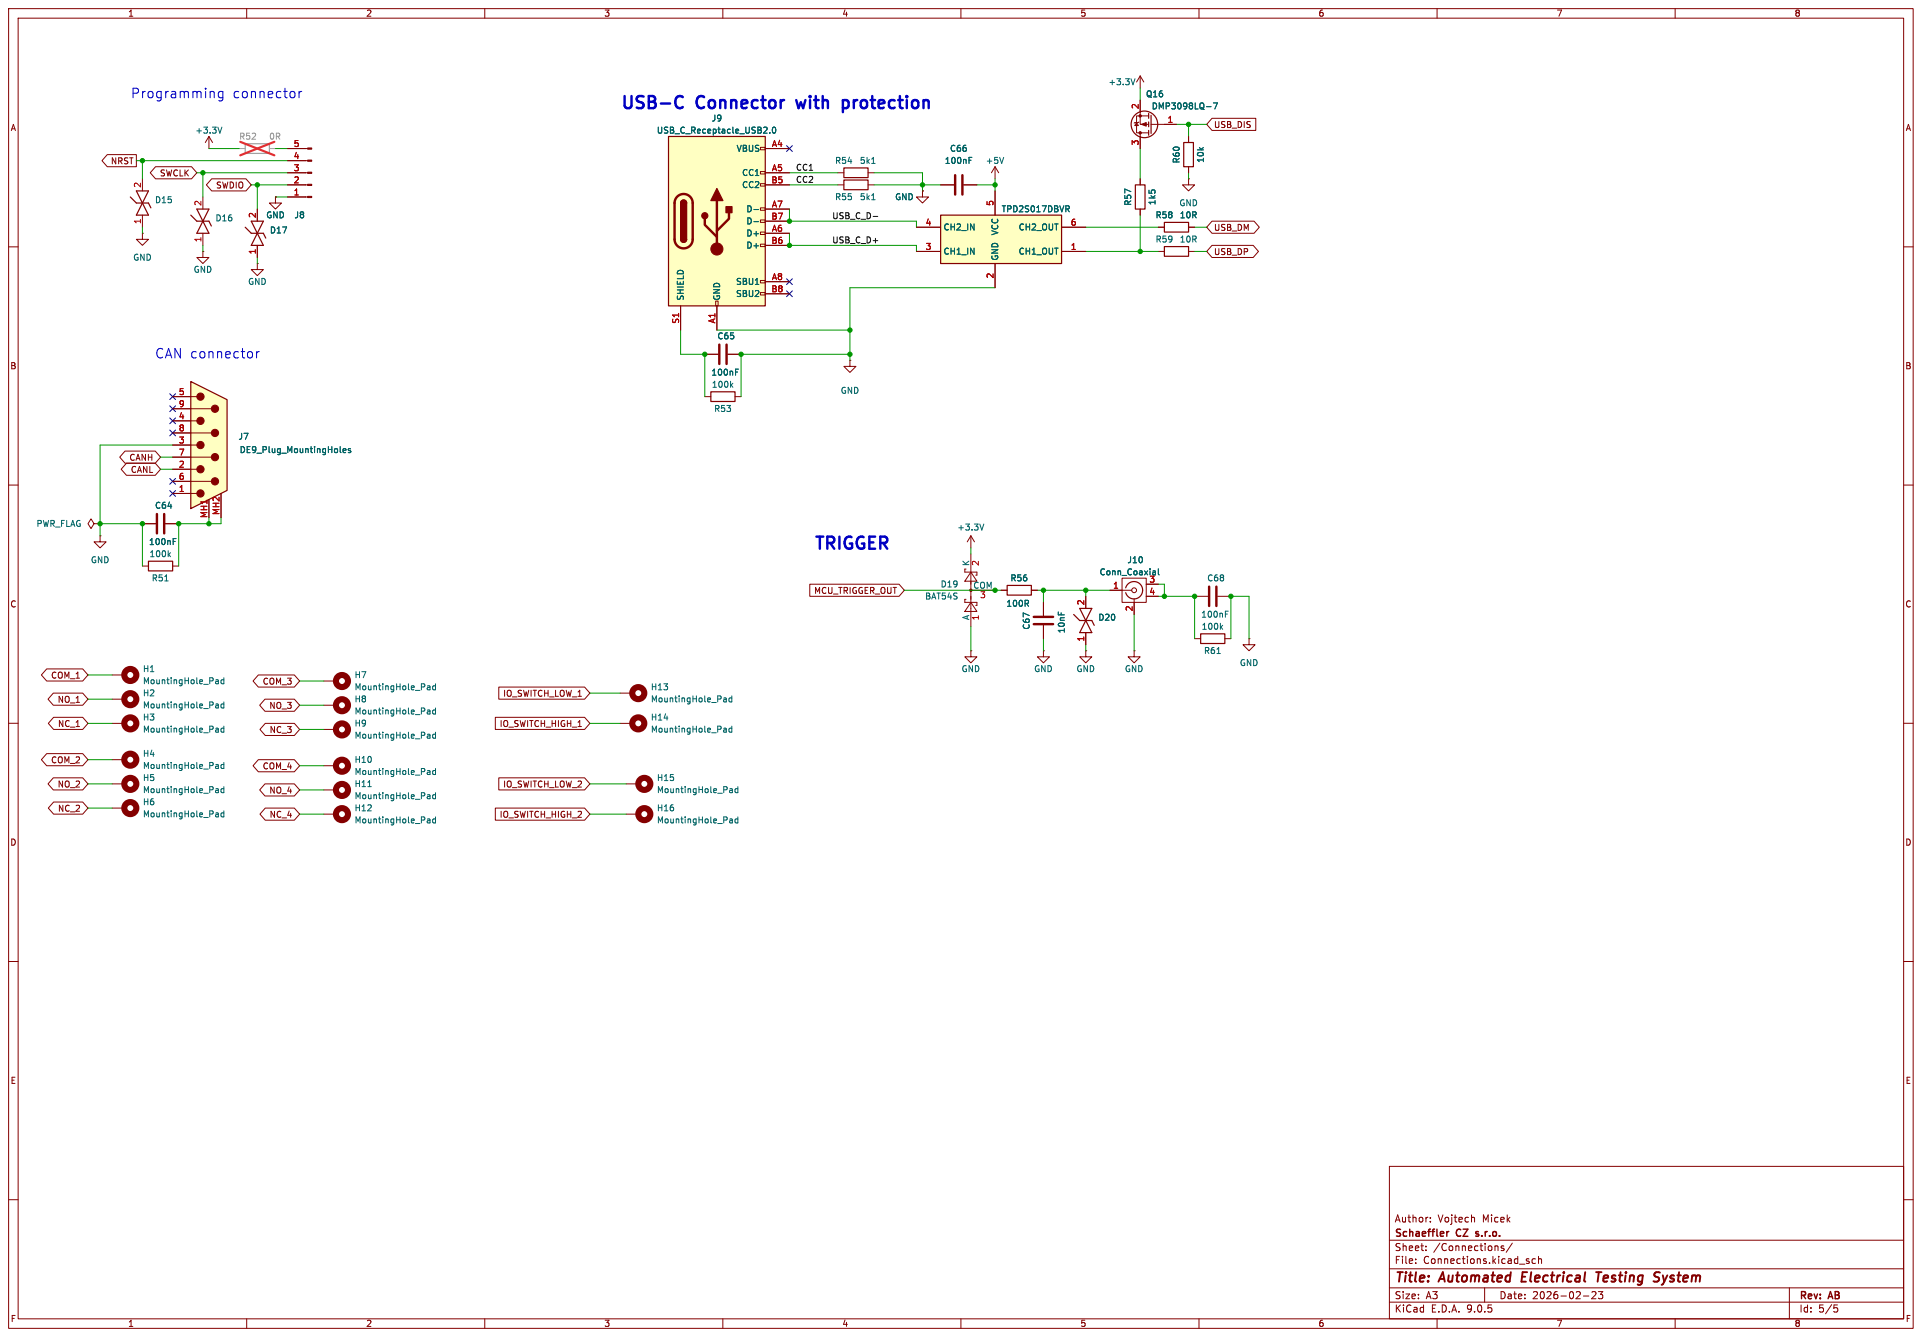
[picture p132: page 5]

Id: 5/5 Title: Automated Electrical Testing System
