MrMicek/AETS/HW/simulations/backToBack.asc

C1: cap; 10p
D1: zener; UFZV10B
M1: pmos; Si7489DP
M2: pmos; Si7489DP
R1: res; 500
R2: res; 10
R3: res; 100
R4: res; 10
R5: res; 10Meg
R6: res; 0.01
U1: PC817A
V1: voltage; PULSE(0 3.3 0 1n 1n 1m 2m 2)
V2: voltage; SINE(0 60 1k 0 0 0 1000)
VBAT+: voltage; 12; Rser=100m
vdd: voltage; 10; Rser=100m
Named nets: 0, VBAT+, VBAT-, MCU, gate, source
.tran 6m
