MrMicek/AETS/HW/simulations/Draft1.asc

C1: cap; 1n
D1: zener; BZX84C12L
M1: pmos; Si7489DP
M2: pmos; Si7489DP
R1: res; 100k
R2: res; 10
R3: res; 100
R4: res; 1k
U1: PC817B
V1: voltage; 5
V2: voltage; 60
V3: voltage; PULSE(0 3.3 1n 10n 10n 0.5 1 2); Rser=100m
Named nets: 0
.tran 0 200u 0 10u
