MrMicek/AETS/HW/simulations/Draft2.asc

D1: zener; BZX84C12L
M1: pmos; Si7489DP
M2: pmos; Si7489DP
R1: res; 10
R2: res; 100
R3: res; 10
R4: res; 100k
U1: PC817B
V1: voltage; 60; Rser=100
V2: voltage; PULSE(0 3.3 1n 10n 10n 0.5 1 2); Rser=100m
V3: voltage; 12; Rser=100m
Named nets: 0, gate, source, VBAT
.tran 1m
