MrMicek/AETS/HW/simulations/Draft6.asc

D1: zener; UFZV15B
M1: pmos; Si7489DP
M2: pmos; Si7489DP
R1: res; 100k
R2: res; 10
R3: res; 50
R4: res; 100
U1: PC817A
V1: voltage; PULSE(0 3.3 0 1n 1n 500u 1m 5)
VBAT+: voltage; 30; Rser=100m
VBAT-: voltage; -30; Rser=100m
Vdd: voltage; -6; Rser=100m
Vss: voltage; 6; Rser=100m
Named nets: 0, Vss, Vdd, VBAT+, VBAT-
.tran 10m
