MrMicek/AETS/HW/simulations/PMOSFET.asc

C1: cap; 100µ
D1: schottky; 1N5817
M1: pmos; RSJ250P10
R1: res; 10R
R2: res; 10k
V1: voltage; PULSE(12 0 100n 80n 90n 0.1 0.2 4)
V2: voltage; 60; Rser=50
Named nets: 0
.tran 20
