MrMicek/AETS/(list of files, drawings)

Other design files:
HW/simulations/spice components/sqm40p10-40l_ps/SQM40P10-40L_PS.olb
HW/simulations/spice components/sqm40p10-40l_ps/SQM40P10-40L_PS_RC.OLB
