MrMicek/AETS/HW/KiCad/AETS/AETS-CZ-NB-3L0Y7S3.kicad_pcb

## KiCad design HW/KiCad/AETS/AETS-CZ-NB-3L0Y7S3.kicad_pcb (2026-02-23)

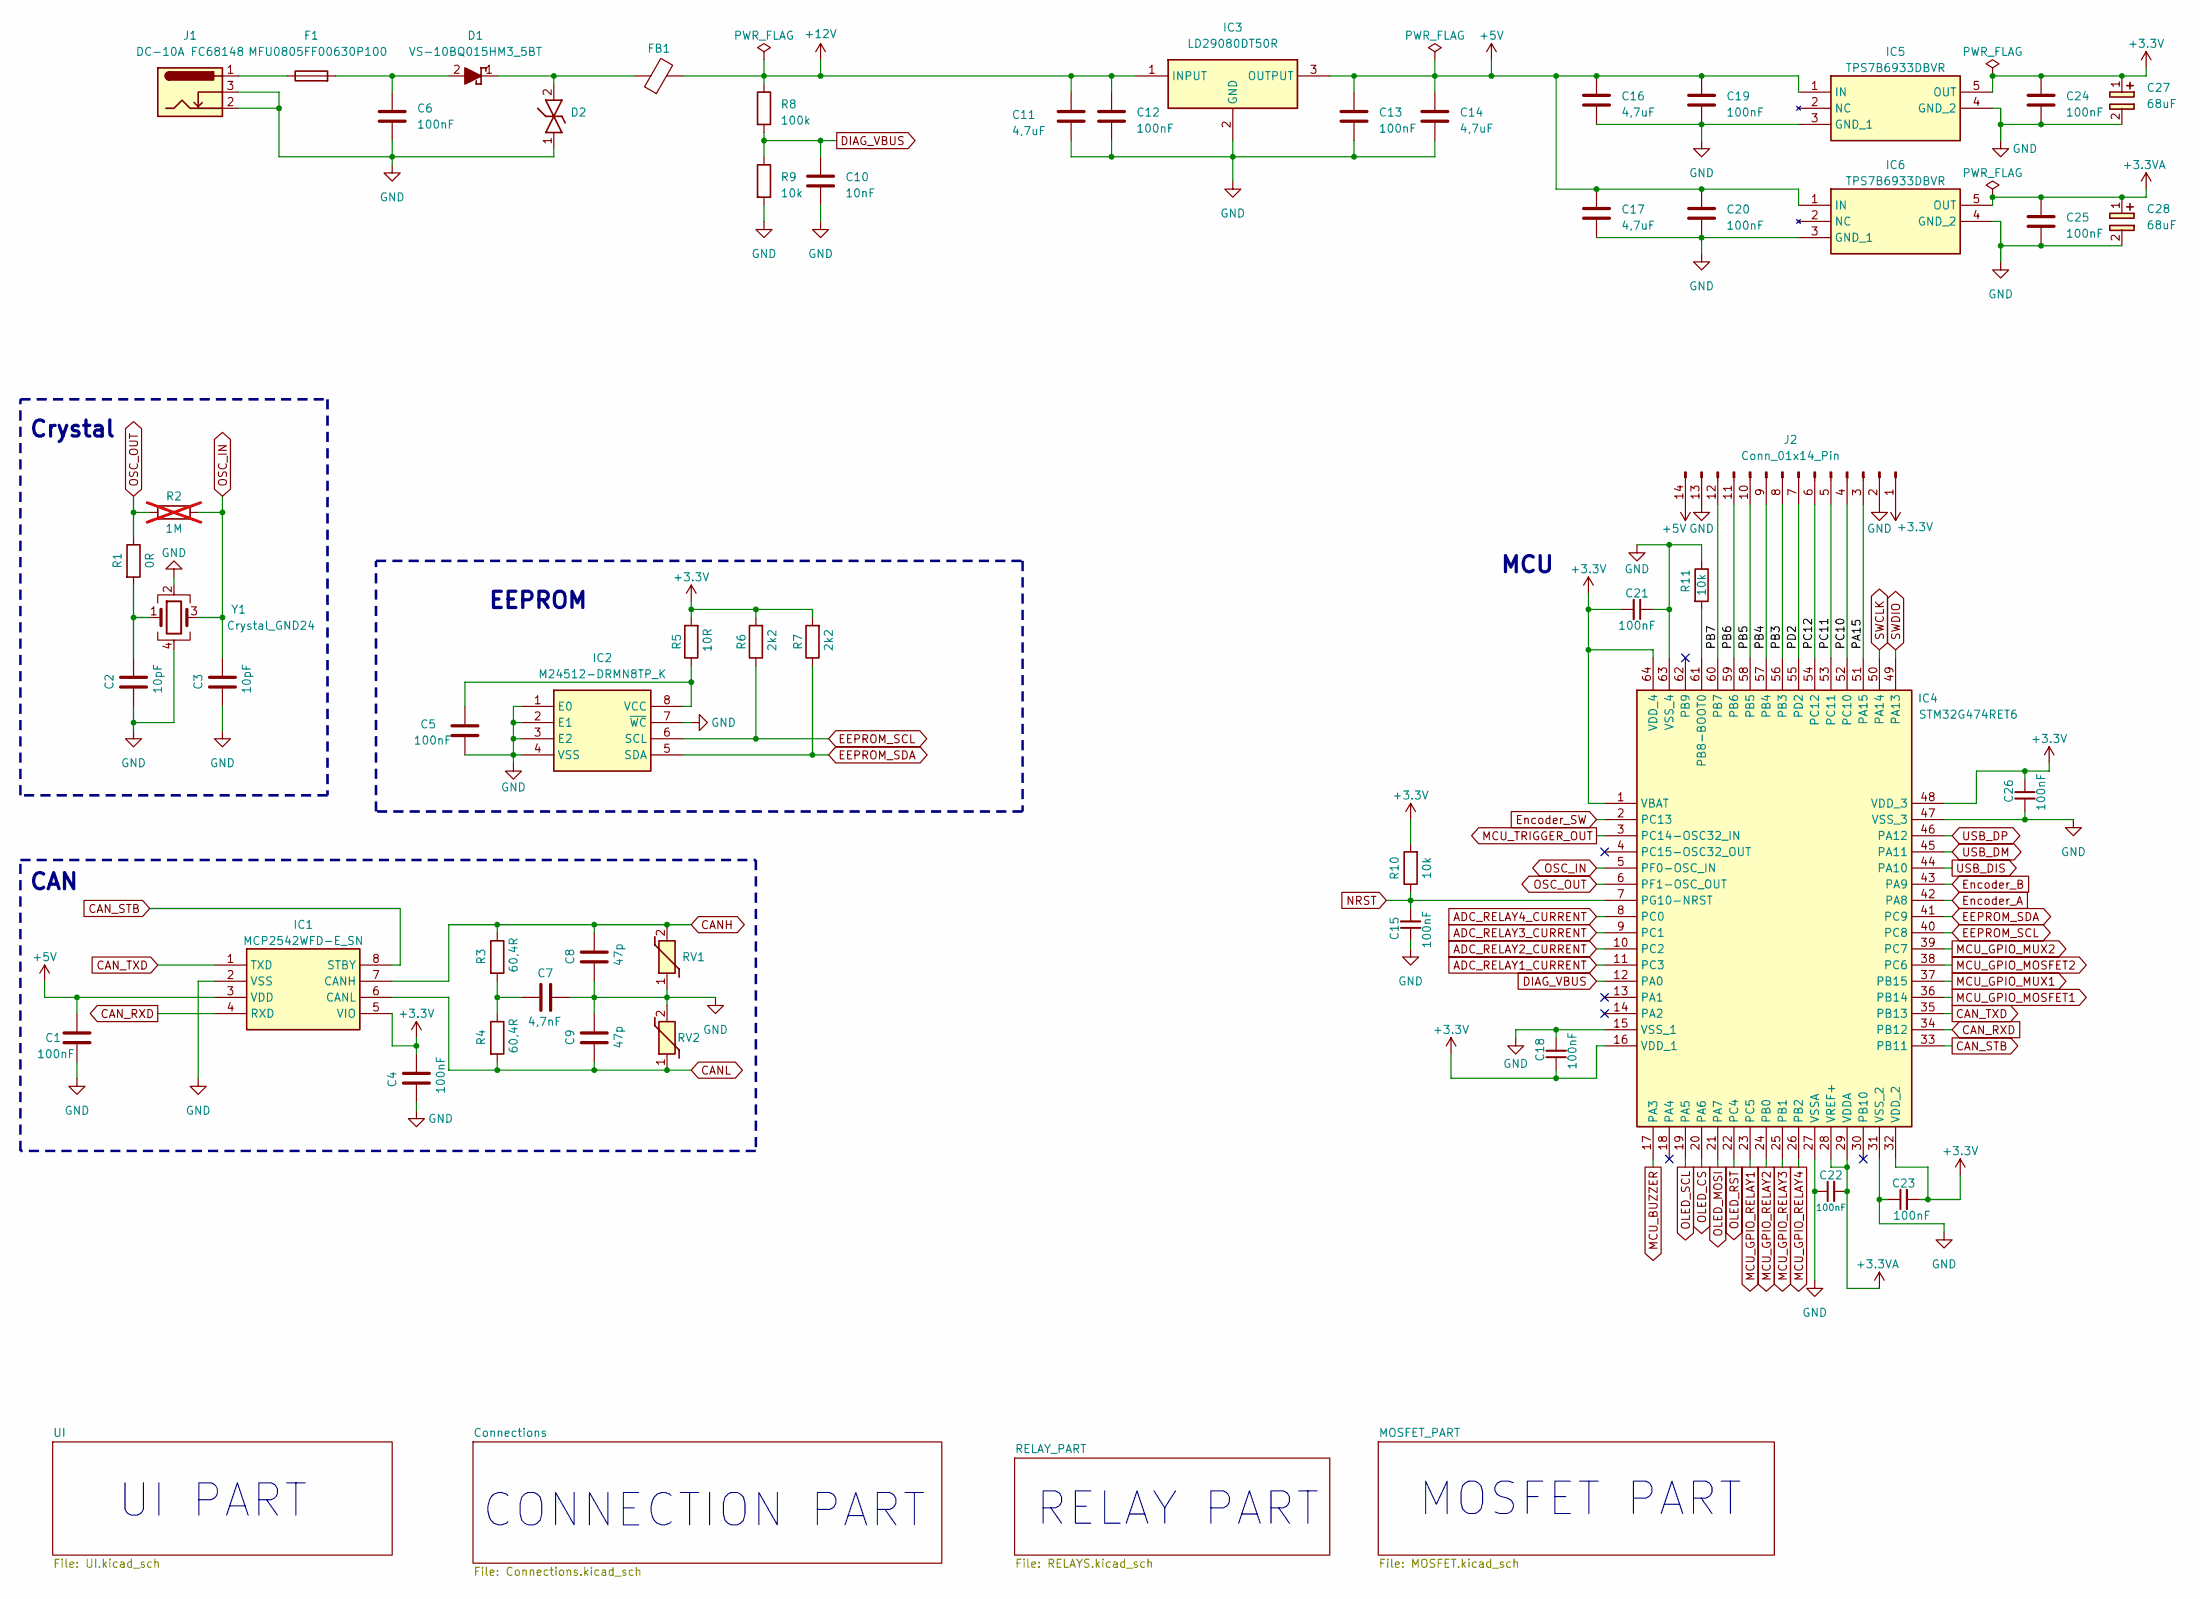
[picture p133: schematic AETS-CZ-NB-3L0Y7S3.kicad_sch, Automated Electrical Testing System]

Parts:
C1, C4, C5, C6, C12, C13, C19, C20, C24, C25: 100nF; C_0805_2012Metric
C2, C3: 10pF; C_0603_1608Metric
C7: 4,7nF; C_0805_2012Metric
C8, C9: 47p; C_0805_2012Metric
C10: 10nF; C_0805_2012Metric
C11, C14, C16, C17: 4,7uF; C_1210_3225Metric
C15, C18, C21, C22, C23, C26: 100nF; C_0603_1608Metric
C27, C28: 68uF; EEEHP1H4R7P; Mouser Part Number 667-EEE-FP1C680AL
D1: VS-10BQ015HM3_5BT; DIOM5436X244N; Mouser Part Number 78-VS-10BQ015HM35BT
D2: 1.5B18CA-M3/H; DIOM5436X244N; Manufacturer_Part_Number TESDU5V0 RGG
F1: MFU0805FF00630P100; Fuse_0805_2012Metric
FB1: R_0805_2012Metric_Pad1.20x1.40mm_HandSolder
IC1: MCP2542WFD-E_SN; SOIC127P600X175-8N; Manufacturer_Part_Number MCP2542WFD-E/SN; Mouser Part Number 579-MCP2542WFD-E/SN
IC2: M24512-DRMN8TP_K; SOIC127P600X175-8N; Manufacturer_Part_Number M24512-DRMN8TP/K; Mouser Part Number 511-M24512-DRMN8TP/K
IC3: LD29080DT50R; L4931CDT50TR; Manufacturer_Part_Number L4931CDT50-TR; Mouser Part Number 511-L4931CDT50-TR
IC4: STM32G474RET6; QFP50P1200X1200X160-64N; Manufacturer_Part_Number STM32G474RET6; Mouser Part Number 511-STM32G474RET6
IC5, IC6: TPS7B6933DBVR; SOT95P280X145-5N; Manufacturer_Part_Number TPS7B6950QDBVRQ1; Mouser Part Number 595-TPS7B6950QDBVRQ1
J1: DC-10A FC68148; DC10AFC68148
J2: Conn_01x14_Pin; PinHeader_1x14_P2.54mm_Vertical
R1: 0R; R_0603_1608Metric
R2: 1M; R_0603_1608Metric; not fitted
R3, R4: 60,4R; R_0805_2012Metric
R5: 10R; R_0805_2012Metric
R6, R7: 2k2; R_0805_2012Metric
R8: 100k; R_0805_2012Metric
R9: 10k; R_0805_2012Metric
R10, R11: 10k; R_0603_1608Metric
RV1, RV2: AVR-M1608C270KTACB; VARC1608X90N; Mouser Part Number 810-AVRM1608C270KACB
Y1: Crystal_GND24; ECS4001833JGNTR3

Connections:
+3.3V: C4.1, C18.1, C21.2, C23.2, C24.1, C26.1, C27.1 (+), IC1.5 (VIO), IC4.1 (VBAT), IC4.16 (VDD_1), IC4.32 (VDD_2), IC4.48 (VDD_3), IC4.64 (VDD_4), IC5.5 (OUT), J2.1, R5.2, R6.2, R7.2, R10.2; also elsewhere on the board
+3.3VA: C22.2, C25.1, C28.1 (+), IC4.28 (VREF+), IC4.29 (VDDA), IC6.5 (OUT)
+5V: C1.1, C13.1, C14.1, C16.1, C17.1, C19.1, C20.1, IC1.3 (VDD), IC3.3 (OUTPUT), IC5.1 (IN), IC6.1 (IN), J2.14; also elsewhere on the board
+12V: C11.1, C12.1, FB1.2, IC3.1 (INPUT), R8.1; also elsewhere on the board
/PA15: IC4.51 (PA15), J2.3
/PB3: IC4.56 (PB3), J2.8
/PB4: IC4.57 (PB4), J2.9
/PB5: IC4.58 (PB5), J2.10
/PB6: IC4.59 (PB6), J2.11
/PB7: IC4.60 (PB7), J2.12
/PC10: IC4.52 (PC10), J2.4
/PC11: IC4.53 (PC11), J2.5
/PC12: IC4.54 (PC12), J2.6
/PD2: IC4.55 (PD2), J2.7
ADC_RELAY1_CURRENT: IC4.11 (PC3); also elsewhere on the board
ADC_RELAY2_CURRENT: IC4.10 (PC2); also elsewhere on the board
ADC_RELAY3_CURRENT: IC4.9 (PC1); also elsewhere on the board
ADC_RELAY4_CURRENT: IC4.8 (PC0); also elsewhere on the board
CANH: C8.1, IC1.7 (CANH), R3.1, RV1.2; also elsewhere on the board
CANL: C9.2, IC1.6 (CANL), R4.2, RV2.1; also elsewhere on the board
CAN_RXD: IC1.4 (RXD), IC4.34 (PB12)
CAN_STB: IC1.8 (STBY), IC4.33 (PB11)
CAN_TXD: IC1.1 (TXD), IC4.35 (PB13)
DIAG_VBUS: C10.1, IC4.12 (PA0), R8.2, R9.1
EEPROM_SCL: IC2.6 (SCL), IC4.40 (PC8), R6.1
EEPROM_SDA: IC2.5 (SDA), IC4.41 (PC9), R7.1
Encoder_A: IC4.42 (PA8); also elsewhere on the board
Encoder_B: IC4.43 (PA9); also elsewhere on the board
Encoder_SW: IC4.2 (PC13); also elsewhere on the board
GND: C1.2, C2.2, C3.2, C4.2, C5.2, C6.2, C7.2, C8.2, C9.1, C10.2, C11.2, C12.2, C13.2, C14.2, C15.1, C16.2, C17.2, C18.2, C19.2, C20.2, C21.1, C22.1, C23.1, C24.2, C25.2, C26.2, C27.2 (-), C28.2 (-), D2.1 (K1), IC1.2 (VSS), IC2.1 (E0), IC2.2 (E1), IC2.3 (E2), IC2.4 (VSS), IC2.7 (~WC), IC3.2 (GND), IC4.15 (VSS_1), IC4.27 (VSSA), IC4.31 (VSS_2), IC4.47 (VSS_3), IC4.63 (VSS_4), IC5.3 (GND_1), IC5.4 (GND_2), IC6.3 (GND_1), IC6.4 (GND_2), J1.2, J1.3, J2.2, J2.13, R9.2, R11.1, RV1.1, RV2.2, Y1.2, Y1.4; also elsewhere on the board
MCU_BUZZER: IC4.17 (PA3); also elsewhere on the board
MCU_GPIO_MOSFET1: IC4.36 (PB14); also elsewhere on the board
MCU_GPIO_MOSFET2: IC4.38 (PC6); also elsewhere on the board
MCU_GPIO_MUX1: IC4.37 (PB15); also elsewhere on the board
MCU_GPIO_MUX2: IC4.39 (PC7); also elsewhere on the board
MCU_GPIO_RELAY1: IC4.23 (PC5); also elsewhere on the board
MCU_GPIO_RELAY2: IC4.24 (PB0); also elsewhere on the board
MCU_GPIO_RELAY3: IC4.25 (PB1); also elsewhere on the board
MCU_GPIO_RELAY4: IC4.26 (PB2); also elsewhere on the board
MCU_TRIGGER_OUT: IC4.3 (PC14-OSC32_IN); also elsewhere on the board
NRST: C15.2, IC4.7 (PG10-NRST), R10.1; also elsewhere on the board
unnamed: C2.1, R1.2, Y1.1
unnamed: C7.1, R3.2, R4.1
unnamed: C6.1, D1.2 (A), F1.2
unnamed: D1.1 (K), D2.2 (K2), FB1.1
unnamed: F1.1, J1.1
unnamed: C5.1, IC2.8 (VCC), R5.1
unnamed: IC4.61 (PB8-BOOT0), R11.2
OLED_CS: IC4.20 (PA6); also elsewhere on the board
OLED_MOSI: IC4.21 (PA7); also elsewhere on the board
OLED_RST: IC4.22 (PC4); also elsewhere on the board
OLED_SCL: IC4.19 (PA5); also elsewhere on the board
OSC_IN: C3.1, IC4.5 (PF0-OSC_IN), R2.2, Y1.3
OSC_OUT: IC4.6 (PF1-OSC_OUT), R1.1, R2.1
SWCLK: IC4.50 (PA14); also elsewhere on the board
SWDIO: IC4.49 (PA13); also elsewhere on the board
USB_DIS: IC4.44 (PA10); also elsewhere on the board
USB_DM: IC4.45 (PA11); also elsewhere on the board
USB_DP: IC4.46 (PA12); also elsewhere on the board

Notes on the sheet:
MOSFET PART
RELAY PART
MCU
Crystal
UI PART
CAN
EEPROM
CONNECTION PART

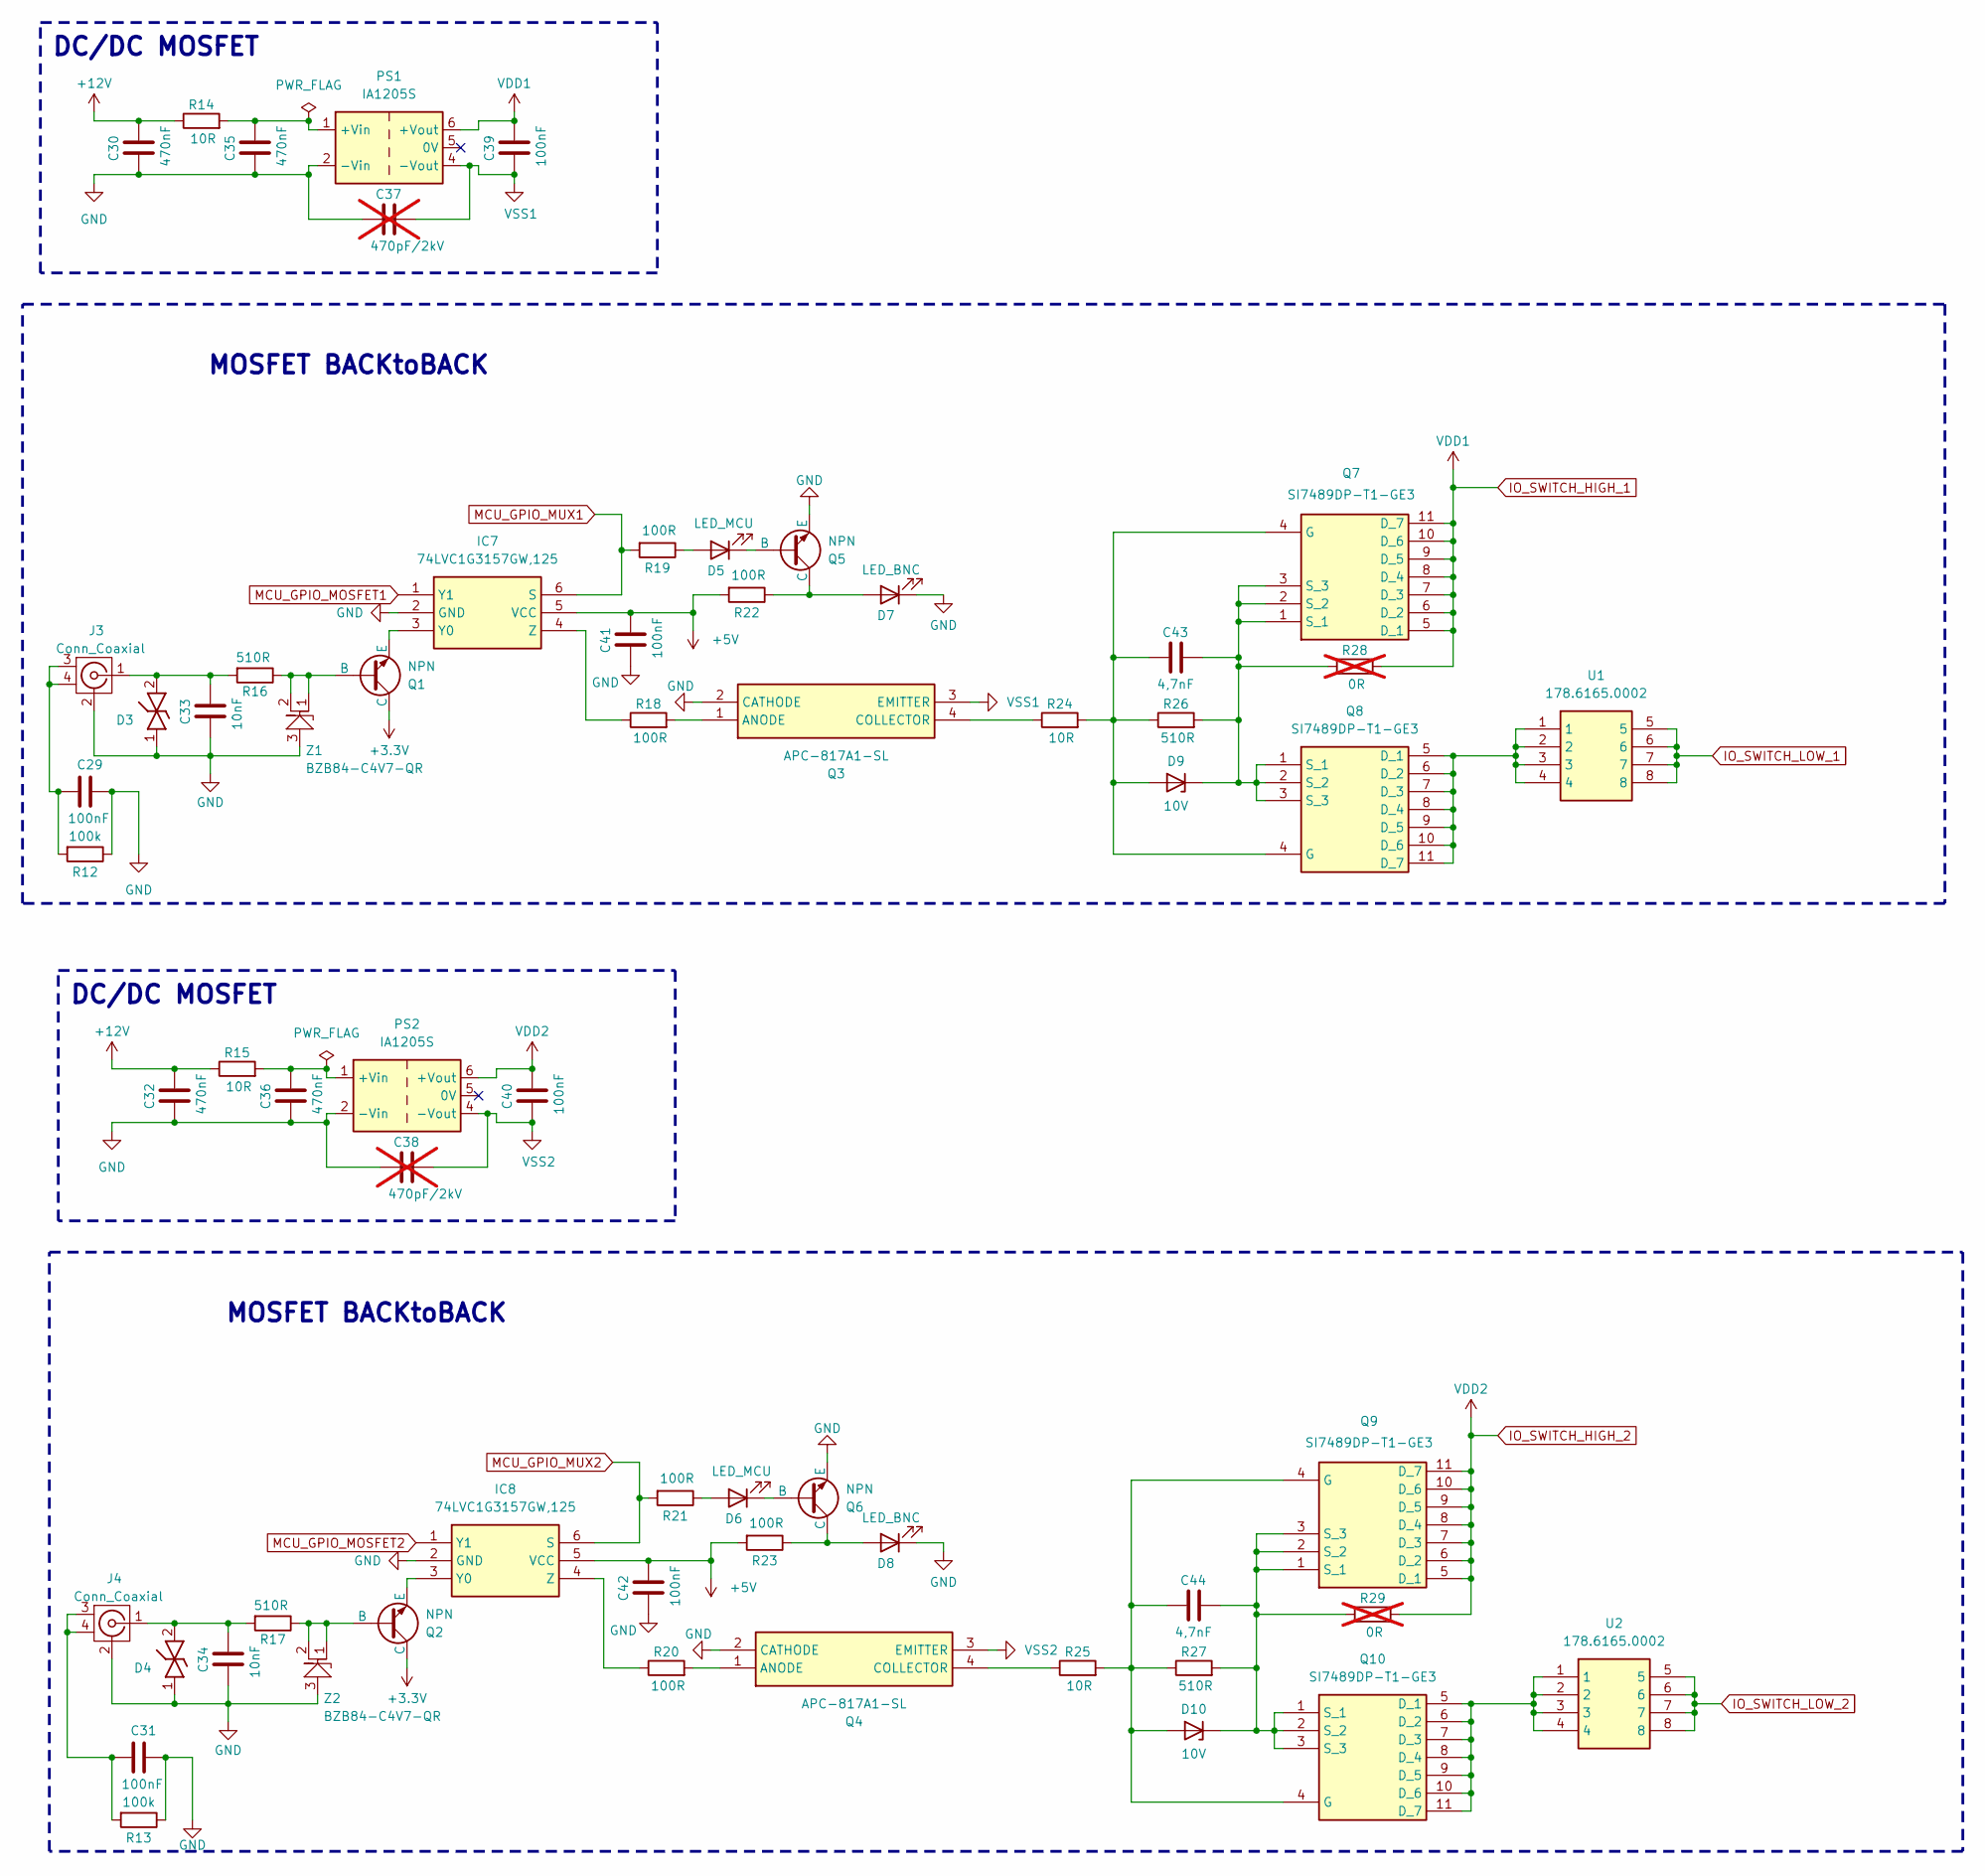
[picture p134: schematic MOSFET.kicad_sch, Automated Electrical Testing System]

Parts:
C29, C31, C39, C40, C41, C42: 100nF; C_0805_2012Metric
C30, C32, C35, C36: 470nF; C_0805_2012Metric
C33, C34: 10nF; C_0805_2012Metric
C37, C38: 470pF/2kV; C_1210_3225Metric; not fitted
C43, C44: 4,7nF; C_0805_2012Metric
D3, D4: TESDU5V0 RGG; DIONC1608X70N; Manufacturer_Part_Number TESDU5V0 RGG
D5, D6: LED_MCU; LED_D3.0mm
D7, D8: LED_BNC; LED_D3.0mm
D9, D10: 10V; SODFL5026X125N
IC7, IC8: 74LVC1G3157GW,125; 74LVC1G3157GW125; Manufacturer_Part_Number 74LVC1G3157GW,125; Mouser Part Number 771-LVC1G3157GW125
J3, J4: Conn_Coaxial; VBI211
PS1, PS2: IA1205S; Converter_DCDC_XP_POWER-IAxxxxS_THT
Q1, Q2, Q5, Q6: NPN; SOT95P240X120-3N
Q3, Q4: APC-817A1-SL; APC817A1SL; Manufacturer_Part_Number APC-817A1-SL
Q7, Q8, Q9, Q10: SI7489DP-T1-GE3; SI7141DPT1GE3; Manufacturer_Part_Number SI7489DP-T1-GE3; Mouser Part Number 781-SI7489DP-T1-GE3
R12, R13: 100k; R_0805_2012Metric
R14, R15, R24, R25: 10R; R_0805_2012Metric
R16, R17, R26, R27: 510R; R_0805_2012Metric
R18, R19, R20, R21, R22, R23: 100R; R_0805_2012Metric
R28, R29: 0R; R_0603_1608Metric; not fitted
U1, U2: 178.6165.0002; 17861650002; Mouser Part Number 576-178.6165.0002
Z1, Z2: BZB84-C4V7-QR; SOT95P230X110-3N; Manufacturer_Part_Number BZB84-C4V7-QR

Connections:
+3.3V: Q1.3 (C), Q2.3 (C); also elsewhere on the board
+5V: C41.1, C42.1, IC7.5 (VCC), IC8.5 (VCC), R22.2, R23.2; also elsewhere on the board
+12V: C30.1, C32.1, R14.1, R15.1; also elsewhere on the board
GND: C29.1, C30.2, C31.1, C32.2, C33.2, C34.2, C35.2, C36.2, C37.2, C38.2, C41.2, C42.2, D3.1 (K1), D4.1 (K1), D7.1 (K), D8.1 (K), IC7.2 (GND), IC8.2 (GND), J3.2 (Ext), J4.2 (Ext), PS1.2 (-Vin), PS2.2 (-Vin), Q3.2 (CATHODE), Q4.2 (CATHODE), Q5.2 (E), Q6.2 (E), R12.1, R13.1, Z1.3, Z2.3; also elsewhere on the board
IO_SWITCH_HIGH_1: C39.1, PS1.6 (+Vout), Q7.5 (D_1), Q7.6 (D_2), Q7.7 (D_3), Q7.8 (D_4), Q7.9 (D_5), Q7.10 (D_6), Q7.11 (D_7), R28.2; also elsewhere on the board
IO_SWITCH_HIGH_2: C40.1, PS2.6 (+Vout), Q9.5 (D_1), Q9.6 (D_2), Q9.7 (D_3), Q9.8 (D_4), Q9.9 (D_5), Q9.10 (D_6), Q9.11 (D_7), R29.2; also elsewhere on the board
IO_SWITCH_LOW_1: U1.5, U1.6, U1.7, U1.8; also elsewhere on the board
IO_SWITCH_LOW_2: U2.5, U2.6, U2.7, U2.8; also elsewhere on the board
MCU_GPIO_MOSFET1: IC7.1 (Y1); also elsewhere on the board
MCU_GPIO_MOSFET2: IC8.1 (Y1); also elsewhere on the board
MCU_GPIO_MUX1: IC7.6 (S), R19.2; also elsewhere on the board
MCU_GPIO_MUX2: IC8.6 (S), R21.2; also elsewhere on the board
unnamed: C29.2, J3.3, J3.4, R12.2
unnamed: C31.2, J4.3, J4.4, R13.2
unnamed: C33.1, D3.2 (K2), J3.1 (In), R16.2
unnamed: C34.1, D4.2 (K2), J4.1 (In), R17.2
unnamed: D5.2 (A), R19.1
unnamed: D5.1 (K), Q5.1 (B)
unnamed: D6.2 (A), R21.1
unnamed: D6.1 (K), Q6.1 (B)
unnamed: D7.2 (A), Q5.3 (C), R22.1
unnamed: D8.2 (A), Q6.3 (C), R23.1
unnamed: C43.2, D9.2 (A), Q7.4 (G), Q8.4 (G), R24.2, R26.1
unnamed: C43.1, D9.1 (K), Q7.1 (S_1), Q7.2 (S_2), Q7.3 (S_3), Q8.1 (S_1), Q8.2 (S_2), Q8.3 (S_3), R26.2, R28.1
unnamed: C44.2, D10.2 (A), Q9.4 (G), Q10.4 (G), R25.2, R27.1
unnamed: C44.1, D10.1 (K), Q9.1 (S_1), Q9.2 (S_2), Q9.3 (S_3), Q10.1 (S_1), Q10.2 (S_2), Q10.3 (S_3), R27.2, R29.1
unnamed: IC7.3 (Y0), Q1.2 (E)
unnamed: IC7.4 (Z), R18.1
unnamed: IC8.3 (Y0), Q2.2 (E)
unnamed: IC8.4 (Z), R20.1
unnamed: C35.1, PS1.1 (+Vin), R14.2
unnamed: C36.1, PS2.1 (+Vin), R15.2
unnamed: Q1.1 (B), R16.1, Z1.1, Z1.2
unnamed: Q2.1 (B), R17.1, Z2.1, Z2.2
unnamed: Q3.1 (ANODE), R18.2
unnamed: Q3.4 (COLLECTOR), R24.1
unnamed: Q4.1 (ANODE), R20.2
unnamed: Q4.4 (COLLECTOR), R25.1
unnamed: Q8.5 (D_1), Q8.6 (D_2), Q8.7 (D_3), Q8.8 (D_4), Q8.9 (D_5), Q8.10 (D_6), Q8.11 (D_7), U1.1, U1.2, U1.3, U1.4
unnamed: Q10.5 (D_1), Q10.6 (D_2), Q10.7 (D_3), Q10.8 (D_4), Q10.9 (D_5), Q10.10 (D_6), Q10.11 (D_7), U2.1, U2.2, U2.3, U2.4
VSS1: C37.1, C39.2, PS1.4 (-Vout), Q3.3 (EMITTER)
VSS2: C38.1, C40.2, PS2.4 (-Vout), Q4.3 (EMITTER)

Notes on the sheet:
MOSFET BACKtoBACK
DC/DC MOSFET

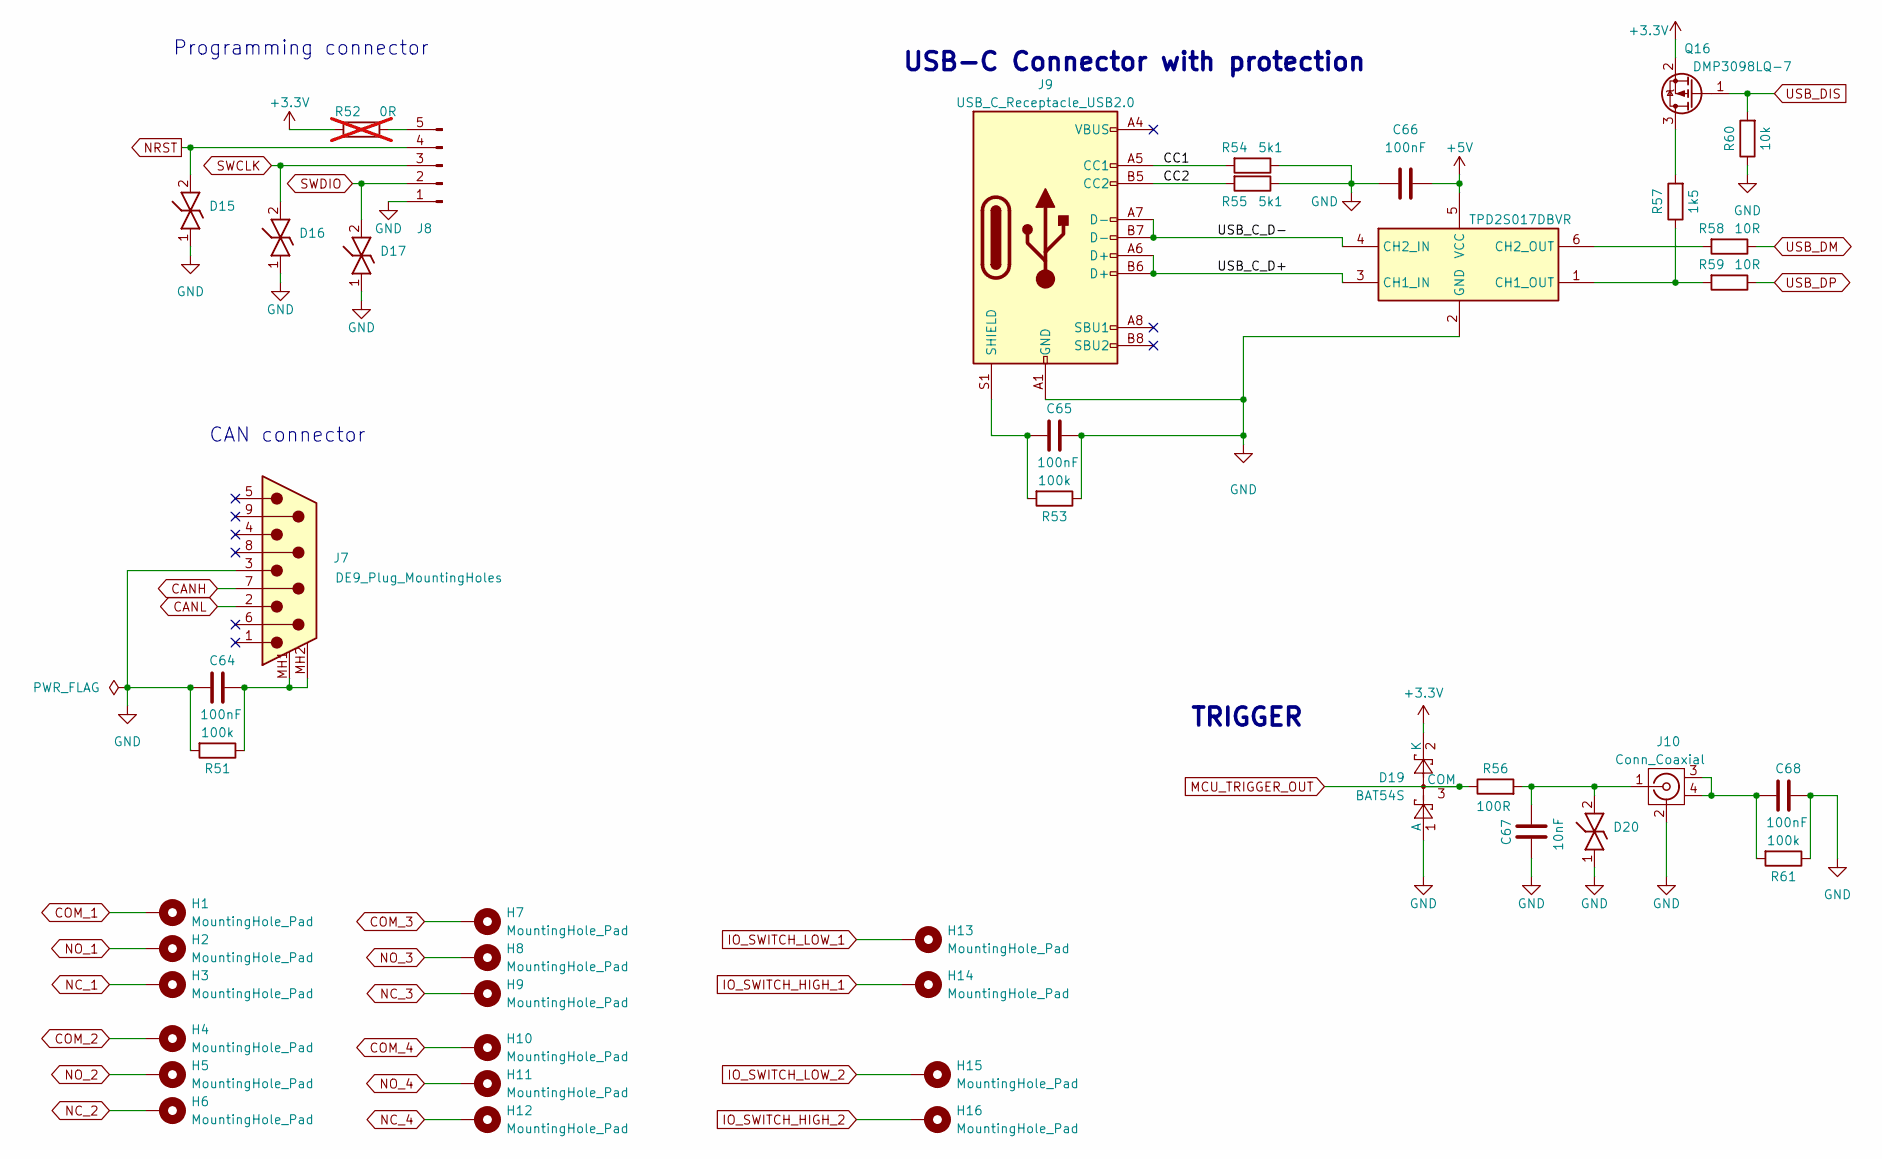
[picture p135: schematic Connections.kicad_sch, Automated Electrical Testing System]

Parts:
C64, C65, C66, C68: 100nF; C_0805_2012Metric
C67: 10nF; C_0805_2012Metric
D15, D16, D17, D20: TESDU5V0 RGG; DIONC1608X70N; Manufacturer_Part_Number TESDU5V0 RGG
D18: TPD2S017DBVR; SOT95P280X145-6N; Manufacturer_Part_Number TPD2S017DBVR; Mouser Part Number 595-TPD2S017DBVR
D19: BAT54S; SOT-23
H1, H2, H3, H4, H5, H6, H7, H8, H9, H10, H11, H12, H13, H14, H15, H16: MountingHole_Pad; MountingHole_2.2mm_M2_Pad_Via
J7: DE9_Plug_MountingHoles; G17C0910132EU
J8: Conn_01x05_Pin; PinHeader_1x05_P2.54mm_Vertical
J9: USB_C_Receptacle_USB2.0; USB_C_Receptacle_GCT_USB4105-xx-A_16P_TopMnt_Horizontal
J10: Conn_Coaxial; VBI211
Q16: DMP3098LQ-7; SOT96P240X110-3N
R51, R53, R61: 100k; R_0805_2012Metric
R52: 0R; R_0603_1608Metric; not fitted
R54, R55: 5k1; R_0805_2012Metric
R56: 100R; R_0805_2012Metric
R57: 1k5; R_0603_1608Metric
R58, R59: 10R; R_0805_2012Metric
R60: 10k; R_0805_2012Metric

Connections:
+3.3V: D19.2 (K), Q16.2 (S), R52.1; also elsewhere on the board
+5V: C66.2, D18.5 (VCC); also elsewhere on the board
/Connections/CC1: J9.A5 (CC1), R54.2
/Connections/CC2: J9.B5 (CC2), R55.2
/Connections/USB_C_D+: D18.3 (CH1_IN), J9.A6 (D+), J9.B6 (D+)
/Connections/USB_C_D-: D18.4 (CH2_IN), J9.A7 (D-), J9.B7 (D-)
CANH: J7.7; also elsewhere on the board
CANL: J7.2; also elsewhere on the board
COM_1: H1.1; also elsewhere on the board
COM_2: H4.1; also elsewhere on the board
COM_3: H7.1; also elsewhere on the board
COM_4: H10.1; also elsewhere on the board
GND: C64.2, C65.1, C66.1, C67.2, C68.1, D15.1 (K1), D16.1 (K1), D17.1 (K1), D18.2 (GND), D19.1 (A), D20.1 (K1), J7.3, J8.1, J9.A1 (GND), J9.A12 (GND), J9.B1 (GND), J9.B12 (GND), J10.2 (Ext), R51.2, R53.1, R54.1, R55.1, R60.1, R61.1; also elsewhere on the board
IO_SWITCH_HIGH_1: H14.1; also elsewhere on the board
IO_SWITCH_HIGH_2: H16.1; also elsewhere on the board
IO_SWITCH_LOW_1: H13.1; also elsewhere on the board
IO_SWITCH_LOW_2: H15.1; also elsewhere on the board
MCU_TRIGGER_OUT: D19.3 (COM), R56.1; also elsewhere on the board
NC_1: H3.1; also elsewhere on the board
NC_2: H6.1; also elsewhere on the board
NC_3: H9.1; also elsewhere on the board
NC_4: H12.1; also elsewhere on the board
NO_1: H2.1; also elsewhere on the board
NO_2: H5.1; also elsewhere on the board
NO_3: H8.1; also elsewhere on the board
NO_4: H11.1; also elsewhere on the board
NRST: D15.2 (K2), J8.4; also elsewhere on the board
unnamed: C64.1, J7.MH1 (PAD), J7.MH2 (PAD), R51.1
unnamed: C68.2, J10.3, J10.4, R61.2
unnamed: D18.1 (CH1_OUT), R57.1, R59.2
unnamed: D18.6 (CH2_OUT), R58.2
unnamed: C67.1, D20.2 (K2), J10.1 (In), R56.2
unnamed: J8.5, R52.2
unnamed: C65.2, J9.S1 (SHIELD), R53.2
unnamed: Q16.3 (D), R57.2
SWCLK: D16.2 (K2), J8.3; also elsewhere on the board
SWDIO: D17.2 (K2), J8.2; also elsewhere on the board
USB_DIS: Q16.1 (G), R60.2; also elsewhere on the board
USB_DM: R58.1; also elsewhere on the board
USB_DP: R59.1; also elsewhere on the board

Notes on the sheet:
Programming connector
TRIGGER
USB-C Connector with protection
CAN connector

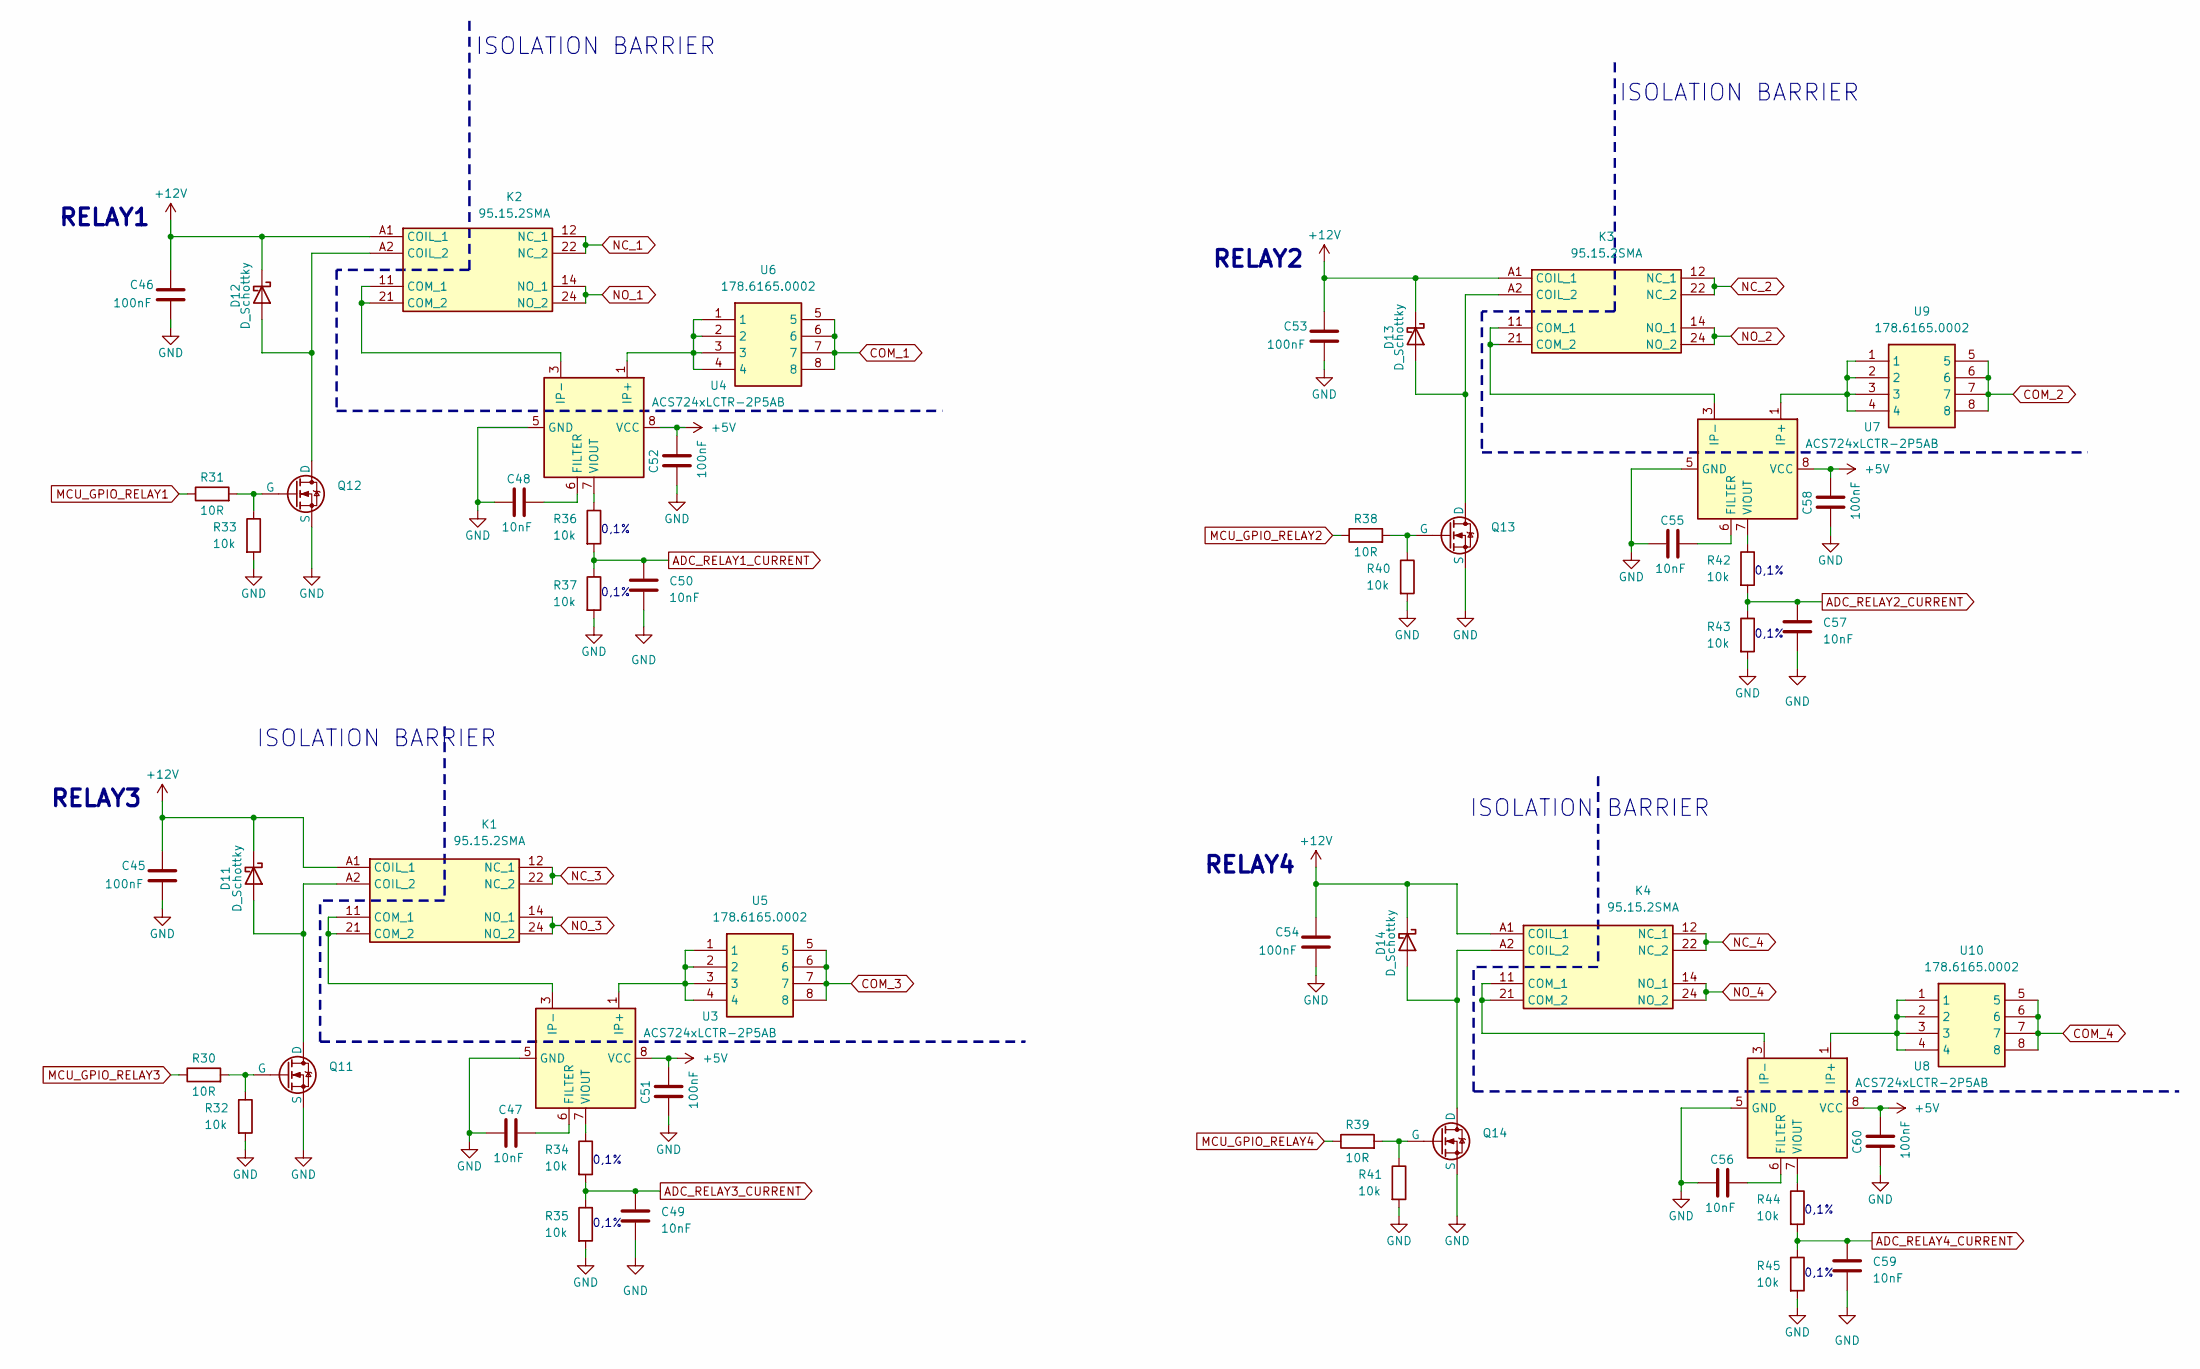
[picture p136: schematic RELAYS.kicad_sch, Automated Electrical Testing System]

Parts:
C45, C46, C51, C52, C53, C54, C58, C60: 100nF; C_0805_2012Metric
C47, C48, C49, C50, C55, C56, C57, C59: 10nF; C_0805_2012Metric
D11, D12, D13, D14: D_Schottky; SODFL3616X98N
K1, K2, K3, K4: 95.15.2SMA; 95152SMA; Manufacturer_Part_Number 95.15.2SMA
Q11, Q12, Q13, Q14: NMOS; SOT96P240X110-3N
R30, R31, R38, R39: 10R; R_0805_2012Metric
R32, R33, R34, R35, R36, R37, R40, R41, R42, R43, R44, R45: 10k; R_0805_2012Metric
U3, U4, U7, U8: ACS724xLCTR-2P5AB; SOIC-8_3.9x4.9mm_P1.27mm
U5, U6, U9, U10: 178.6165.0002; 17861650002; Mouser Part Number 576-178.6165.0002

Connections:
+5V: C51.1, C52.1, C58.1, C60.1, U3.8 (VCC), U4.8 (VCC), U7.8 (VCC), U8.8 (VCC); also elsewhere on the board
+12V: C45.1, C46.1, C53.1, C54.1, D11.1 (K), D12.1 (K), D13.1 (K), D14.1 (K), K1.A1 (COIL_1), K2.A1 (COIL_1), K3.A1 (COIL_1), K4.A1 (COIL_1); also elsewhere on the board
ADC_RELAY1_CURRENT: C50.1, R36.2, R37.1; also elsewhere on the board
ADC_RELAY2_CURRENT: C57.1, R42.2, R43.1; also elsewhere on the board
ADC_RELAY3_CURRENT: C49.1, R34.2, R35.1; also elsewhere on the board
ADC_RELAY4_CURRENT: C59.1, R44.2, R45.1; also elsewhere on the board
COM_1: U6.5, U6.6, U6.7, U6.8; also elsewhere on the board
COM_2: U9.5, U9.6, U9.7, U9.8; also elsewhere on the board
COM_3: U5.5, U5.6, U5.7, U5.8; also elsewhere on the board
COM_4: U10.5, U10.6, U10.7, U10.8; also elsewhere on the board
GND: C45.2, C46.2, C47.2, C48.2, C49.2, C50.2, C51.2, C52.2, C53.2, C54.2, C55.2, C56.2, C57.2, C58.2, C59.2, C60.2, Q11.2 (S), Q12.2 (S), Q13.2 (S), Q14.2 (S), R32.2, R33.2, R35.2, R37.2, R40.2, R41.2, R43.2, R45.2, U3.5 (GND), U4.5 (GND), U7.5 (GND), U8.5 (GND); also elsewhere on the board
MCU_GPIO_RELAY1: R31.1; also elsewhere on the board
MCU_GPIO_RELAY2: R38.1; also elsewhere on the board
MCU_GPIO_RELAY3: R30.1; also elsewhere on the board
MCU_GPIO_RELAY4: R39.1; also elsewhere on the board
NC_1: K2.12 (NC_1), K2.22 (NC_2); also elsewhere on the board
NC_2: K3.12 (NC_1), K3.22 (NC_2); also elsewhere on the board
NC_3: K1.12 (NC_1), K1.22 (NC_2); also elsewhere on the board
NC_4: K4.12 (NC_1), K4.22 (NC_2); also elsewhere on the board
NO_1: K2.14 (NO_1), K2.24 (NO_2); also elsewhere on the board
NO_2: K3.14 (NO_1), K3.24 (NO_2); also elsewhere on the board
NO_3: K1.14 (NO_1), K1.24 (NO_2); also elsewhere on the board
NO_4: K4.14 (NO_1), K4.24 (NO_2); also elsewhere on the board
unnamed: D11.2 (A), K1.A2 (COIL_2), Q11.3 (D)
unnamed: D12.2 (A), K2.A2 (COIL_2), Q12.3 (D)
unnamed: D13.2 (A), K3.A2 (COIL_2), Q13.3 (D)
unnamed: D14.2 (A), K4.A2 (COIL_2), Q14.3 (D)
unnamed: K1.11 (COM_1), K1.21 (COM_2), U3.3 (IP-), U3.4 (IP-)
unnamed: K2.11 (COM_1), K2.21 (COM_2), U4.3 (IP-), U4.4 (IP-)
unnamed: K3.11 (COM_1), K3.21 (COM_2), U7.3 (IP-), U7.4 (IP-)
unnamed: K4.11 (COM_1), K4.21 (COM_2), U8.3 (IP-), U8.4 (IP-)
unnamed: Q11.1 (G), R30.2, R32.1
unnamed: Q12.1 (G), R31.2, R33.1
unnamed: Q13.1 (G), R38.2, R40.1
unnamed: Q14.1 (G), R39.2, R41.1
unnamed: C47.1, U3.6 (FILTER)
unnamed: U3.1 (IP+), U3.2 (IP+), U5.1, U5.2, U5.3, U5.4
unnamed: R34.1, U3.7 (VIOUT)
unnamed: C48.1, U4.6 (FILTER)
unnamed: U4.1 (IP+), U4.2 (IP+), U6.1, U6.2, U6.3, U6.4
unnamed: R36.1, U4.7 (VIOUT)
unnamed: C55.1, U7.6 (FILTER)
unnamed: U7.1 (IP+), U7.2 (IP+), U9.1, U9.2, U9.3, U9.4
unnamed: R42.1, U7.7 (VIOUT)
unnamed: C56.1, U8.6 (FILTER)
unnamed: R44.1, U8.7 (VIOUT)
unnamed: U8.1 (IP+), U8.2 (IP+), U10.1, U10.2, U10.3, U10.4

Notes on the sheet:
0,1%
RELAY3
RELAY2
ISOLATION BARRIER
RELAY1
RELAY4
