MrMicek/AETS/HW/KiCad/AETS/AETS-CZ-NB-3L0Y7S3.kicad_pcb

## KiCad design HW/KiCad/AETS/AETS-CZ-NB-3L0Y7S3.kicad_pcb (continued)

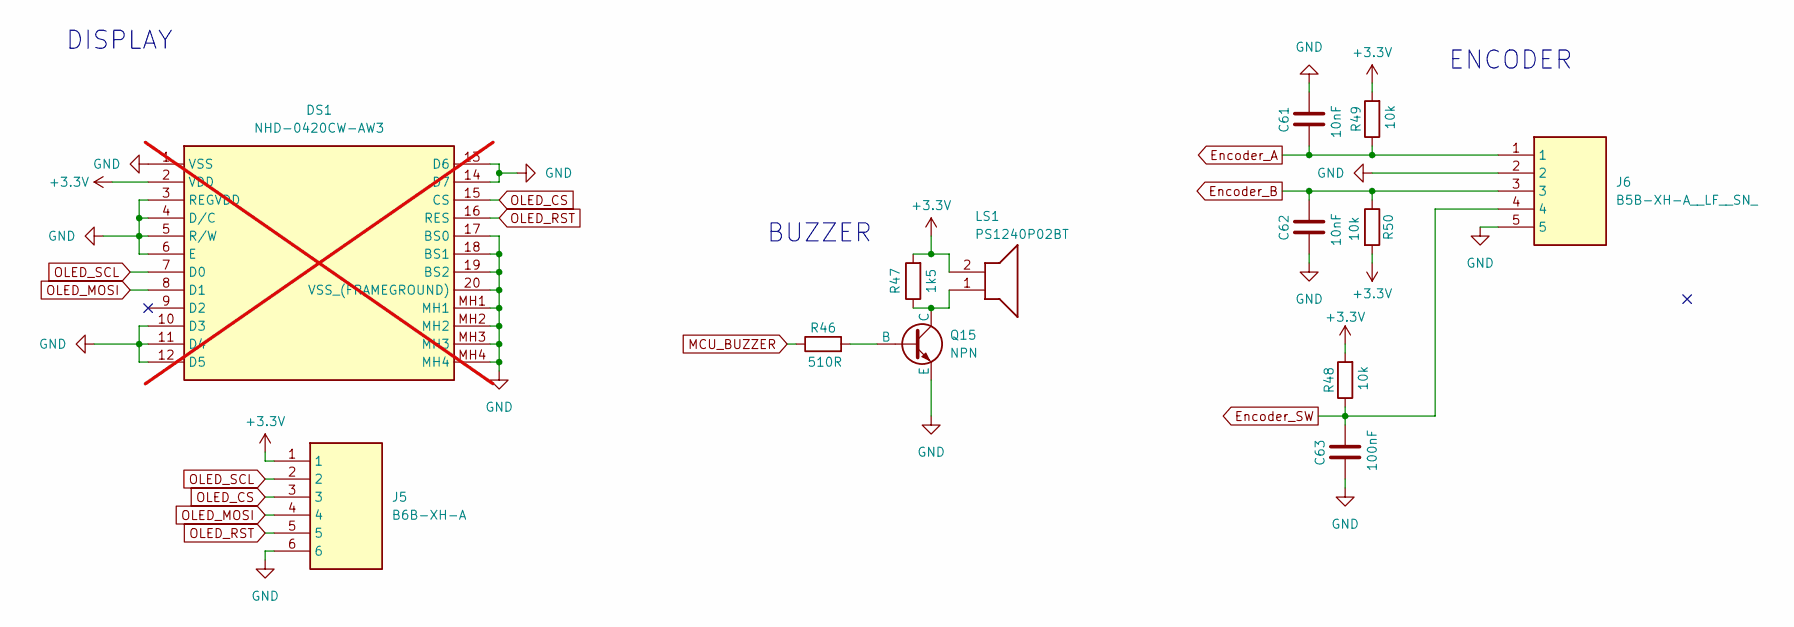
[picture p137: schematic UI.kicad_sch, Automated Electrical Testing System]

Parts:
C61, C62: 10nF; C_0805_2012Metric
C63: 100nF; C_0805_2012Metric
DS1: NHD-0420CW-AW3; NHD0420CWAW3; Manufacturer_Part_Number NHD-0420CW-AW3; not fitted
J5: B6B-XH-A; B6BXHA; Manufacturer_Part_Number B6B-XH-A
J6: B5B-XH-A__LF__SN_; SHDR5W64P0X250_1X5_1490X575X700P; Manufacturer_Part_Number B5B-XH-A (LF)(SN)
LS1: PS1240P02BT; Mouser Part Number 810-PS1240P02BT
Q15: NPN; SOT95P240X120-3N
R46: 510R; R_0805_2012Metric
R47: 1k5; R_0603_1608Metric
R48, R49, R50: 10k; R_0805_2012Metric

Connections:
+3.3V: DS1.2 (VDD), J5.1, LS1.2, R47.2, R48.2, R49.2, R50.2; also elsewhere on the board
Encoder_A: C61.2, J6.1, R49.1; also elsewhere on the board
Encoder_B: C62.1, J6.3, R50.1; also elsewhere on the board
Encoder_SW: C63.1, J6.4, R48.1; also elsewhere on the board
GND: C61.1, C62.2, C63.2, DS1.1 (VSS), DS1.3 (REGVDD), DS1.4 (D/C), DS1.5 (R/W), DS1.6 (E), DS1.10 (D3), DS1.11 (D4), DS1.12 (D5), DS1.13 (D6), DS1.14 (D7), DS1.17 (BS0), DS1.18 (BS1), DS1.19 (BS2), DS1.20 (VSS_(FRAMEGROUND)), DS1.MH1, DS1.MH2, DS1.MH3, DS1.MH4, J5.6, J6.2, J6.5, Q15.2 (E); also elsewhere on the board
MCU_BUZZER: R46.1; also elsewhere on the board
unnamed: Q15.1 (B), R46.2
unnamed: LS1.1, Q15.3 (C), R47.1
OLED_CS: DS1.15 (CS), J5.3; also elsewhere on the board
OLED_MOSI: DS1.8 (D1), J5.4; also elsewhere on the board
OLED_RST: DS1.16 (RES), J5.5; also elsewhere on the board
OLED_SCL: DS1.7 (D0), J5.2; also elsewhere on the board

Notes on the sheet:
BUZZER
DISPLAY
ENCODER

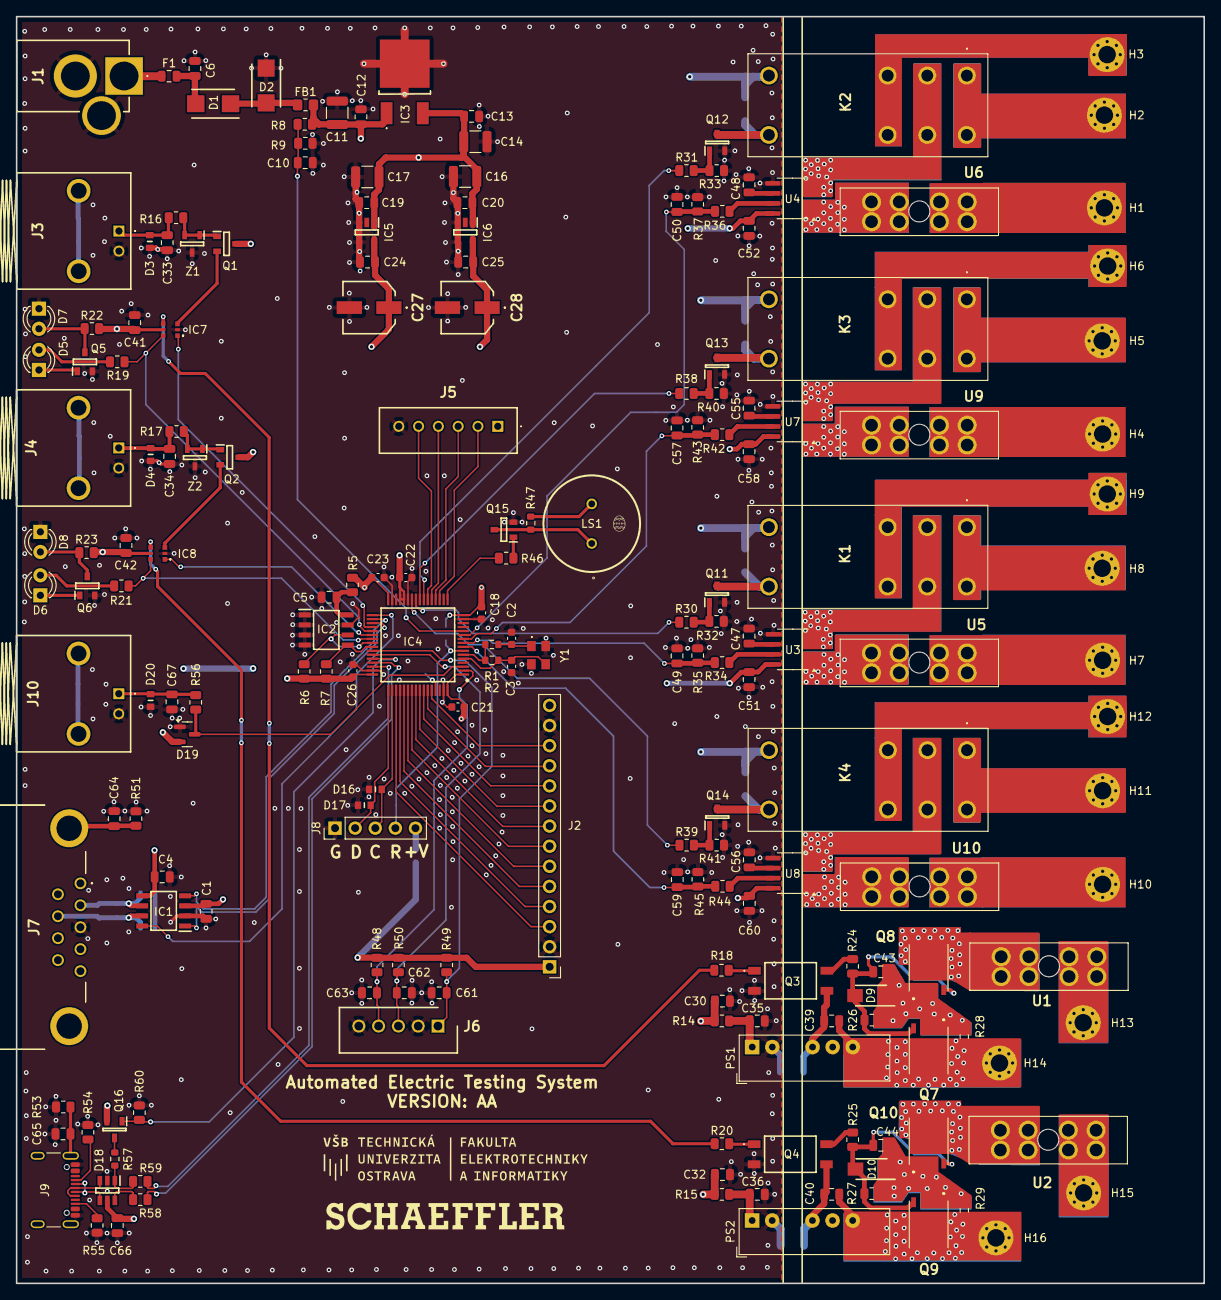
[picture p138: board AETS-CZ-NB-3L0Y7S3.kicad_pcb from above]

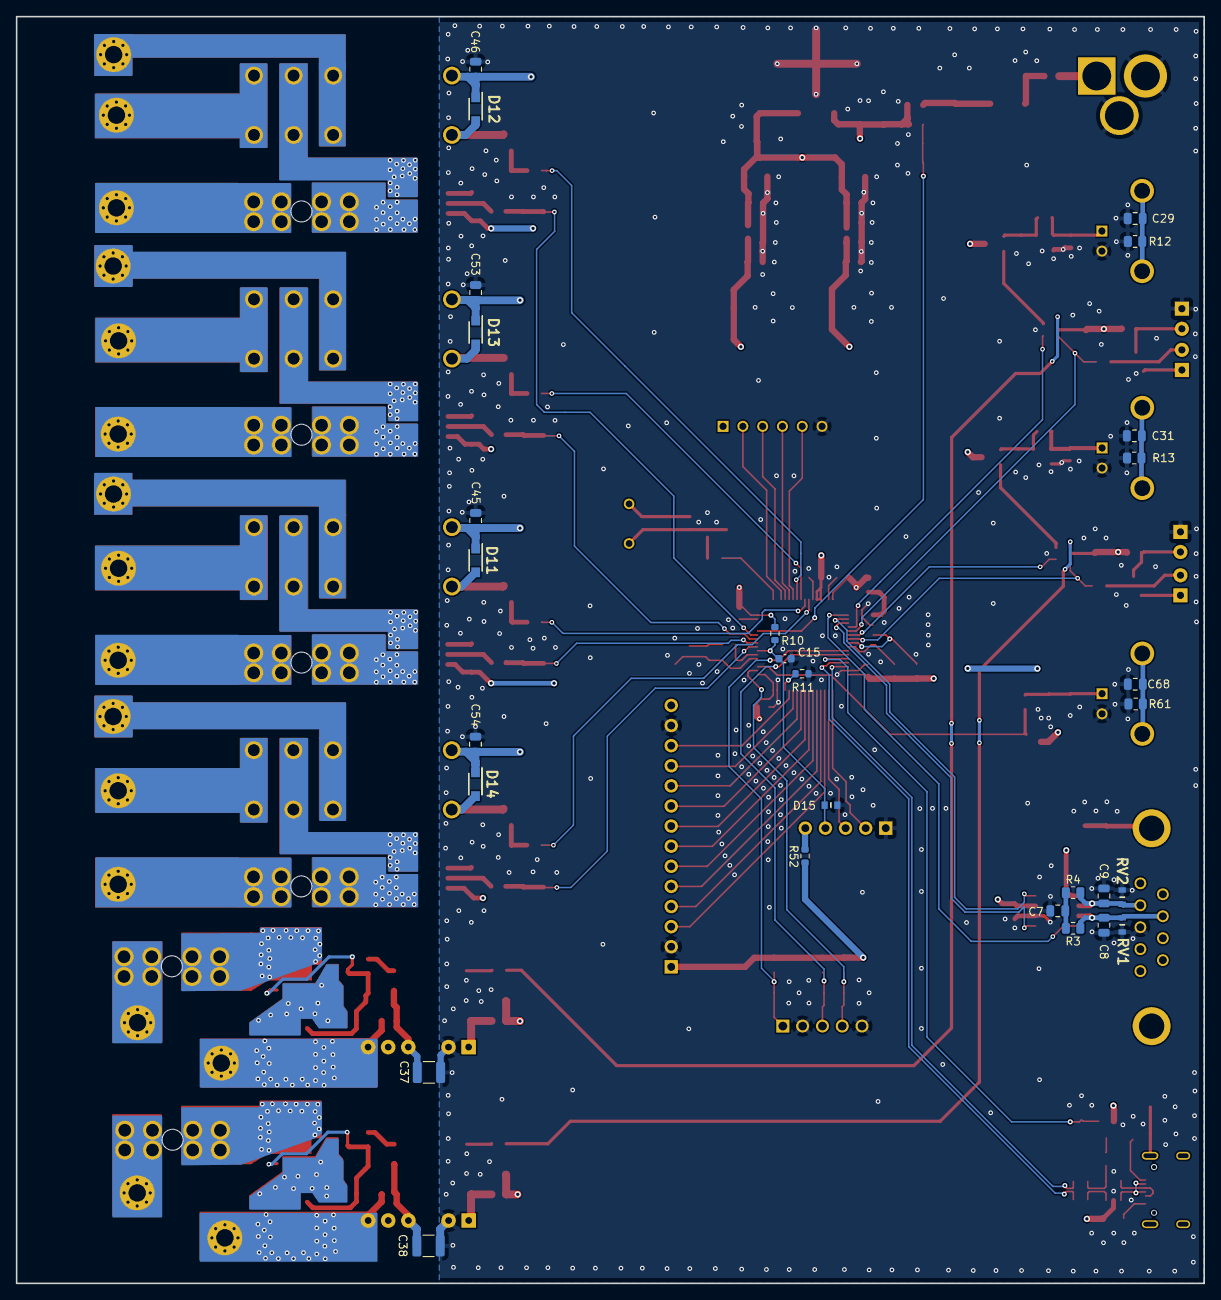
[picture p139: board AETS-CZ-NB-3L0Y7S3.kicad_pcb from below]

Board: 4 copper layers, 150.0 x 160.0 mm, 223 parts (28 on the bottom side), 143 nets.
