MrMicek/AETS/SW/AETS/Core/Src/main.c

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
/* Includes ------------------------------------------------------------------*/
#include "main.h"
#include "adc.h"
#include "crc.h"
#include "fdcan.h"
#include "i2c.h"
#include "spi.h"
#include "tim.h"
#include "usb_device.h"
#include "gpio.h"

/* USER CODE BEGIN Includes */
#include "relay.h"
#include "mosfet.h"
#include "mux.h"
#include "current.h"
#include "power.h"
#include "buzzer.h"
#include "trigger.h"
#include "display.h"
#include <string.h>
#include "comuser.h"
#include "encoder.h"
#include "canfd.h"
#include "kvstore.h"  // <- added
#include "menu.h"
#include "app_menu.h"
#include "app_sm.h"
#include "io_control.h"
#include "relay_counter.h"
#include "app_params.h"
#include "relay_health_store.h"
#include "telemetry.h"

/* USER CODE END Includes */

/* USER CODE BEGIN PTD */



// --- measure VDDA/VREF+ in millivolts using factory-trimmed VREFINT ---

/* USER CODE END PTD */


void SystemClock_Config(void);
/**
  * @brief  The application entry point.
  * @retval int
  */
int main(void)
{

  /* MCU Configuration--------------------------------------------------------*/

  /* Reset of all peripherals, Initializes the Flash interface and the Systick. */
  HAL_Init();

  /* Configure the system clock */
  SystemClock_Config();

  /* Initialize all configured peripherals */
  MX_GPIO_Init();
  MX_I2C3_Init();
  MX_FDCAN2_Init();
  MX_ADC1_Init();
  MX_ADC2_Init();
  MX_TIM1_Init();
  MX_TIM5_Init();
  MX_TIM2_Init();
  MX_USB_Device_Init();
  MX_SPI1_Init();
  MX_CRC_Init();
  /* USER CODE BEGIN 2 */


  oled_init();
  comu_Init();
  Relay_Init();
  MOSFET_Init();
  MUX_Init();
  io_init();
  Power_InitBrownout();
  Buzzer_Init();
  HAL_Delay(1500); //init screen visible time
  Trigger_Init();
  cfd_Init();
  KV_Init();
  app_params_init();
  relay_health_init();
  relay_counter_init();
  oled_demo();
  Current_Init();
  app_menu_init();
  app_init();






  /* USER CODE END 2 */

  /* Infinite loop */
  /* USER CODE BEGIN WHILE */
  while (1)
  {

    uint32_t now = HAL_GetTick();
    /* Highest priority: brownout/pending saves */
    KV_HandlePending();
    relay_health_handle_pending();

    /* Core state machine and output sequencing */
    app_tick(now);
    relay_counter_periodic_flush(now);

    /* Test telemetry only when test is active */
    app_status_t st = app_get_status();
    if (st.state == APP_STATE_TEST && st.test_state == APP_TEST_RUNNING) {
      telemetry_tick(now);
    }

    /* Lowest priority: UI and communication */
    comu_HandleCommunication();
    app_menu_task();


    /* USER CODE END WHILE */

    /* USER CODE BEGIN 3 */
  }
  /* USER CODE END 3 */
}

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
/**
  * @brief  Period elapsed callback in non blocking mode
  * @note   This function is called  when TIM6 interrupt took place, inside
  * HAL_TIM_IRQHandler(). It makes a direct call to HAL_IncTick() to increment
  * a global variable "uwTick" used as application time base.
  * @param  htim : TIM handle
  * @retval None
  */
void HAL_TIM_PeriodElapsedCallback(TIM_HandleTypeDef *htim)
{
  if (htim->Instance == TIM6)
  {
    HAL_IncTick();
  }
}

/**
  * @brief  This function is executed in case of error occurrence.
  * @retval None
  */
void Error_Handler(void)
{
  /* USER CODE BEGIN Error_Handler_Debug */
  /* User can add his own implementation to report the HAL error return state */
  __disable_irq();
  while (1)
  {
  }
  /* USER CODE END Error_Handler_Debug */
}
#ifdef USE_FULL_ASSERT
/**
  * @brief  Reports the name of the source file and the source line number
  *         where the assert_param error has occurred.
  * @param  file: pointer to the source file name
  * @param  line: assert_param error line source number
  * @retval None
  */
void assert_failed(uint8_t *file, uint32_t line)
{
  /* USER CODE BEGIN 6 */
  /* User can add his own implementation to report the file name and line number,
     ex: printf("Wrong parameters value: file %s on line %d\r\n", file, line) */
  /* USER CODE END 6 */
}
#endif /* USE_FULL_ASSERT */
