MrMicek/AETS/SW/AETS/AETS.ioc

Mcu.UserName=STM32G474RETx
PA0.GPIO_Label=ADC_VBUS
PA0.Signal=ADC2_IN1
PA1.GPIO_Label=NOTUSED
PA1.Signal=GPIO_Output
PA10.GPIO_Label=USB_DIS
PA10.Signal=GPIO_Output
PA11.Signal=USB_DM
PA12.Signal=USB_DP
PA13.Signal=SYS_JTMS-SWDIO
PA14.Signal=SYS_JTCK-SWCLK
PA15.GPIO_Label=NOTUSED
PA15.Signal=GPIO_Output
PA2.GPIO_Label=NOTUSED
PA2.Signal=GPIO_Output
PA3.GPIO_Label=BUZZER
PA3.Signal=S_TIM5_CH4
PA4.GPIO_Label=NOTUSED
PA4.Signal=GPIO_Output
PA5.GPIO_Label=OLED_SCK
PA5.Signal=SPI1_SCK
PA6.GPIO_Label=OLED_CS
PA6.Signal=GPIO_Output
PA7.GPIO_Label=OLED_MOSI
PA7.Signal=SPI1_MOSI
PA8.GPIO_Label=ENCODER_A
PA8.Signal=S_TIM1_CH1
PA9.GPIO_Label=ENCODER_B
PA9.Signal=S_TIM1_CH2
PB0.GPIO_Label=GPIO_RELAY2
PB0.Signal=GPIO_Output
PB1.GPIO_Label=GPIO_RELAY3
PB1.Signal=GPIO_Output
PB10.GPIO_Label=NOTUSED
PB10.Signal=GPIO_Output
PB11.GPIO_Label=CAN_STB
PB11.Signal=GPIO_Output
PB12.GPIO_Label=CAN_RXD
PB12.Signal=FDCAN2_RX
PB13.GPIO_Label=CAN_TXD
PB13.Signal=FDCAN2_TX
PB14.GPIO_Label=GPIO_MOSFET1
PB14.Signal=GPIO_Output
PB15.GPIO_Label=GPIO_MUX1
PB15.Signal=GPIO_Output
PB2.GPIO_Label=GPIO_RELAY4
PB2.Signal=GPIO_Output
PB3.GPIO_Label=NOTUSED
PB3.Signal=GPIO_Output
PB4.GPIO_Label=NOTUSED
PB4.Signal=GPIO_Output
PB5.GPIO_Label=NOTUSED
PB5.Signal=GPIO_Output
PB6.GPIO_Label=NOTUSED
PB6.Signal=GPIO_Output
PB7.GPIO_Label=NOTUSED
PB7.Signal=GPIO_Output
PB9.GPIO_Label=NOTUSED
PB9.Signal=GPIO_Output
PC0.GPIO_Label=ADC_RELAY4
PC0.Signal=ADC1_IN6
PC1.GPIO_Label=ADC_RELAY3
PC1.Signal=ADC1_IN7
PC10.GPIO_Label=NOTUSED
PC10.Signal=GPIO_Output
PC11.GPIO_Label=NOTUSED
PC11.Signal=GPIO_Output
PC12.GPIO_Label=NOTUSED
PC12.Signal=GPIO_Output
PC13.GPIO_Label=ENCODER_SW
PC13.Signal=GPXTI13
PC14-OSC32_IN.GPIO_Label=TRIGGER_OUT
PC14-OSC32_IN.Signal=GPIO_Output
PC15-OSC32_OUT.GPIO_Label=NOTUSED
PC15-OSC32_OUT.Signal=GPIO_Output
PC2.GPIO_Label=ADC_RELAY2
PC2.Signal=ADC1_IN8
PC3.GPIO_Label=ADC_RELAY1
PC3.Signal=ADC1_IN9
PC4.GPIO_Label=OLED_RST
PC4.Signal=GPIO_Output
PC5.GPIO_Label=GPIO_RELAY1
PC5.Signal=GPIO_Output
PC6.GPIO_Label=GPIO_MOSFET2
PC6.Signal=GPIO_Output
PC7.GPIO_Label=GPIO_MUX2
PC7.Signal=GPIO_Output
PC8.GPIO_Label=EEPROM_SCL
PC8.Signal=I2C3_SCL
PC9.GPIO_Label=EEPROM_SDA
PC9.Signal=I2C3_SDA
PD2.GPIO_Label=NOTUSED
PD2.Signal=GPIO_Output
PF0-OSC_IN.Signal=RCC_OSC_IN
PF1-OSC_OUT.Signal=RCC_OSC_OUT
