MrMicek/AETS/SW/AETS/Core/Inc/main.h

#define ENCODER_SW_Pin GPIO_PIN_13
#define ENCODER_SW_GPIO_Port GPIOC
#define ENCODER_SW_EXTI_IRQn EXTI15_10_IRQn
#define TRIGGER_OUT_Pin GPIO_PIN_14
#define TRIGGER_OUT_GPIO_Port GPIOC
#define NOTUSED_Pin GPIO_PIN_15
#define NOTUSED_GPIO_Port GPIOC
#define ADC_RELAY4_Pin GPIO_PIN_0
#define ADC_RELAY4_GPIO_Port GPIOC
#define ADC_RELAY3_Pin GPIO_PIN_1
#define ADC_RELAY3_GPIO_Port GPIOC
#define ADC_RELAY2_Pin GPIO_PIN_2
#define ADC_RELAY2_GPIO_Port GPIOC
#define ADC_RELAY1_Pin GPIO_PIN_3
#define ADC_RELAY1_GPIO_Port GPIOC
#define ADC_VBUS_Pin GPIO_PIN_0
#define ADC_VBUS_GPIO_Port GPIOA
#define NOTUSEDA1_Pin GPIO_PIN_1
#define NOTUSEDA1_GPIO_Port GPIOA
#define NOTUSEDA2_Pin GPIO_PIN_2
#define NOTUSEDA2_GPIO_Port GPIOA
#define BUZZER_Pin GPIO_PIN_3
#define BUZZER_GPIO_Port GPIOA
#define NOTUSEDA4_Pin GPIO_PIN_4
#define NOTUSEDA4_GPIO_Port GPIOA
#define OLED_SCK_Pin GPIO_PIN_5
#define OLED_SCK_GPIO_Port GPIOA
#define OLED_CS_Pin GPIO_PIN_6
#define OLED_CS_GPIO_Port GPIOA
#define OLED_MOSI_Pin GPIO_PIN_7
#define OLED_MOSI_GPIO_Port GPIOA
#define OLED_RST_Pin GPIO_PIN_4
#define OLED_RST_GPIO_Port GPIOC
#define GPIO_RELAY1_Pin GPIO_PIN_5
#define GPIO_RELAY1_GPIO_Port GPIOC
#define GPIO_RELAY2_Pin GPIO_PIN_0
#define GPIO_RELAY2_GPIO_Port GPIOB
#define GPIO_RELAY3_Pin GPIO_PIN_1
#define GPIO_RELAY3_GPIO_Port GPIOB
#define GPIO_RELAY4_Pin GPIO_PIN_2
#define GPIO_RELAY4_GPIO_Port GPIOB
#define NOTUSEDB10_Pin GPIO_PIN_10
#define NOTUSEDB10_GPIO_Port GPIOB
#define CAN_STB_Pin GPIO_PIN_11
#define CAN_STB_GPIO_Port GPIOB
#define CAN_RXD_Pin GPIO_PIN_12
#define CAN_RXD_GPIO_Port GPIOB
#define CAN_TXD_Pin GPIO_PIN_13
#define CAN_TXD_GPIO_Port GPIOB
#define GPIO_MOSFET1_Pin GPIO_PIN_14
#define GPIO_MOSFET1_GPIO_Port GPIOB
#define GPIO_MUX1_Pin GPIO_PIN_15
#define GPIO_MUX1_GPIO_Port GPIOB
#define GPIO_MOSFET2_Pin GPIO_PIN_6
#define GPIO_MOSFET2_GPIO_Port GPIOC
#define GPIO_MUX2_Pin GPIO_PIN_7
#define GPIO_MUX2_GPIO_Port GPIOC
#define EEPROM_SCL_Pin GPIO_PIN_8
#define EEPROM_SCL_GPIO_Port GPIOC
#define EEPROM_SDA_Pin GPIO_PIN_9
#define EEPROM_SDA_GPIO_Port GPIOC
#define ENCODER_A_Pin GPIO_PIN_8
#define ENCODER_A_GPIO_Port GPIOA
#define ENCODER_B_Pin GPIO_PIN_9
#define ENCODER_B_GPIO_Port GPIOA
#define USB_DIS_Pin GPIO_PIN_10
#define USB_DIS_GPIO_Port GPIOA
#define NOTUSEDA15_Pin GPIO_PIN_15
#define NOTUSEDA15_GPIO_Port GPIOA
#define NOTUSEDC10_Pin GPIO_PIN_10
#define NOTUSEDC10_GPIO_Port GPIOC
#define NOTUSEDC11_Pin GPIO_PIN_11
#define NOTUSEDC11_GPIO_Port GPIOC
#define NOTUSEDC12_Pin GPIO_PIN_12
#define NOTUSEDC12_GPIO_Port GPIOC
#define NOTUSEDD2_Pin GPIO_PIN_2
#define NOTUSEDD2_GPIO_Port GPIOD
#define NOTUSEDB3_Pin GPIO_PIN_3
#define NOTUSEDB3_GPIO_Port GPIOB
#define NOTUSEDB4_Pin GPIO_PIN_4
#define NOTUSEDB4_GPIO_Port GPIOB
#define NOTUSEDB5_Pin GPIO_PIN_5
#define NOTUSEDB5_GPIO_Port GPIOB
#define NOTUSEDB6_Pin GPIO_PIN_6
#define NOTUSEDB6_GPIO_Port GPIOB
#define NOTUSEDB7_Pin GPIO_PIN_7
#define NOTUSEDB7_GPIO_Port GPIOB
#define NOTUSEDB9_Pin GPIO_PIN_9
#define NOTUSEDB9_GPIO_Port GPIOB
