MrMicek/AETS/SW/AETS/Core/user_inc/telemetry.h

/*
 * telemetry.h
 *
 *  Created on: Nov 14, 2025
 */

#ifndef USER_INC_TELEMETRY_H_
#define USER_INC_TELEMETRY_H_

#include <stdint.h>

void telemetry_tick(uint32_t now_ms);

#endif /* USER_INC_TELEMETRY_H_ */
