MrMicek/AETS/SW/AETS/Core/user_inc/mux.h

/*
 * mux.h
 *
 *  Created on: Oct 2, 2025
 *      Author: user
 */

#ifndef USER_INC_MUX_H_
#define USER_INC_MUX_H_

typedef enum { MUX_EXT=0, MUX_INT=1 } mux_sel_t;

typedef enum { MUX_CH1 = 0, MUX_CH2 = 1, MUX_CH_COUNT } mux_channel_t;


void MUX_Init(void);
void MUX_Set(mux_channel_t ch, mux_sel_t sel);


/* Demo */
void MUX_Test(void);

#endif /* USER_INC_MUX_H_ */
