MrMicek/AETS/SW/AETS/Core/user_inc/commands.h

/*
 * commands.h
 *
 *  Created on: 8 Nov 2023
 *      Author: Standa
 */

#ifndef APPLICATION_COMMANDS_H_
#define APPLICATION_COMMANDS_H_

extern void cmd_Handle(char *str);

#endif /* APPLICATION_COMMANDS_H_ */
