MrMicek/AETS/(commit log)

2025-02-24 Created HW and SW folders, first schematic draft
    [AETS.kicad_pcb, AETS.kicad_sch]
2025-12-21 Fix command parsing after omitted IDs
    [commands.c]
2026-01-08 added changes to usb middleware, some files were missing so i regenerated the code from ioc. Changed one line in current.c, that was i need and absolu value of ma before checking if its under minimal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
    [AETS.ioc, current.c]
2026-01-08 Fix current polarity and relay counter save/load
    [app_sm.c, app_sm.h, commands.c, comuser.c, current.c, io_control.c, io_control.h, main.c]
2026-01-09 Add parameter storage and remote updates
    [parameter_test_plan.txt]
2026-01-15 testing was done according to the text file. some pieces of code needed to be modified.
    [AETS-CZ-NB-3L0Y7S3_vyplnena.xlsx, parameter_test_plan.txt]
2026-01-16 Add testing UI flow and remote gating
    [parameter_test_plan.txt]
2026-01-19 Persist relay health set and remaining counts
2026-01-20 Add test current monitoring and profile storage
2026-01-21 Fix test profile gating and current display
    [app_menu.c, app_params.c, app_params.h, app_sm.c, app_sm.h, io_control.c, kvstore.c, main.c]
2026-01-27 Run relay and mosfet sequences in parallel
2026-01-27 Run relay/mosfet channels concurrently
2026-01-28 Finnished version - few small tweaks remaining
    [DISPLAY SCREENS.xlsx]
2026-01-30 added param reset and param list profile commands. added new sounds for saving and loading profiles and added an option to reset parameters in manual mode.
    [app_menu.c, buzzer.c, buzzer.h, commands.c]
2026-02-16 relay fix + defining unused pins
    [AETS.ioc, main.h, test_seq.c]
2026-02-21 added right amount of switches to relays and better relay trigger selection
2026-03-16 added test
    [DISPLAY SCREENS.xlsx]
2026-03-23 umoznit vypnout current monitoring - default state
    umoznit zapnuti/vypnuti mosfetu a rele pomoci commandu
    navod na rozebrani krabicky
2026-03-26 added manual
    [Menu hiearchy.xlsx]
2026-04-02 added calibration feature to init screen
    [AETS-CZ-NB-3L0Y7S3_vyplnena.xlsx]
