MrMicek/AETS/(notices)

Notices in the files:
SW/AETS/Core/Src/adc.c:
Copyright (c) 2025 STMicroelectronics.
All rights reserved.
This software is licensed under terms that can be found in the LICENSE file
